jakkra/ZSWatch/.github/images/back_pcb_render.png

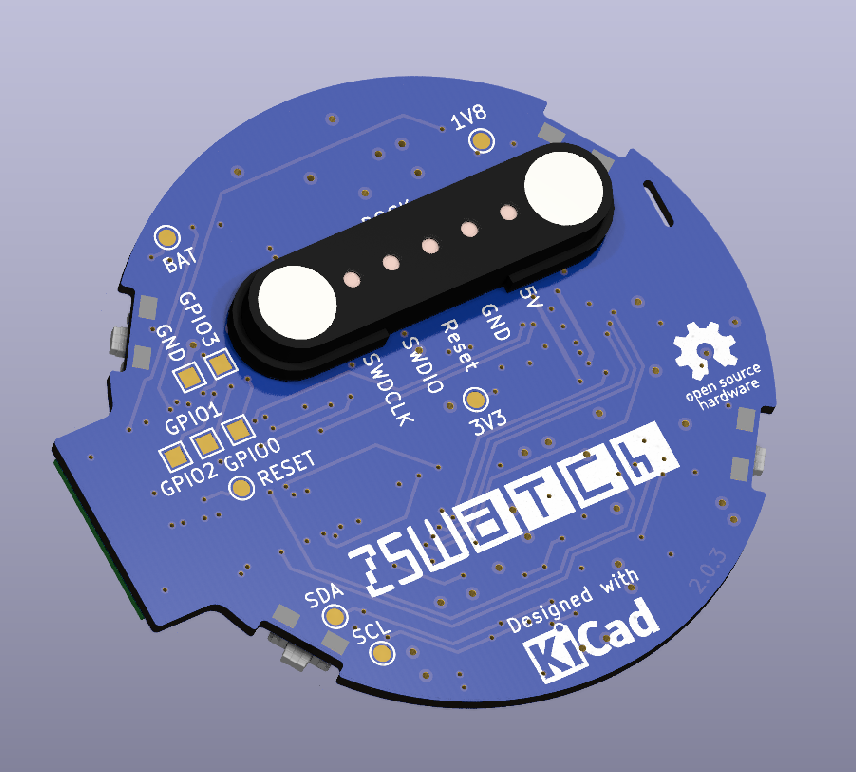
.github/images/back_pcb_render.png
