jakkra/ZSWatch/.github/images/dock_connect.jpg

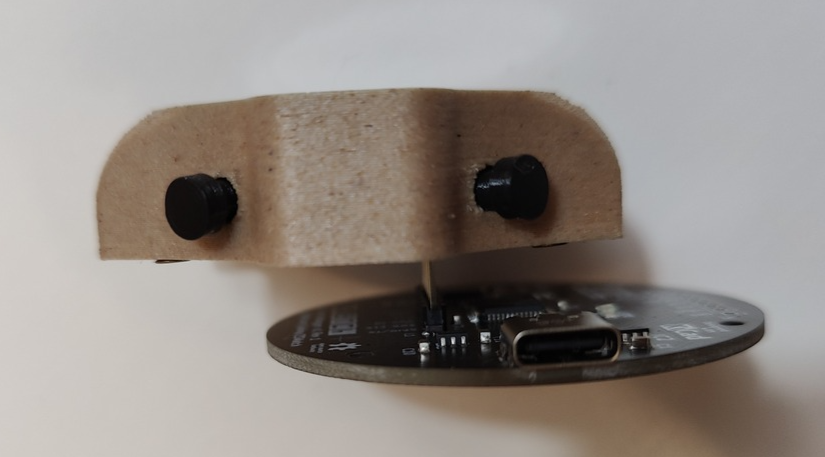
.github/images/dock_connect.jpg
