jakkra/ZSWatch/.github/images/front_pcb_render.png

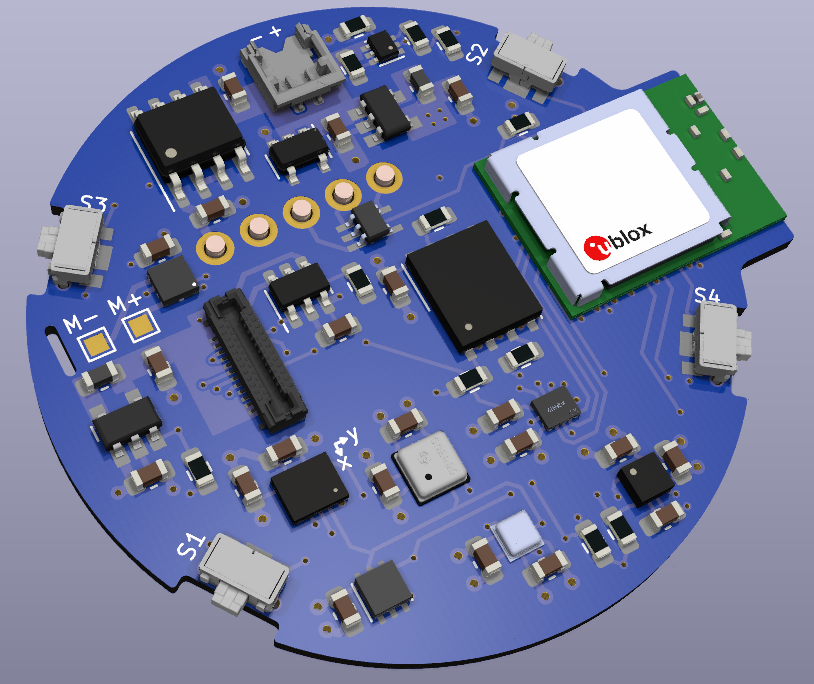
.github/images/front_pcb_render.png
