jakkra/ZSWatch/.github/images/layer1_and_4_v2.PNG

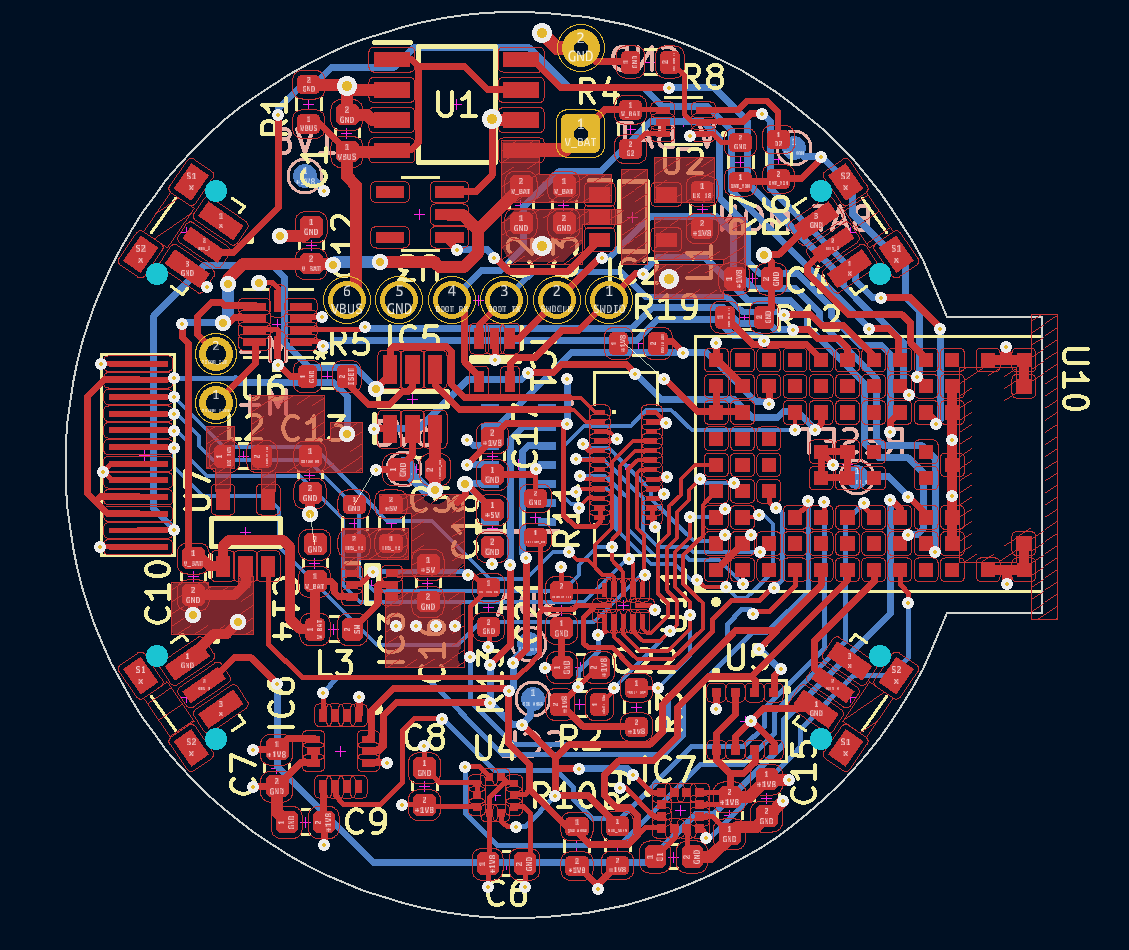
.github/images/layer1_and_4_v2.PNG
