jakkra/ZSWatch/.github/images/many_in_row.jpg

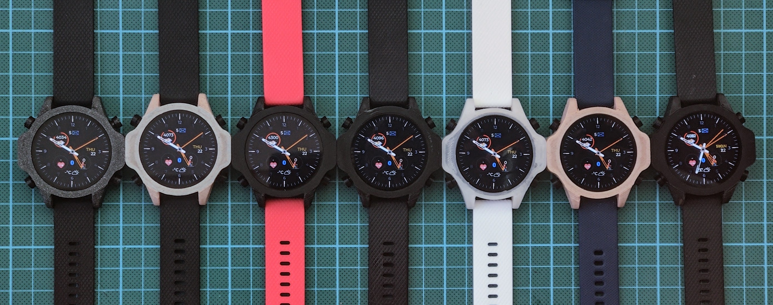
.github/images/many_in_row.jpg
