jakkra/ZSWatch/.github/images/pcb.jpg

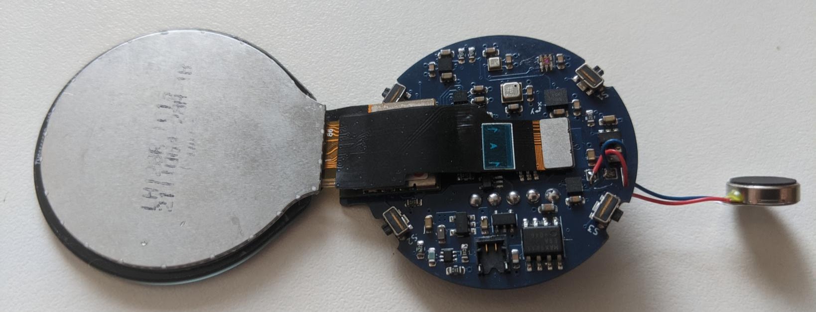
.github/images/pcb.jpg
