jakkra/ZSWatch/.github/images/pcb_features.png

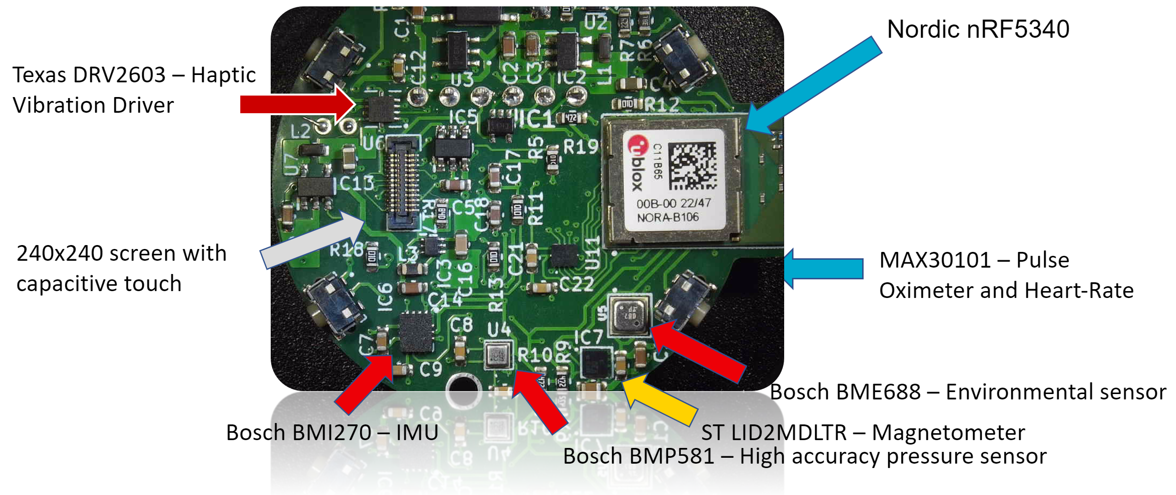
.github/images/pcb_features.png
