jakkra/ZSWatch/.github/images/presentation.png

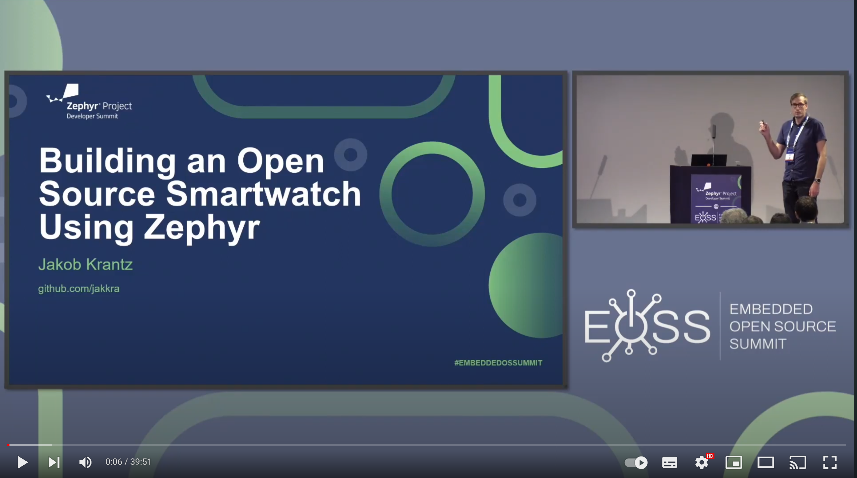
.github/images/presentation.png
