jakkra/ZSWatch/.github/images/v2_finished.png

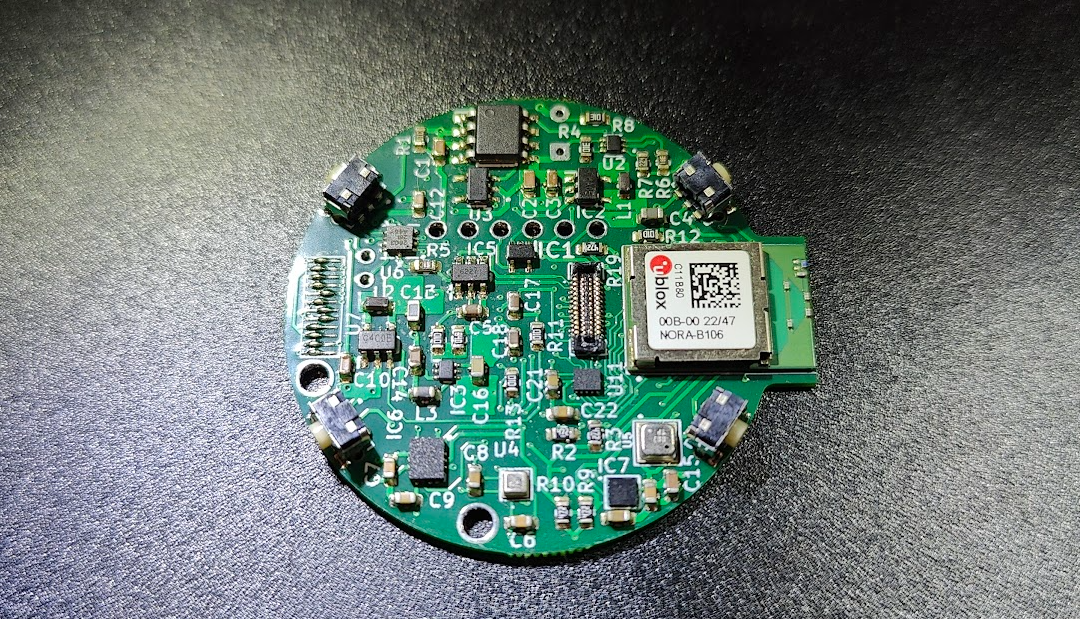
.github/images/v2_finished.png
