jakkra/ZSWatch/.github/images/watchfaces.png

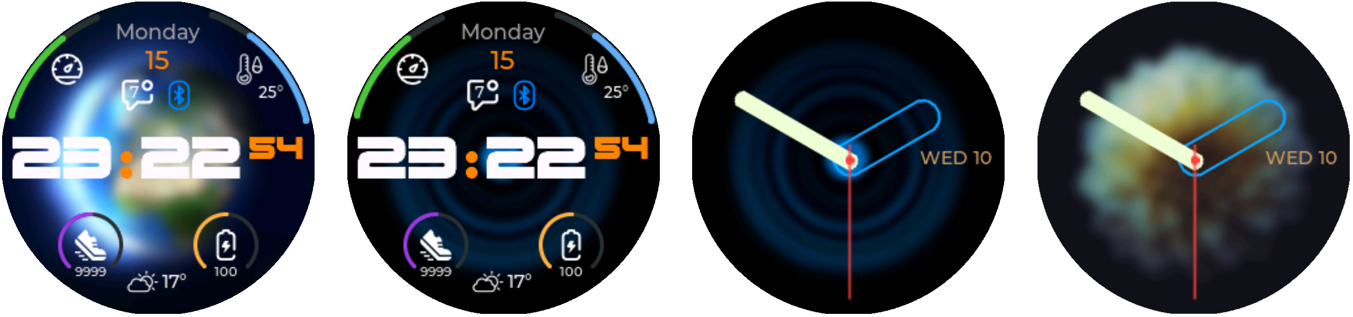
.github/images/watchfaces.png
