jakkra/ZSWatch/.github/images/parts.jpg

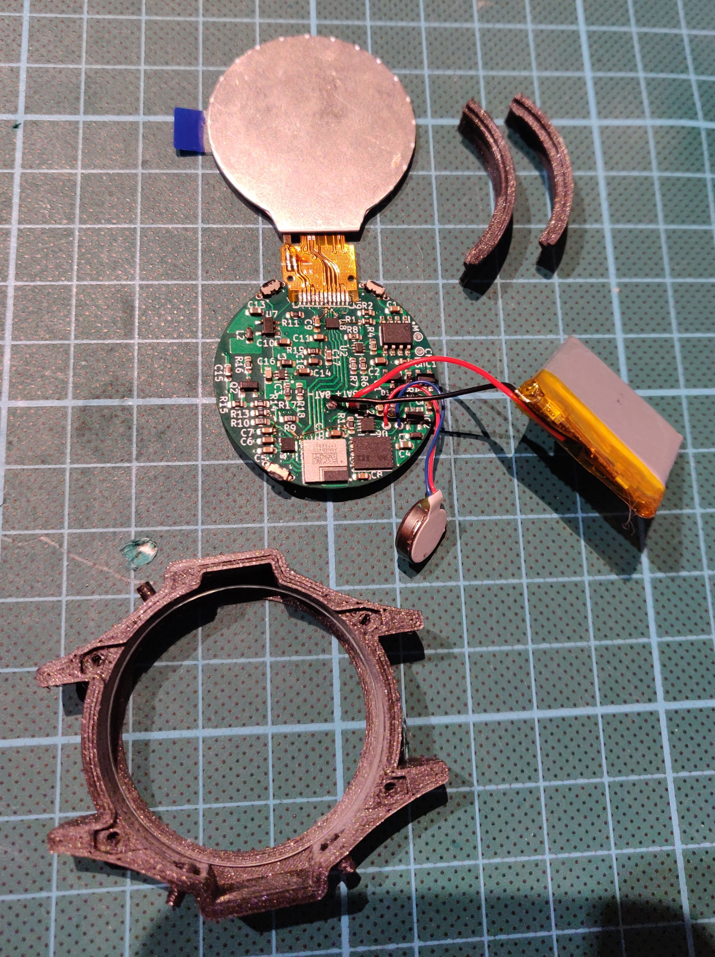
.github/images/parts.jpg
