jakkra/ZSWatch/ZSWatch-kicad-v2/pcb_outline.dxf

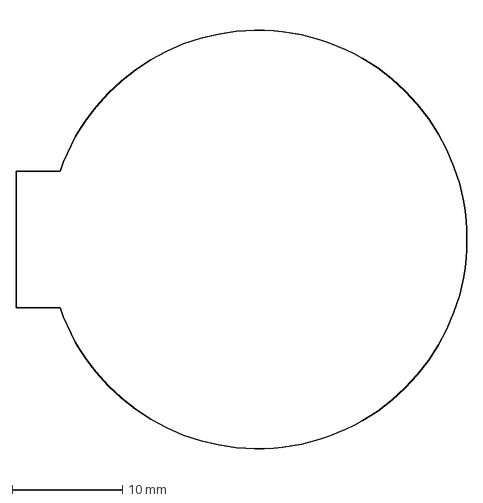
[picture p19: CAD file, 2023-03-13, last stored version]
ZSWatch-kicad-v2/pcb_outline.dxf
41.0 x 40.5 mm
