jakkra/ZSWatch/(list of files, cad)

Other CAD files:
CAD/watch-and-dock.f3z
