jakkra/ZSWatch/(threads)

Thread 2 (2023-01-13):

Display init sequence error

amrithvenkat12, 2023-01-13:
I found these errors in the display driver init sequence.
/app/drivers/display/gc9a01.c
* (line 119-121)

```
    GC9A01A1_VREG1A, 0x13,
    GC9A01A1_VREG1B, 0x13,
    GC9A01A1_VREG2A, 0x22,
```

should be

```
    GC9A01A1_VREG1A,1, 0x13,
    GC9A01A1_VREG1B,1, 0x13,
    GC9A01A1_VREG2A,1, 0x22,
```
It is missing the numArgs.

* line 112
 ``` 0xB6, 2, 0x00, 0x00,``` should be  ``` 0xB6, 2, 0x00, 0x20,```
* line 143
 ```GC9A01A_TEON, 1, GC9A01A_INVOFF,``` should be ```GC9A01A_TEON, 0,```.

In my [implementation](https://github.com/amrithvenkat12/gc9a01a_zephyr_driver/blob/main/drivers/display/display_gc9a01a.c) I have removed some redundant register inits and moved some register inits to a function call,(some registers can be initialized earlier on , like orientation and pixel format). It also has pwm based backlight control implemented.

I hope this solves the problem that you face.
Cheers,
Amrith

jakkra, 2023-01-14:
Awesome, tried your driver and could remove my color workarounds. Thanks for pointing out those diffs, but something more is missing. You driver is a bit more well done, I just hacked mine together to get it up and running. Now just need to find what I'm doing different :)

Closed 2023-01-16.

Thread 6 (2023-02-06):

Question: Why is battery superviser?

Aukstkalnis, 2023-02-06:
Hello, I am very interested in your project. I am planning to build something similar but with AMOLED display and with internal small coin battery for RTC time. I am just  curious why would you use battery supervisor chip? From your photos I can see that the battery has already integrated supervisor, so why you adding additional?

jakkra, 2023-02-06:
Hi, the issue with some (many?) of those lipo batteries is that they only cut power to itself at a very very low level, doing this (repeatedly) will damage the battery.

Aukstkalnis, 2023-02-06:
So technically, battery manager circuit that is on a battery  is not needed and can be removed. Right?

jakkra, 2023-02-06:
> So technically, battery manager circuit that is on a battery is not needed and can be removed. Right?

Still for example the battery management IC still consumes like 0.5-1uA or something, so eventuelly battery may drain and there is still a use for the battery manager circuit in the battery too. I'm not very familiar with how those integrated battery managers work, probably depends on manufactuer also.

Aukstkalnis, 2023-02-06:
OK, cool. I think it is reasonable to have backup IC for battery cut of :) Thanks for your quick replay :)

Closed 2023-02-06.

Thread 9 (2023-02-20):

How to build the app?

ShadowThree, 2023-02-20:
Hello, I am very interested in this program, but I'm new for zephyr. Now I already install the dev env at of zephyr in ubuntu22.04 according to `https://docs.zephyrproject.org/latest/develop/getting_started/index.html`. But I can't find the way to build the project, could you add some short description for How to build the app in README?
Thanks again for you awesome project.

jakkra, 2023-02-20:
Hi, I agree this should be there and will be soon. Actually I'm right now using an event library only present in the nordic nRF Connect fork of Zephyr (it's todo to make it build with stock Zephyr). But the nice thing with the nRF connect fork is that Nordic provide a simple tool to install Zephyr and the toolchain.

So to build:
- follow https://developer.nordicsemi.com/nRF_Connect_SDK/doc/latest/nrf/getting_started/assistant.html#id8
- cd into the app folder
- follow https://developer.nordicsemi.com/nRF_Connect_SDK/doc/latest/nrf/getting_started/programming.html
- west build -b smart_watch_anna_nrf52833

Let me know if this made it compile for you. I can write some better instructions tonight.

ShadowThree, 2023-02-20:
Hi, at last I built your app successfully. I got the below output(it seems the both of flash and ram are ran out of.):
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

Just recording for anyone who has the same issue:
1. Install [zephyr DEV ENV](https://docs.zephyrproject.org/latest/develop/getting_started/index.html);
2. Install [nRF connect SDK](https://developer.nordicsemi.com/nRF_Connect_SDK/doc/latest/nrf/getting_started/installing.html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) by manually (Just do the steps that NOT including in `1`);
3. Copy the `app` folder in this program to `ncs/zephyr/app`;
4. Copy the `app/boards/arm/smart_watch_anna_nrf52833` folder in this project to `ncs/zephyr/boards/arm/smart_watch_anna_nrf52833`;
5. Change path to `ncs/zephyr/app`, then run `west build -p auto -b smart_watch_anna_nrf52833 .`;

That's all, good luck！

jakkra, 2023-02-20:
@ShadowThree that's great!
Your step 1. should not be needed, both SDK and toolchain should come in 2.
Also should not need to copy anything, everything should work from within the app folder in the porject.
Boards folder should be picked upp automatically also.
I always build from the VSCode plugin, I'll make sure to have instructions for building with command line also.

About the RAM and flash, yes it's completely full :p But for v2 I'm using nRF5340, I just yesterday compiled the SW for it and now the flash usage is 41% and RAM likr 30% 🎆

ShadowThree, 2023-02-21:
@jakkra
Thanks for you goog job. I build the project by command line, where seems the VScode can't be used.
BTW, I can't wait to see your ZSWatchV2, haha.

JPHutchins, 2023-02-26:
I cannot successfully compile.  Is this built with Zephyr or NRF "Zephyr" 😄?  If NRF, WHICH NRF Zephyr lol?

JPHutchins, 2023-02-26:
Saw that you mentioned NCS 2.2.0 so I did get a build going!  Here are steps for Windows (I'll annotate for Linux/Mac compatibility but it's untested for now).

* Use Nodic's "Toolchain Manager" to install nRF Connect SDK v2.2.0
* cd to the `<root of this repo>`/app`
* Tell West to use the Nordic Zephyr is: `$env:ZEPHYR_BASE = "C:\ncs\v2.2.0\zephyr"` (Windows) `export ZEPHYR_BASE=<your NCS Zephyr location>` (Linux)
* Create a venv (you'll want to add it to .gitignore): `python3 -m venv venv` - technically you could put it anywhere (like the ncs folder, for use across multiple projects)
* Activate the venv: `. venv/scripts/activate` (Windows) `. venv/bin/activate` (Linux)
* Install dependencies: `pip install -r C:\ncs\v2.2.0\zephyr\scripts\requirements.txt` (update to your ncs install location)
* `west build -b smart_watch_anna_nrf52833`

You'd want to capture the two steps of "set ZEPHYR_BASE" and "activate venv" in an environment script for your environment.

This feels like less friction than I've encountered with Nordic's "tools" in the past 🙄 ... YMMV

jakkra, 2023-02-26:
Hi good that you got it building. If you use the open the command line from within the nRF Toolchain manager you can even skip your steps 2-5 ;)
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

Or use their VSCode plugin which also only require like 3 steps in total. I'll add building instructions.

JPHutchins, 2023-02-27:
Cool!  FYI, I am using the build as a unit test here: https://github.com/JPHutchins/avstack/tree/main/tests/fixtures/ZSWatch

Closed 2023-03-13.

Thread 16 (2023-03-30):

CAD

DREAM669, 2023-03-30:
First of all, your work currently looks good, but it seems that the first version of the watch shell can no longer meet the second version, and I am very interested in its shell style

DREAM669, 2023-03-30:
Thank you very much for your reply! I have carefully reviewed your plan and look forward to seeing your work become more and more perfect.

Closed 2023-04-15.

Thread 18 (2023-04-17):

button

DREAM669, 2023-04-17:
I have been researching the structure of your first version recently, but I cannot understand your structure in the button section. How do you specifically implement the button function? I also noticed that you have a plastic part in the physical part of the button. Is this what you bought? Can you send me a purchase link to take a look? Thank you very much!

jakkra, 2023-04-17:
Hi, yes buttons I experimented around with a bit and there may be multiple variants in the CAD model, the one I ended up using was this one, however it's not what I want in V2, will come up with something better. It's two parts glued together.

I'm not sure how I should solve this, would be nice with a part I could buy instead of printing it.
Or perhaps something I could print in place that would then snap off, not a bad idea...

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

DREAM669, 2023-04-18:
Okay, I understand what you mean. You mean that the buttons for the first version were printed in 3D by you, right? I used to think you were buying watch parts, but I searched many stores but couldn't find them.

jakkra, 2023-04-18:
Yeah 3D printed all.

Closed 2023-04-18.

Thread 19 (2023-05-19):

Is there a glitch when LDO cut-off by the voltage supervisor?

sam0910, 2023-05-19:
It is a Great Project :)
I'd like to try, but I have question about the battery supervior.

When the battery goes down to 3.6V -> NCV(supervisor) RESET_OUTPUT to low ->
Disable LDO(CE), Turn off MCU.

For charing battery,
VBUS connected -> charge battery -> if +BATT>3.6 turn LDO on by NCV

what if LCD BL and MCU drain more than charged capacity(might be low current VBUS),
is there no glitch, like turn on and off in a loop?

jakkra, 2023-05-19:
Hi, thanks for the consern, I did not really think of this.

So let's see:
First off USB should deliver at least 100mA per specification if I understand correctly.
Worst case power consumtion of the PCB should be less than 100mA always.
- Display backlight maxes at 60mA + <5mA for the actual display.
- MCU worst case around ~15-20 mA (full radio TX and 100% CPU)
- All sensors are quite low power, so 20mA should cover for those and the rest of the components.
- If heart rate sensor is mounted however, this one if configured wrongly can consume a bit of power, so maybe as a precaution this should always be disabled when charging.

But assuming we don't charge with 100mA, which IMO is not normal use, the most important thing is that nothing breaks.

So what will happen:
The watch may turns on-off repeatedly, this is not an issue, nothing will break. However draining the battery is, BUT the battery I use, and many others have built in under-discharge-protection (althought often at too low voltage for the best battery health, hence I have this extra (battery supervisor) on the PCB), this internal battery protection should trigger and battery will not be harmed, unless leaving the watch like this for a long time.

So I think it should be fine, what do you think @sam0910?

sam0910, 2023-05-20:
It will be fine for me, and I think there will be no breaks at all.
it understood there is a small chance for glitching,

I think this is most reliable project among all other open source project.
First of all, they don't care about battery life and consumptions.
I found most of them using $0.1 IC(TP4065) for battery charging.

LDO drains only from the battery that makes charging slow,
I am just a web developer and asking your good opinion,
so what about adding some switcher like below?

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

jakkra, 2023-05-21:
Thanks, I'll take this into consideration when doing next major version, I'm going to replace the charger and regulator with this one https://www.nordicsemi.com/products/Npm1100 so I'll see what more is needed than that.

sam0910, 2023-05-22:
That is great! it seems it's got LDO.

Thread 20 (2023-05-31):

CAD

DREAM669, 2023-05-31:
From the picture, it can be seen that you have already made the watch case, haven't you? How beautiful! Can you share the CAD files and take a look? I am very curious about how the button part is resolved. Thank you.

jakkra, 2023-05-31:
Yes, once I'm fully finished I will publish it, got small tuning left. Solved bottom using threaded m2 inserts, so bottom is screwed on.

DREAM669, 2023-06-02:
> Yes, once I'm fully finished I will publish it, got small tuning left. Solved bottom using threaded m2 inserts, so bottom is screwed on.

Can you share the CAD file of the watch with me first? It's really beautiful! I am very curious about its structure. Thank you.

DREAM669, 2023-06-02:
Especially for your buttons, are the buttons ready-made? Or 3D printing?

jakkra, 2023-06-02:
Still printed, I did not manage to find any suitable to buy.

jakkra, 2023-06-27:
Uploaded now

Closed 2023-06-27.

Thread 35 (2023-08-14):

Split hardware and firmware repositories

AlmazShai, 2023-08-14:
## Prerequisites
Since the ZSWatch hardware and firmware doesn't have anything in common (expect of fact that all of this related to one final product) I purpose to split it to different repositories. By growing project size and difficulties to maintain hw and fw in one repository we'll definitely end up with splitting them. I suggest doing it in early state of project before it's got too painful. By splitting the repository following advantages:
1. Possibility to setup independent pipelines
2. Follow some branching model for firmware
3. Track and handle releases/changelog clearly for firmware and hardware
4. Configure ZSWatch firmware repo as a manifest file in proper way, which provide possibility to:
-- clone project and all dependencies via single command line,
-- checkout certain version of Zephyr and modules
-- automatically apply patches to Zephyr
-- extend west command
-- ect.
5. Define issues independently -> avoid mess of TODO
6. Open root directory in VSCode which provide:
-- possibility to operate with Git extension for VSCode
-- nRF Connect extension automatically loads application
-- set up workspace and firmware specific settings

## Side effects
1. Some manual merging required for all forks
2. Content of current repo will be changes, people will not see that they expect by clicking old link

## Proposal
1. Create two new repositories named "ZSWatchFw" and "ZSWatcHw" and copy related part to there.
2. Keep current repo as a ZSWatch overview, keep demos, documentation, images.
3. Configure ZSWatch manifest repo which will include all 3 repositories and have a following tree:
ZSWatch                           # zephyr top dir
   ├─ ZSWatch
   ├─ ZSWatchHw
   ├─ ZSWatchFw
   │    └─ west.yml             # Main manifest
   ├─ zephyr
   ├─ modules
   ├─ bootloader
   ...

I don't like the idea of having hw sources in zephyr manifest, but it might be useful for someone.

jakkra, 2023-08-14:
Hi great suggestions!

My idea initially was to take the https://github.com/zephyrproject-rtos/example-application and just add another folder in the root and call it `hardware`.  OR as you suggest point to a submodule with the ZSWatch HW.

I'm sure your suggestion is much better, but I'd like to keep the SW and day to day development in this repo. Hardware I'm fine with moving. This is the repo people click to, and I want it easily to be seen what's happening, commits, etc. etc.

My proposal:
- Use example-application, copy in all code into that to match that structure.
- I convert all stuff here https://github.com/users/jakkra/projects/1 to issues (there is a feature that does that) and add some extra description/context.
    - Convert some relevant TODSs int the code to proper issues.
- Either keep HW here, or put in a new submodule.
    - I'm not fully familiar with how west modules compare to git submodules, but I'd like it to be easily browsable to like below.
    -  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

What do you think?

AlmazShai, 2023-08-14:
Fully agree with that, I hope this engage more contributors. I like the idea make this repo as main firmware repository.
> This is the repo people click to, and I want it easily to be seen what's happening, commits, etc. etc.

I don't like the keeping hardware in this repo mainly because I believe that hardware also should have it's own versioning and branch model. For now it's quite difficult to find v1 revision for example, but we can improve that by using simple tagging and following simple man/develop model.

Making hardware as a submodule also have some cons:
- west could not handle submodules
- by using submodule you always point to specific commit of child repo and it' quite difficult to track last commit in repo (always need to commit of selecting new submodule commit in parent repo). In contrast, a manifest can refer to a commit, branch or tag, which is very handy.

My main intention is not to restructure the repository (that would be nice too, of course) but to make a **clear versioning**.

jakkra, 2023-08-14:
@AlmazShai also I think today the src folder have too many files in it and it makes it harder to find/navigate also it looks more daunting for new people. Maybe as part of this since files may need to move anyway, we could restructure folder the structure a bit.

AlmazShai, 2023-08-14:
> @AlmazShai also I think today the src folder have too many files in it and it makes it harder to find/navigate also it looks more daunting for new people.
Yes you are absolutely right. But it need to be done carefully, with reworking CMake files.

> Maybe we can have a "hardware" folder and just a Readme with link or something to that repo and have it as a west module.

I see you intention to make it visible for contributor and this is right direction!!! We can create HARDWARE.md or folder, whatever you want.

jakkra, 2023-08-14:
@AlmazShai let me know if this is something you'd like to do. Otherwise I'll add it to my list and work on it later this week.

AlmazShai, 2023-08-15:
I would love to organize main manifest file!

jakkra, 2023-08-21:
I have started with some of the above discussed tasks:

- I have now converted all SW tasks to issues: https://github.com/jakkra/ZSWatch/issues
- Issues have been labeled and I tried giving all a bit more context/info in the description.
- I have prepared the new repositories for the hardware. All hardware will in the next few days be removed from this main repo and put into new ones, one for the ZSWatch main PCB and one for the dock pcb

jakkra, 2023-10-01:
Done!

Closed 2023-10-01.

Thread 42 (2023-08-21):

Bosch BME688 BSEC library. Allows for air quality measurement and more.

jakkra, 2023-08-21:
This is a binary blob and shall be optional to use (opt-in)

This blob needs to be downloaded from here by each person compiling (I think): https://www.bosch-sensortec.com/software-tools/software/bsec/

But this blob allows for the advanced features of the BMP588, such as air quality etc.

- Integrate this library and add functions to get this data
- Document how to set this up (download, where to put the lib etc.)

vChavezB, 2023-08-22:
Good to know about this. Since I already have soldered a board with the BME688 if I have some time I will try to check this out. My use case is testing on my fridge and knowing if food goes bad 😄

Kampi, 2023-10-30:
The Bosch BSEC library is added to the firmware, together with an application to visualize the IAQ index.

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

Closed 2023-10-30.

Thread 43 (2023-08-21):

Rework vibration, it needs to use timers instead of delays to run patterns.

jakkra, 2023-08-21:
Right now `k_msleep` is used to delay in vibrations, this is super bad.
Vibrations needs to be able to run "in background".
Use timers instead to do vibrations.
Add a way to choose what vibration pattern to play.

Code: https://github.com/jakkra/ZSWatch/blob/main/app/src/vibration_motor.c

Closed 2023-08-26.

Thread 44 (2023-08-21):

Auto patches to Zephyr when compiling

jakkra, 2023-08-21:
There are some patches, for example to upscale native_posix SDL display.
Would be handy to automatically apply those patches when complinging.

vChavezB, 2023-08-22:
Golioth has a script to run a patch command when using the manifest file

https://github.com/golioth/golioth-zephyr-sdk/blob/main/scripts/west_commands/patch.py

and you can see it in action here

https://github.com/golioth/golioth-zephyr-sdk/blob/cc146c1e0d4f2c666a37da3b6de7cc5902367484/west-ncs.yml#L15

This issue would be related to first setting up a manifest file as mentioned in https://github.com/jakkra/ZSWatch/issues/35

ldab, 2023-11-15:
@jakkra I can only see “ app/zephyr_patches/sdl_upscale.patch” is there another one?

Kampi, 2023-11-15:
@ldab we have a patch for the nPM1300 driver which is necessary for later revisions with the new power management. It´s not checked in in Git, so you can add it if you want

[ntc_fix.patch](https://github.com/jakkra/ZSWatch/files/13367904/ntc_fix.patch)

jakkra, 2023-11-15:
@ldab do note that this sdl patch does not work anymore, that code was refactored. It's not necessary, so it can be removed.

ldab, 2023-11-15:
> @ldab do note that this sdl patch does not work anymore, that code was refactored. It's not necessary, so it can be removed.

both `kscan_sdl.c` and `display_sdl.c` are not required anymore? How to make the screen bigger?

jakkra, 2023-11-15:
> > @ldab do note that this sdl patch does not work anymore, that code was refactored. It's not necessary, so it can be removed.
>
> both `kscan_sdl.c` and `display_sdl.c` are not required anymore? How to make the screen bigger?

Well they are needed to scale it up, but requires re-doing this patch. But current default not scaled is useable also.

Kampi, 2023-11-23:
@jakkra @ldab
CI/CD is reporting this

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

jakkra, 2023-11-23:
> @jakkra @ldab CI/CD is reporting this
>
> 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

I got a fix incoming.

ldab, 2023-11-24:
Strange, main gives me:

```
-- west build: generating a build system
patching file modules/lvgl/input/lvgl_common_input.c
Reversed (or previously applied) patch detected!  Assume -R? [n]
Apply anyway? [n]
Skipping patch.
1 out of 1 hunk ignored
patching file modules/lvgl/input/lvgl_common_input.h
Reversed (or previously applied) patch detected!  Assume -R? [n]
Apply anyway? [n]
Skipping patch.
1 out of 1 hunk ignored
patching file drivers/sensor/npm1300_charger/npm1300_charger.c
Reversed (or previously applied) patch detected!  Assume -R? [n]
Apply anyway? [n]
Skipping patch.
1 out of 1 hunk ignored
```

In order to reproduce I tried:

1. Clean the build folder
2. Pristine build
3. Build again
4. Clean changes on Zephyr repo

Can't reproduce it

jakkra, 2023-11-24:
Fixed now and CI as good. Works locally also for me.
https://github.com/jakkra/ZSWatch/commit/694798a6fd55b2753d6025e603d2a14534c9c692

Closed 2023-11-24.

Thread 48 (2023-08-21):

Received notifications should be propogated as zbus event.

jakkra, 2023-08-21:
Remove the callback used here https://github.com/jakkra/ZSWatch/blob/main/app/src/ble_comm.c#L535C5-L535C19 and use ZBUS event instead also for notifications.

In order to know when all subscribers and listeners are done with the event, see this approach here: See example how to do it here: https://github.com/zephyrproject-rtos/zephyr/pull/59071/files

ldab, 2023-11-15:
Is this still relevant? Otherwise it would be better to do it before #61

Kampi, 2023-11-15:
@jakkra does it make sense to propagate also the connected and disconnected callbacks via ZBUS? I can do the ZBUS change if it´s okay because the sensor subsystem modification also needed some stuff for ZBUS and then I can add the BLE stuff too.

jakkra, 2023-11-15:
Sure, but be careful of context of the notifications, I think that's why they are not yet distributed over zbus, as they can be overwritten. @Kampi read this https://discord.com/channels/720317445772017664/1042530682011926631/1113790721133129738 first

jakkra, 2023-11-15:
> Is this still relevant? Otherwise it would be better to do it before #61

Hmm, they touch the same code, but the order doesn't really matter. If notifications are sent over zbus or callback it's just a few lines of common code, so I think they can be worked on in parallel also. Or any order.

Kampi, 2023-11-15:
IMO you can start working on the iOS stuff because the sensor testing and the ZBUS modification will need some time.

jeffwelder-ellenbytech, 2023-11-15:
If you have not checked out the new message subscriber feature of zbus it might be worth looking at. 😄

`ZBUS_MSG_SUBSCRIBER_DEFINE()`
https://docs.zephyrproject.org/latest/services/zbus/index.html

Kampi, 2023-11-15:
Thanks @jeffwelder-ellenbytech

I will take a look at it.

jakkra, 2023-11-15:
> If you have not checked out the new message subscriber feature of zbus it might be worth looking at. 😄
>
> `ZBUS_MSG_SUBSCRIBER_DEFINE()` https://docs.zephyrproject.org/latest/services/zbus/index.html

Looks interesting, but from what I see it requires a thread with stack for each subscriber, which is what I want to avoid as it wastes alot of RAM. Best would be to always use the system work queue for all messages, but not exactly sure how to implement that.

Kampi, 2023-11-20:
@ldab I added ZBUS to the `BLE_enhancements#124` branch and tested it with GadgetBridge and a subscriber and it looks good.

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

I´ve added it also to the Apple Notification service. If you have time, can you please test it? :)

ldab, 2023-11-20:
It looks like the content/title/body is missing or got lost, it was supposed to print

mobile phone
Incoming call

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

jakkra, 2023-11-20:
> @Kampi maybe this change you did that caused this issue https://github.com/jakkra/ZSWatch/blob/main/app/src/main.c#L358
>
> body => sender (I guess it's not populated the same in iOS code)

I'm fixing it now

Kampi, 2023-11-20:
Yeah was a bad testing by me because I only tested it with Gadgetbridge

Closed 2023-12-05.

Thread 53 (2023-08-21):

Calculate battery usage over the day etc in battery app

jakkra, 2023-08-21:

jakkra, 2023-08-21:
Forgot what I meant with this issue. Close for now...

Closed 2023-08-21.

Thread 60 (2023-08-21):

Algorithm to detect facing away watch to turn off faster intstead of 30 second timeout

jakkra, 2023-08-21:

Kampi, 2023-11-23:
@jakkra what do you think? Can we use the "Flick-in" / "Flick-out" gestures of the IMU for it?

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

The BMI270-Plus driver supports them. So maybe there is no algorithm needed.

jakkra, 2023-11-23:
@Kampi My experience with the various gestures is that they sometimes trigger randomly also. But good idea with the "flick out", we can try it and see how it works :+1:

Kampi, 2023-11-23:
I didn't understand the gesture completely during my tests, but I think it was because I have used the wrong axis setup. We have to take care that the coordinate system of the different watch revisions is the same as in the datasheet to test it properly.

Thread 62 (2023-08-21):

Compass: Use accel to compensate for tilt

jakkra, 2023-08-21:
Currently compass app does not work unless watch is put flat.
This can be solved by using an algorithm that compensates for the tilt of the watch.

Kampi, 2023-10-31:
Moved to #99

Closed 2023-10-31.

Thread 66 (2023-08-21):

Navigation instructions on the watch gadgetbridge supports sending directions to watch

jakkra, 2023-08-21:

ldab, 2023-11-18:
Works on iOS

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

Kampi, 2023-11-18:
> Works on iOS
>
> 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

Really cool :)
I see we have to rework the Android stuff too, so we can support all functions on iOS and Android

jakkra, 2023-11-18:
Cool, this is mostly UI work that's needed for this.

Thread 69 (2023-08-21):

Indicate some way that charging started

jakkra, 2023-08-21:
For example UI popup or a small vibration.

Info already published on `ZBUS_CHAN_DECLARE(chg_state_data_chan);`

Kampi, 2023-12-05:
@jakkra we have to think about a solution for how this should be handled with rev 5. I don´t think that this can be done with Device Tree only, because currently the input subsys is used for it, and with rev 5 the nPM1300 driver handles this.

jakkra, 2023-12-05:
@Kampi  I think we remove it for < v5, I'll do a PR

Closed 2023-12-05.

Thread 71 (2023-08-21):

Once going to 128MHz, power consumption stays high even after going back to low (going back probably not working)

jakkra, 2023-08-21:
Requires ability to measure current consumotion, using for example Nordic PPK2.

Issue probably in this file: https://github.com/jakkra/ZSWatch/blob/main/app/src/zsw_cpu_freq.c

jakkra, 2024-01-30:
Working now

Closed 2024-01-30.

Thread 72 (2023-08-21):

Crashes when randomly spamming buttons

jakkra, 2023-08-21:

jakkra, 2023-12-10:
Fixed

Closed 2023-12-10.

Thread 75 (2023-08-29):

native posix build does not work

MohammadMokhalled, 2023-08-29:
I am trying to build native posix project. I get the following error. Am I doing something wrong or the build script is corrupted?

```
-- west build: generating a build system
Loading Zephyr default modules (Zephyr base (cached)).
-- Application: /home/mohammad/zephyrproject/projects/ZSWatch/app
-- CMake version: 3.27.4
-- Cache files will be written to: /home/mohammad/.cache/zephyr
-- Zephyr version: 3.4.99 (/home/mohammad/zephyrproject/zephyr)
-- Found west (found suitable version "1.1.0", minimum required is "0.14.0")
-- Board: native_posix
-- Found host-tools: zephyr 0.16.1 (/home/mohammad/zephyr-sdk-0.16.1)
-- Found toolchain: host (gcc/ld)
-- Found BOARD.dts: /home/mohammad/zephyrproject/zephyr/boards/posix/native_posix/native_posix.dts
-- Found devicetree overlay: /home/mohammad/zephyrproject/projects/ZSWatch/app/boards/native_posix.overlay
-- Generated zephyr.dts: /home/mohammad/zephyrproject/projects/ZSWatch/app/build/zephyr/zephyr.dts
-- Generated devicetree_generated.h: /home/mohammad/zephyrproject/projects/ZSWatch/app/build/zephyr/include/generated/devicetree_generated.h
-- Including generated dts.cmake file: /home/mohammad/zephyrproject/projects/ZSWatch/app/build/zephyr/dts.cmake

warning: SENSOR (defined at drivers/sensor/Kconfig:6) was assigned the value 'n' but got the value
'y'. See http://docs.zephyrproject.org/latest/kconfig.html#CONFIG_SENSOR and/or look up SENSOR in
the menuconfig/guiconfig interface. The Application Development Primer, Setting Configuration
Values, and Kconfig - Tips and Best Practices sections of the manual might be helpful too.

warning: MAX30101_SLOT1 (defined at drivers/sensor/max30101/Kconfig:143) was assigned the value '1'
but got the value ''. Check these unsatisfied dependencies: MAX30101_MULTI_LED_MODE (=n), MAX30101
(=n). See http://docs.zephyrproject.org/latest/kconfig.html#CONFIG_MAX30101_SLOT1 and/or look up
MAX30101_SLOT1 in the menuconfig/guiconfig interface. The Application Development Primer, Setting
Configuration Values, and Kconfig - Tips and Best Practices sections of the manual might be helpful
too.

warning: MAX30101_SLOT2 (defined at drivers/sensor/max30101/Kconfig:158) was assigned the value '2'
but got the value ''. Check these unsatisfied dependencies: MAX30101_MULTI_LED_MODE (=n), MAX30101
(=n). See http://docs.zephyrproject.org/latest/kconfig.html#CONFIG_MAX30101_SLOT2 and/or look up
MAX30101_SLOT2 in the menuconfig/guiconfig interface. The Application Development Primer, Setting
Configuration Values, and Kconfig - Tips and Best Practices sections of the manual might be helpful
too.

warning: MAX30101_SLOT3 (defined at drivers/sensor/max30101/Kconfig:173) was assigned the value '3'
but got the value ''. Check these unsatisfied dependencies: MAX30101_MULTI_LED_MODE (=n), MAX30101
(=n). See http://docs.zephyrproject.org/latest/kconfig.html#CONFIG_MAX30101_SLOT3 and/or look up
MAX30101_SLOT3 in the menuconfig/guiconfig interface. The Application Development Primer, Setting
Configuration Values, and Kconfig - Tips and Best Practices sections of the manual might be helpful
too.

warning: MAX30101_SLOT4 (defined at drivers/sensor/max30101/Kconfig:188) was assigned the value '0'
but got the value ''. Check these unsatisfied dependencies: MAX30101_MULTI_LED_MODE (=n), MAX30101
(=n). See http://docs.zephyrproject.org/latest/kconfig.html#CONFIG_MAX30101_SLOT4 and/or look up
MAX30101_SLOT4 in the menuconfig/guiconfig interface. The Application Development Primer, Setting
Configuration Values, and Kconfig - Tips and Best Practices sections of the manual might be helpful
too.

warning: PM (defined at subsys/pm/Kconfig:13) was assigned the value 'y' but got the value 'n'.
Check these unsatisfied dependencies: HAS_PM (=n). See
http://docs.zephyrproject.org/latest/kconfig.html#CONFIG_PM and/or look up PM in the
menuconfig/guiconfig interface. The Application Development Primer, Setting Configuration Values,
and Kconfig - Tips and Best Practices sections of the manual might be helpful too.

warning: The choice symbol MAX30101_MULTI_LED_MODE (defined at drivers/sensor/max30101/Kconfig:62)
was selected (set =y), but no symbol ended up as the choice selection. See
http://docs.zephyrproject.org/latest/kconfig.html#CONFIG_MAX30101_MULTI_LED_MODE and/or look up
MAX30101_MULTI_LED_MODE in the menuconfig/guiconfig interface. The Application Development Primer,
Setting Configuration Values, and Kconfig - Tips and Best Practices sections of the manual might be
helpful too.

warning: The choice symbol NEWLIB_LIBC (defined at lib/libc/Kconfig:85) was selected (set =y), but
EXTERNAL_LIBC (defined at lib/libc/Kconfig:101) ended up as the choice selection. See
http://docs.zephyrproject.org/latest/kconfig.html#CONFIG_NEWLIB_LIBC and/or look up NEWLIB_LIBC in
the menuconfig/guiconfig interface. The Application Development Primer, Setting Configuration
Values, and Kconfig - Tips and Best Practices sections of the manual might be helpful too.

/home/mohammad/zephyrproject/projects/ZSWatch/app/prj.conf:36: warning: attempt to assign the value 'n' to the undefined symbol KSCAN_CST816S

/home/mohammad/zephyrproject/projects/ZSWatch/app/prj.conf:183: warning: attempt to assign the value '5' to the undefined symbol ZBUS_RUNTIME_OBSERVERS_POOL_SIZE

error: Aborting due to Kconfig warnings
Parsing /home/mohammad/zephyrproject/projects/ZSWatch/app/Kconfig
Loaded configuration '/home/mohammad/zephyrproject/zephyr/boards/posix/native_posix/native_posix_defconfig'
Merged configuration '/home/mohammad/zephyrproject/projects/ZSWatch/app/prj.conf'
Merged configuration '/home/mohammad/zephyrproject/projects/ZSWatch/app/boards/native_posix.conf'

CMake Error at /home/mohammad/zephyrproject/zephyr/cmake/modules/kconfig.cmake:348 (message):
  command failed with return code: 1
Call Stack (most recent call first):
  /home/mohammad/zephyrproject/zephyr/cmake/modules/zephyr_default.cmake:129 (include)
  /home/mohammad/zephyrproject/zephyr/share/zephyr-package/cmake/ZephyrConfig.cmake:66 (include)
  /home/mohammad/zephyrproject/zephyr/share/zephyr-package/cmake/ZephyrConfig.cmake:97 (include_boilerplate)
  CMakeLists.txt:15 (find_package)

-- Configuring incomplete, errors occurred!
FATAL ERROR: command exited with status 1: /usr/bin/cmake -DWEST_PYTHON=/usr/bin/python3 -B/home/mohammad/zephyrproject/projects/ZSWatch/app/build -GNinja -S/home/mohammad/zephyrproject/projects/ZSWatch/app

```

jakkra, 2023-08-29:
Hi, I'm pretty sure the build is OK as I built today the native_posix and the CI is working https://github.com/jakkra/ZSWatch/actions/runs/5993444226/job/16253894849 so it's probably something with your setup.

Let's see.
- Are you using Zephyr 3.4.0? Looks like you are using 3.4.99.  Zephyr 3.4.0 is supported. Those errors could be due to that. There are some updated needed to support latest main on Zephyr.

Thread 78 (2023-09-19):

APDS 9306 065 light sensor driver

jakkra, 2023-09-19:
Needed for rev 3 ZSWatch
`zsw_light_sensor.c` contains just code for reading chip ID right now.
Write a proper driver for it.

Kampi, 2023-10-09:
The first iteration of the driver is ready to be used.

**TODO**
- Remove PM code, because the IC doesn´t have any advanced PM features
- Add IRQ support (not mandatory for the watch)
- Add conversion from bin to Lux?

Closed 2023-10-11.

Thread 87 (2023-10-10):

Rework button and touch handling

Kampi, 2023-10-10:
**Idea**

- Use the input subsystem to handle all events (touch and buttons)
- Create a driver for LVGL that contains the input subsystem handling. So we are able to control the inputs that are passed to LVGL
- Apply different key IDs to all buttons

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

**References**

https://docs.zephyrproject.org/latest/services/input/index.html#c.INPUT_CALLBACK_DEFINE
https://docs.zephyrproject.org/latest/build/dts/api/bindings/input/zephyr,input-longpress.html

jakkra, 2023-10-21:
@Kampi Can be closed?

Closed 2023-10-21.

Thread 95 (2023-10-24):

Add condition to enable file system in configuration for rev 3 and above

Kampi, 2023-10-24:
`CONFIG_FILE_SYSTEM` and `CONFIG_LV_Z_USE_FILESYSTEM` in `proj.conf` (or somewhere else) should only be set to `y` by default if the target is rev 3 or above. Can we add a revision-specific configuration?

jakkra, 2023-10-24:
It's already: https://github.com/jakkra/ZSWatch/blob/main/app/boards/arm/zswatch_nrf5340/zswatch_nrf5340_cpuapp_3.conf#L19
For rev 4, a new copy of this file should be added and called _4.conf.

Was it something else you whee after? Unfortunately you cannot have conditional logic directly in `prj.conf`

Kampi, 2023-10-24:
Great. Should be a perfect solution.

Closed 2023-10-24.

Thread 96 (2023-10-24):

Reworking sensor handling

Kampi, 2023-10-24:
### General

- [x] Use the sensor subsystem for all sensors
- [x] This requires a proper driver for all Bosch sensors
- [x] Rework all sensor related apps
- [x] Proper integration of the Bosch BSEC library as a driver
- [x] Can we remove the alias for BMI270 and LIS2MDL from DT?

### APDS9306

- [ ] Add gain and conversion time to measurement result from APDS9306 driver (see [here](https://github.com/gmarti/AsyncAPDS9306/blob/master/AsyncAPDS9306.cpp#L35))
- [x] Add ZBUS for all sensors
- [x] Connect the sensor ZBUS with the slow periodic events of the system
- [x] Initial sensor configuration via DT (`.resolution = DT_INST_PROP(inst, resolution),`). See [here](https://github.com/jakkra/ZSWatch/blob/8794193393a92eb8b7ed4ab2719392b841fc4707/app/src/ext_drivers/bmi270/bmi270_port.c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)
- [x] Change name for logging

### BMI270

- [x] Clean way for driver compat for BMI270
- [x] Move the axis remapping from the driver code to the application code or in the DTS
- [x] Add Interrupt support
- [x] Step counter
- [x] DEVICE_DT_GET_OR_NULL in `zsw_imu`
- [x] Advanced power feature used?
- [ ] Reset step counter feature

Closed 2023-11-18.

Thread 99 (2023-10-30):

Improve compass app

Kampi, 2023-10-30:
- Improve calibration to let the app tell the user when calibration is done
- Store calibration data in flash
- Add an option to trigger a new calibration (i. e. a button)

Kampi, 2023-12-05:
@jakkra you did some stuff for the app. Are we done here and can we close it?

jakkra, 2023-12-05:
> @jakkra you did some stuff for the app. Are we done here and can we close it?

Still need the accelerator compensation. But we can

Kampi, 2023-12-05:
I have added this point as ToDo :)

Thread 102 (2023-11-02):

Light sensor doesn´t work in sensor summary

Kampi, 2023-11-02:
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

Kampi, 2023-11-02:
Fixed. The label doesn´t get filled with data.

Closed 2023-11-02.

Thread 112 (2023-11-16):

Common API for communication back to phone apps

jakkra, 2023-11-16:
This can remove `#ifdefs` in all application code that sends information back to a phone.

Suggested to create a header file with necessary functions such as "next track" etc.

Then we have two implemementations for it, one for Gadgetbridge and one for iOS.
We choose which one to compile depending on if the compile for Android or iOS

ldab, 2023-11-18:
I think the FW should be build for both phones and from the connection it can know what type of command to use, no ifdefs, no different headers

jakkra, 2023-11-18:
> I think the FW should be build for both phones and from the connection it can know what type of command to use, no ifdefs, no different headers

Yes true, can be dynamic, it's easily detectable as we know directly if the phone have the apple services, it's an iPhone.

ldab, 2023-11-18:
I was thinking we can use the company identifier to determine the device.

alternatively hook the play/pause etc action to a Zbus fire and forget, down the line the GATT client will not be able to write if the service is not available, sanitising it that way, very simple, I do not see the downside of doing it that way

Kampi, 2023-11-18:
Maybe we can add both variants? Build up Android and iOS separately, enable both by default, and let the user decide to disable one of those to save code space. IMHO for me iOS isn´t relevant and I don´t need it, because I´m using Android.

jakkra, 2023-11-18:
I don't care which way, the only reason I see to have it a compile thing is that it will not work with upstream Zephyr and need NCS, and that is handy as sometimes when needed to try some patch etc.
But should not make it much more complicated to keep them compile options but allow both, just need to think a bit how to structure it.

ldab, 2023-11-18:
I haven’t tried but theoretically one can set the zephyr downstream version if needed on the west.yml

jakkra, 2023-11-18:
You can, but often it won't compile as the ncs stuff is not compatilbe with newer zephyr

Thread 114 (2023-11-17):

Unable to burn code, unable to recognize MCU

DREAM669, 2023-11-17:
Hello, I have created a PCB after referencing your first schematic diagram. Of course, this version uses TXB0104 with external Flash, but there is a phenomenon: the first time it can be successfully burned, the screen is lit, and the touch is invalid (caused by TXB0104); But there was a burning failure later, and the MCU could not be recognized. Have you ever encountered it? Thank you very much!

Kampi, 2023-11-17:
Hi @DREAM669

can you please paste in the error message so we can take a look at it?

DREAM669, 2023-11-20:
-- west flash: using runner nrfjprog
-- runners.nrfjprog: Flashing file: e:\ZSWatch-main_newbard\app\build\zephyr\merged_domains.hex
-- runners.nrfjprog: e:\ZSWatch-main_newbard\app\build\zephyr\merged_domains.hex targets both nRF53 coprocessors; splitting it into: e:\ZSWatch-main_newbard\app\build\zephyr\GENERATED_CP_NETWORK_merged_domains.hex and e:\ZSWatch-main_newbard\app\build\zephyr\GENERATED_CP_APPLICATION_merged_domains.hex
[error] [ Client] - Encountered error -90: Command read_memory_descriptors executed for 15 milliseconds with result -90
[error] [ Worker] - Can't read memory descriptors, ap-protection is enabled.
[error] [ Client] - Encountered error -90: Command erase_file executed for 92 milliseconds with result -90
[ ######               ]   0.000s | Erase file - Check image                                                       [ #####                ]   0.000s | Check image validity - Initialize device info                                  [ ##########           ]   0.000s | Check image validity - Check region 0 settings                                 [ ###############      ]   0.000s | Check image validity - block 1 of 2                                            [error] [  nRF53] - Failed while detecting device memory block protection status!
[error] [  nRF53] - Failed while erasing device. -90: Access protection is enabled, can't read block protection state.
[error] [ Worker] - Access protection is enabled, can't read block protection state.
ERROR: The operation attempted is unavailable due to readback protection in
ERROR: your device. Please use --recover to unlock the device.
NOTE: For additional output, try running again with logging enabled (--log).
NOTE: Any generated log error messages will be displayed.
ERROR: runners.nrfjprog: Flashing failed because the target must be recovered.
  To fix, run "west flash --recover" instead.
  Note: your target is an nRF53; all flash memory for both the network and application cores will be erased prior to reflashing.
FATAL ERROR: command exited with status 24: nrfjprog --program 'e:\ZSWatch-main_newbard\app\build\zephyr\GENERATED_CP_NETWORK_merged_domains.hex' --sectorerase --verify -f NRF53 --coprocessor CP_NETWORK --snr 1050050002

 *  The terminal process terminated with exit code: 24.
 *  Terminal will be reused by tasks, press any key to close it.

DREAM669, 2023-11-20:
Hi,@Kampi
I'm sorry, I was too busy the other day and forgot about it. Could you please help me check this error? Thank you very much!

jakkra, 2023-11-20:
@DREAM669 You have the error there in your log:
```
ERROR: The operation attempted is unavailable due to readback protection in
ERROR: your device. Please use --recover to unlock the device.
NOTE: For additional output, try running again with logging enabled (--log).
NOTE: Any generated log error messages will be displayed.
ERROR: runners.nrfjprog: Flashing failed because the target must be recovered.
To fix, run "west flash --recover" instead.
```

Did this not work?
`west flash --recover`

If it doesn't work try running those manually instead of through west:
```
nrfjprog -f NRF53 --recover --coprocessor CP_NETWORK
nrfjprog -f NRF53 --recover
```

DREAM669, 2023-11-21:
Thank you very much. The problem has been resolved.

Closed 2023-11-21.

Thread 118 (2023-11-19):

Button to clear all notifcations

Kampi, 2023-11-19:

Kampi, 2023-11-26:
Needs a more detailed rework of the UI, because currently the whole screen is used for the scrolling area.

Thread 124 (2023-11-19):

BLE enhancements

Kampi, 2023-11-19:
Collection of different BLE topics

**ToDo**

- [x] Add timeout for enabled pairing
- [x] Fix bug with wrong JSON splitting in `ble_comm.c`
- [x] #48
- [ ] #54
- [x] #109
- [ ] #112
- [ ] #72
- [x] Update device information for Device Information service
- [x] Can we move all Gadgetbridge related stuff in a separate file?
- [x] Do we really need to connect and disconnect on ZBUS because apps should use Zephyr API (decide when we close the PR)?

**Open issues with notifications**

- [x] Crashing when leaving the notifications list when a notification is available
- [x] Longer notifications the body can't be seen (I guess LVGL scrolls to the bottom or something)
- [x] Sometimes the age of notification shows a huge number
- [x] Easy to accidentally remove the notification when scrolling it
- [x] Convert the age into a nice time format
- [x] Scrolling of the body field is strange
- [x] Sometimes the body field will be focused
- [x] Scrolling the notification list can be a little bit weird. I guess because of the scrolling body field. Need to check it in detail
- [ ] Hide notification popup when the app is open. Here we should think about an API to get the app status
- [ ] Notification is not 100% centered
- [ ] [Scroll one](https://docs.lvgl.io/master/overview/scroll.html#scroll-one)
- [x] Notification removal on the phone doesn´t work
- [ ] Support for YouTube notifications
- [x] Support for WhatsApp notificaitons

Kampi, 2023-11-21:
@ldab

I split the Gadgetbridge related code up into a separate source file.

https://github.com/jakkra/ZSWatch/tree/BLE_enhancements%23124

ldab, 2023-11-21:
Will check the PR tomorrow 👊

Kampi, 2023-11-25:
We are changing the communication flow for notifications to this
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

This allows us to create and push internal notifications to the notification manager. The notification manager is the main instance in handling all notifications.

@jakkra @ldab
I pushed the latest version of the notification rework. Feel free to test this version and give some feedback :)
Not 100% nice now, but it´s working.

**Changes so far**

- New layout
- Different icons for WhatsApp, Mail, etc.
- Title and body field
- Scrollable body (not sure if I will keep it)
- Age of the notification
- Scrolling improvement
- Notifications will be added to the notification app when the app is open

**Known changes**

- Convert the age into a nice time format
- Scrolling of the body field is strange
- Sometimes the body field will be focused
- Scrolling of the notification list can be a little bit weird. I guess because of the scrolling body field. Need to check it in detail
- Hide notification popup when the app is open. Here we should think about an API to get the app status

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

ldab, 2023-11-25:
The latest commit does not seem to build on CI, I haven’t looked as why, but is this ready to feedback?

Kampi, 2023-11-25:
@ldab the build fails because of the style.

jakkra, 2023-11-25:
@Kampi Running it today!
Some quick things:
- Send some notfications
  - Enter notification list
  - Exist -> crash

- Longer notifications the body can't be seen

Kampi, 2023-11-25:
>   * Enter notification list
>   * Exist -> crash
> * Easy to accidentally remove the notification when scrolling it

@jakkra fixed :)

Closed 2023-12-05.

Thread 136 (2023-11-22):

Enclosure

DREAM669, 2023-11-22:
Hello, I would like to ask, did you not upload the 3D file of the enclosure? I didn't find it. Thank you for your reply!

Kampi, 2023-11-22:
Hi @DREAM669

Please check the `cad` directory in the hardware repository.
https://github.com/jakkra/ZSWatch-HW

DREAM669, 2023-11-22:
Okay, I understand. Thank you!

jakkra, 2023-11-22:
@DREAM669 Also take a look here for more info. I have started with an assembly and printing guide, but not finished.

https://github.com/jakkra/ZSWatch/wiki/Case-and-3D-printing

Closed 2023-11-22.

Thread 137 (2023-11-22):

Add C02 output from BSEC2

jakkra, 2023-11-22:
Add here https://github.com/jakkra/ZSWatch/blob/main/app/drivers/sensor/bme68x_iaq/bosch_bme68x_iaq.c#L28
And read it out from BSEC2 library.
Add the necessary functions, should be same as the IAQ

Here are all features output by BSEC: https://github.com/boschsensortec/Bosch-BSEC2-Library/blob/master/src/inc/bsec_datatypes.h#L199

We could add more also.

Kampi, 2023-11-22:
On it :)
Should be a quick one

jakkra, 2023-11-22:
> On it :) Should be a quick one. Let´s add VOC too?

Yes, add anything relevent!

Closed 2023-11-22.

Thread 138 (2023-11-22):

Integrate Bosch BSX Lite library for 6-DOF sensor fusion

jakkra, 2023-11-22:
With this we can utilize Bosch library for fusion for Accel + Gyro to get Roll, Yaw  and Pitch angles.

This is what the library can output for us, can be used for some nice stuff!
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

https://www.bosch-sensortec.com/software-tools/software/sensor-fusion-software-bsx/

ldab, 2023-11-22:
On it 🫡

ldab, 2023-11-22:
How do we deal with licensing? Bosch ask for license agreement, perhaps we can't share openly? like people need to go there and click with their info?

jakkra, 2023-11-22:
Yes off by default (kconfig) and user need to download and put in a specific folder. For the BSEC2 it's solved a bit easier, even though I think it's the same license. But bosch have it on Github, which means we cannot automatically clone it, but using a west command see here https://github.com/jakkra/ZSWatch/blob/main/GETTING_STARTED.md#use-bosch-bsec2 and this is how nordic also does it, so assumed to be fine.

For now at least start with user need to download and put it in a specific folder, and then enable using kconfig

ldab, 2023-11-22:
> Yes off by default (kconfig) and user need to download and put in a specific folder. For the BSEC2 it's solved a bit easier, even though I think it's the same license. But bosch have it on Github, which means we cannot automatically clone it, but using a west command see here https://github.com/jakkra/ZSWatch/blob/main/GETTING_STARTED.md#use-bosch-bsec2 and this is how nordic also does it, so assumed to be fine.
>
> For now at least start with user need to download and put it in a specific folder, and then enable using kconfig

Cool, URL on readme is broken btw

jakkra, 2023-11-22:
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

Yep, already fixed :)

ldab, 2023-11-23:
BSXlite is not on GitHub. Do you have some features that needs it now? If not then I’ll work on the speedometer thing before as
1. this BSXlite may need more thoughts
2. and I also think it will clash with the pedometer
3. It does not give the heading speed anyway

jakkra, 2023-11-23:
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

Yeah no problem, nothing really that needs it for now.

jakkra, 2023-11-24:
Just found this: https://github.com/xioTechnologies/Fusion

It's a sensor fusion library that also takes magnetometer data (compared with that BSX Lite does).

That would give us absolute orientation, not just relative which BSX Lite does. Also this library is open source. Utilizing a full 9-Axis.

Looks quite undertandable and seems quite easy to use: https://github.com/xioTechnologies/Fusion/blob/main/Examples/Advanced/main.c

More info: https://x-io.co.uk/open-source-imu-and-ahrs-algorithms/

ldab, 2023-11-24:
Sounds promising, generally those sensor fusion needs raw sensor input quite frequently, do you think it would interfere with Pedometer?

jakkra, 2023-11-24:
> Sounds promising, generally those sensor fusion needs raw sensor input quite frequently, do you think it would interfere with Pedometer?

Why would is clash with pedometer, that's just a built in feature of the IMU. We fetch accel and gyro data simultaniously.

ldab, 2023-11-24:
> > Sounds promising, generally those sensor fusion needs raw sensor input quite frequently, do you think it would interfere with Pedometer?
>
> Why would is clash with pedometer, that's just a built in feature of the IMU. We fetch accel and gyro data simultaniously.

I don't know just guessing, that if we change the rate to say 100Hz, the pedometer function does not work or something like that

jakkra, 2023-11-24:
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

I think it's fine, I only saw requirements on minimal rate.

jakkra, 2024-02-28:
Closing as it's implemented using Fusion library.

Closed 2024-02-28.

Thread 140 (2023-11-23):

Jlink&IIC

DREAM669, 2023-11-23:
Hello, I have encountered two issues.
First question: How can I use JLink for debugging in VS code? What are the minimum pins that JLink needs to connect to?
The second question: Reading sensor information through IIC and calling the IIC read interface resulted in an incorrect return value. What is the approximate reason?

Kampi, 2023-11-23:
Hi @DREAM669
1) SWD needs
- SWDCLK
- SWDIO
- GND
- VTarget
- VCC on the target
You can debug by using the Debug function of the nRF Connect Plugin in VS Code (NOT the regular debug!)

2) Hard to say. Can you please share your code?

DREAM669, 2023-11-23:
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

DREAM669, 2023-11-23:
I clicked the debug button, then it showed no connected device found.

Kampi, 2023-11-23:
It looks like that no SWD target is found. Also your debugger looks strange because of the loading circle.
Please do the following:
- What kind of debugger do you use?
- Does the debugger gets loaded correctly when no target is attached? Restart VS Code to be sure
- Can you expand the debugger menu and see a target?

DREAM669, 2023-11-23:
> It looks like no SWD target is found. Also, your debugger looks strange because of the loading circle. Please do the following:
>
> * What kind of debugger do you use?
I am using J-Link as shown in the following image.
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

> * Does the debugger get loaded correctly when no target is attached? Restart VS Code to be sure
When I only connect J-Link to the computer without connecting it to the target board, it looks like this.
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

> * Can you expand the debugger menu and see a target?
When I connect four pins（SWDCLK，SWDIO，GND，VTarget） to J-Link, it looks like this.
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

> * Does the power supply of the target work?
> Yes, the target board is powered properly as the screen displays normally.

Kampi, 2023-11-23:
Okay that looks good so far. Can you program the MCU?

DREAM669, 2023-11-23:
when I click Flash Button, it shows "No connected device found with serial number 1050050002.
Either unlink the device from the build or connect that device."
I Jlink serial number is 5930563, do I need change this number?

jakkra, 2023-11-23:
> when I click Flash Button, it shows "No connected device found with serial number 1050050002. Either unlink the device from the build or connect that device." I Jlink serial number is 5930563, do I need change this number?

No, serial number is fixed, can't change.

Please use JFlash Lite and try do an erase in it. Also try flashing the built hex files directl using JFlashLite to see if it works. This will tell us if the debugger is working fine.

DREAM669, 2023-11-23:
I previously used the nRF5340DK board for downloading programs to the ZSwatch, and it worked fine. The serial number (SN) of the nRF5340DK is 1050050002.

DREAM669, 2023-11-23:
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

I am able to download programs successfully using the command-line tool, which indicates that my J-Link is functional. However, I am unable to download programs and debug within VS Code.

jakkra, 2023-11-23:
Ok, please try this:
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

Try both of those, see if one of them works
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

DREAM669, 2023-11-23:
@jakkra
PS E:\ZSWatch-main_newbard\app> nrfjprog -f NRF53 --recover
Recovering device. This operation might take 30s.
Erasing user code and UICR flash areas.
Writing image to disable ap protect.

jakkra, 2023-11-23:
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

That looks correct, is there a question?

DREAM669, 2023-11-23:
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

My problem is that I want to use Jlink to debug the program in VS code, but I get an error about "No connected device found with serial number 1050050002. Either unlink the device from the build or connect that device."

jakkra, 2023-11-23:
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

Did you try changing device provider as suggested?

DREAM669, 2023-11-23:
"No connected device found with serial number 1050050002. Either unlink the device from the build or connect that device."
Does this sentence mean that the debugging tool I set before is nRF5340DK, and I need to set the debugging tool to Jlink?

DREAM669, 2023-11-23:
My nRF5340DK cannot work, so I can only use Jlink.

Kampi, 2023-11-23:
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

1050050002 is your DK? So the used device in VS Code is your DK and not the JLink. Can you please unplug the DK and plug in only the JLink to make sure that there is no issue?

DREAM669, 2023-11-23:
Yes, 1050050002 is nRF4340DK.  I have unpluged the DK.
I guess what we have to do now is how to implement "unlink the device from the build"

jakkra, 2023-11-23:
> Yes, 1050050002 is nRF4340DK. I have unpluged the DK. I guess what we have to do now is how to implement "unlink the device from the build"

Just click here to link/unlink
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

DREAM669, 2023-11-24:
> > Yes, 1050050002 is nRF4340DK. I have unpluged the DK. I guess what we have to do now is how to implement "unlink the device from the build"
>
> Just click here to link/unlink 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

OK!
This problem is solved. Thank you so much！@jakkra@Kampi

Kampi, 2023-11-24:
Glad to hear that! Enjoy the hacking 😀

Closed 2023-11-24.

Thread 154 (2023-11-26):

Power management options for BMI270 driver

Kampi, 2023-11-26:
**ToDo**

- [ ] Proove that the sensor is working when power saving options are enabled
- [ ] Add driver code for power management

jakkra, 2023-11-26:
Low prio, as it's already consuming quite little and as long as rest of the system is >> BMI270, getting other parts of ZSWatch lower power is higher prio.

Kampi, 2023-11-26:
> Low prio, as it's already consuming quite little and as long as rest of the system is >> BMI270, getting other parts of ZSWatch lower power is higher prio.

Yes. Just to get it out of my head and as a collection list for features :)

Thread 165 (2023-11-28):

Device tree for rev 4

Kampi, 2023-11-28:
@jakkra I guess you already have something ready. So we can merge it 👍

jakkra, 2023-11-28:
@Kampi  I have it here already, it's just draft because I want to add building it in CI also.

Thread 169 (2023-11-30):

API for HTTP requests to Gadgetbridge

jakkra, 2023-11-30:
Abstract away the packet formatting and GB response parsing. Maybe add re-try mechanisms in case GadgetBridge is unreliable.

For example:

For the id see https://www.espruino.com/Gadgetbridge#messages-from-bangle-js-to-phone

```
rsp_cb(id, return_code, data); // return code OK, ERROR, Timoeut for example.
zsw_ble_http_get(patch, id, rsp_cb);
zsw_ble_http_abort(id); // Not sure if needed if an app is closed. Probably can just ignore the response
```

Closed 2024-05-23.

Thread 171 (2023-11-30):

NTS0104GU12 questions

DREAM669, 2023-11-30:
Currently, I am facing a problem. You did not connect a pull-up resistor to your NTS0104, but I found that the signal of IIC without a pull-up resistor is unstable. After connecting the pull-up resistor, the voltage level is relatively normal.Thank you for your reply!

Kampi, 2023-11-30:
Hi @DREAM669

which pull-up resistors do you mean? The IC has internal pull-up resistors attached to its inputs and outputs. Please check the [datasheet](https://www.nxp.com/docs/en/data-sheet/NTS0104.pdf) on page 15 topic 14.2.

DREAM669, 2023-12-01:
Okay, let me sort out the current issues.
1.After connecting the connector to the display screen, measure the IIC voltage. SDA and SCL changed from normal 3.3V to 2.7V and 2.5V
2. After downloading the program, the Touch function does not work. Is it due to voltage issues that the Touch chip cannot be driven?
Thank you very much for your reply!

jakkra, 2023-12-01:
> Okay, let me sort out the current issues. 1.After connecting the connector to the display screen, measure the IIC voltage. SDA and SCL changed from normal 3.3V to 2.7V and 2.5V 2. After downloading the program, the Touch function does not work. Is it due to voltage issues that the Touch chip cannot be driven? Thank you very much for your reply!

What PCB version did you order? Because we never had a BOM with this wrong logic shifter.

DREAM669, 2023-12-01:
Initial version PCB. The version using TXB0104 frequency conversion chip. But I soldered NTS0104 onto it again, replacing TXB0104. May I ask, after you connect the display screen, is the voltage of IIC still 3.3V? No decline? thank you.

jakkra, 2023-12-01:
> Initial version PCB. The version using TXB0104 frequency conversion chip. But I soldered NTS0104 onto it again, replacing TXB0104. May I ask, after you connect the display screen, is the voltage of IIC still 3.3V? No decline? thank you.

Please provide the commit you used

DREAM669, 2023-12-01:
I am using your first version. You didn't encounter this situation at the time, did you?

DREAM669, 2023-12-01:
Okay, I understand what to do now. I will try to compare. There is only one connector on the PCB. Thank you.

jakkra, 2023-12-01:
@DREAM669 I made many different version, so I'm not sure which one

> Okay, I understand what to do now. I will try to compare. There is only one connector on the PCB. Thank you.

Ok, then you are here. Just see if I changed something else on the PCB, if not you may have a soldering issue.
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

jakkra, 2023-12-04:
> May I ask if the voltage converted by NTS0104 after connecting the display screen is 3.3V? Or is there a decrease? Thank you for your reply!

Will measure when I have a chance. May be a day or two.

DREAM669, 2023-12-13:
Finally, it was discovered that the pin pin definition was incorrect. Thank you

Closed 2023-12-13.

Thread 173 (2023-11-30):

Prevent false triggering of system reset

Kampi, 2023-11-30:
**Ideas**

- Move system reset button to the right side
- Use two buttons for system reset

Kampi, 2023-12-21:
Closed with #199

Closed 2023-12-21.

Thread 190 (2023-12-09):

Disable vibration motor when battery is low

Kampi, 2023-12-09:
Battery voltage of ~3.6 V causes a reset when vibration motor is used.

Closed 2023-12-11.

Thread 198 (2023-12-11):

No hardware revision in Device Information Service when using revision 4

Kampi, 2023-12-11:

jakkra, 2023-12-11:
Fixed by https://github.com/jakkra/ZSWatch/pull/197

Closed 2023-12-11.

Thread 202 (2023-12-12):

error about compiling the latest code in vscode

DREAM669, 2023-12-12:
I downloaded the latest code, but there was an error when compiling in vscode. Can you help me find out the reason?

Executing task: nRF Connect: Build: app/build (active)

Building app
C:\Windows\system32\cmd.exe /d /s /c "west build --build-dir e:/git/ZSWatch/app/build e:/git/ZSWatch/app"

-- west build: generating a build system
Loading Zephyr default modules (Zephyr base (cached)).
-- Application: E:/git/ZSWatch/app
-- CMake version: 3.20.5
-- Cache files will be written to: C:/ncs/v2.4.0/zephyr/.cache
-- Zephyr version: 3.3.99 (C:/ncs/v2.4.0/zephyr)
-- Found west (found suitable version "1.0.0", minimum required is "0.7.1")
-- Board: zswatch_nrf5340_cpuapp, Revision: 3
-- Found host-tools: zephyr 0.16.0 (C:/ncs/toolchains/31f4403e35/opt/zephyr-sdk)
-- Found toolchain: zephyr 0.16.0 (C:/ncs/toolchains/31f4403e35/opt/zephyr-sdk)
-- Found BOARD.dts: E:/git/ZSWatch/app/boards/arm/zswatch_nrf5340/zswatch_nrf5340_cpuapp.dts
-- Found devicetree overlay: E:/git/ZSWatch/app/boards/arm/zswatch_nrf5340/zswatch_nrf5340_cpuapp_3.overlay
devicetree error: E:/git/ZSWatch/app/boards/arm/zswatch_nrf5340/zswatch_nrf5340_cpuapp_3.overlay:41 (column 24): parse error: expected number or parenthesized expression
-- In: E:/git/ZSWatch/app/build/zephyr, command: C:/ncs/toolchains/31f4403e35/opt/bin/python.exe;C:/ncs/v2.4.0/zephyr/scripts/dts/gen_defines.py;--dts;E:/git/ZSWatch/app/build/zephyr/zephyr.dts.pre;--dtc-flags;'-Wno-unique_unit_address_if_enabled';--bindings-dirs;C:/ncs/v2.4.0/nrf/dts/bindings;E:/git/ZSWatch/app/dts/bindings;C:/ncs/v2.4.0/zephyr/dts/bindings;--header-out;E:/git/ZSWatch/app/build/zephyr/include/generated/devicetree_generated.h.new;--dts-out;E:/git/ZSWatch/app/build/zephyr/zephyr.dts.new;--edt-pickle-out;E:/git/ZSWatch/app/build/zephyr/edt.pickle;--vendor-prefixes;C:/ncs/v2.4.0/nrf/dts/bindings/vendor-prefixes.txt;--vendor-prefixes;E:/git/ZSWatch/app/dts/bindings/vendor-prefixes.txt;--vendor-prefixes;C:/ncs/v2.4.0/zephyr/dts/bindings/vendor-prefixes.txt
CMake Error at C:/ncs/v2.4.0/zephyr/cmake/modules/dts.cmake:276 (message):
  gen_defines.py failed with return code: 1
Call Stack (most recent call first):
  C:/ncs/v2.4.0/zephyr/cmake/modules/zephyr_default.cmake:115 (include)
  C:/ncs/v2.4.0/zephyr/share/zephyr-package/cmake/ZephyrConfig.cmake:66 (include)
  C:/ncs/v2.4.0/zephyr/share/zephyr-package/cmake/ZephyrConfig.cmake:97 (include_boilerplate)
  CMakeLists.txt:30 (find_package)

-- Configuring incomplete, errors occurred!
FATAL ERROR: command exited with status 1: 'C:\ncs\toolchains\31f4403e35\opt\bin\cmake.EXE' '-DWEST_PYTHON=C:\ncs\toolchains\31f4403e35\opt\bin\python.exe' '-Be:\git\ZSWatch\app\build' -GNinja '-Se:\git\ZSWatch\app'

 *  The terminal process terminated with exit code: 1.
 *  Terminal will be reused by tasks, press any key to close it.

jakkra, 2023-12-12:
This is the compilation of the same scenario in CI:
https://github.com/jakkra/ZSWatch/actions/runs/7171094921/job/19525297160

1. Run west update
2. Do pristine build instead
3. You have C:/ncs/v2.4.0/zephyr stuff, this is wrong, we use west workspace (zephyr is inside ZSWatch folder) and we use ncs 2.5

It's doing:
`Run west build app --build-dir zswatch_nrf5340_cpuapp@3_debug -p -b zswatch_nrf5340_cpuapp@3 -- -DOVERLAY_CONFIG=boards/debug.conf"`

Can you try running that from the ZSWatch repo root directory

jakkra, 2023-12-12:
If you still have issues, please re-clone the repo and follow the instructions here: https://github.com/jakkra/ZSWatch/blob/main/GETTING_STARTED.md#cloning-source-code

DREAM669, 2023-12-13:
Thank you for your answer！The compilation problem is solved.
 I saw that the latest version adds an external Flash. What is this Flash used for?

jakkra, 2023-12-13:
> @jakkra Thank you for your answer！The compilation problem is solved. I saw that the latest version adds an external Flash. What is this Flash used for?

Mostly for storing image resoucres. The internal flash is 100% full, so external is needed. For example a full screen image is like 20% of internal flash. External flash also allows OTA.

Closed 2023-12-13.

Thread 215 (2024-01-16):

battery

DREAM669, 2024-01-16:
What is the total power consumption of this watch when the screen is on?
How long can this 450mah support? Can you share the link to purchase batteries?
I tried using a 3.7V 100mAh battery and found that after 10 minutes, the screen turned off.
Looking forward to your reply!

DREAM669, 2024-01-16:
@jakkra

jakkra, 2024-01-16:
1. Screen on 50% brightness - ~34mA
2. 0% brightness, display chip on, touch chip on - 300uA
3. Screen off, 3V3 off - 90uA

The 2nd one the watch enters 20s after interacting with it.
The watch will enter the 3rd state when left stationary for two minutes.

I'm getting about a week right now from the battery on the watch.

https://de.aliexpress.com/item/4000121983257.html?gatewayAdapt=glo2deu

ldab, 2024-01-16:
from 100% to 40% in 12 days,  did not use it all the time:

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

DREAM669, 2024-01-16:
The screen is always on now, how long does it normally go into an inactive state.

DREAM669, 2024-01-16:
ZSW_ACTIVITY_STATE_ACTIVE,
    ZSW_ACTIVITY_STATE_INACTIVE,
    ZSW_ACTIVITY_STATE_NOT_WORN_STATIONARY,
When and how to enter and exit these three modes?

Kampi, 2024-01-16:
I can confirm the battery life time of @ldab. I reached about 2 weeks with my watch (I used it one week and the other week it lays on my desk) and ~12 days when using it every day.

ZSW_ACTIVITY_STATE_ACTIVE -> When a motion is detected or a key is pressed (screen on)
ZSW_ACTIVITY_STATE_INACTIVE -> 20 seconds (?) without activity (key press, etc.) (screen off)
ZSW_ACTIVITY_STATE_NOT_WORN_STATIONARY -> 15 minutes inactive (screen and sensors off)

@jakkra please correct me when I´m wrong :)

jakkra, 2024-01-16:
> @jakkra please correct me when I´m wrong :)
>
ZSW_ACTIVITY_STATE_NOT_WORN_STATIONARY -> 15 minutes inactive (screen and sensors off)
It's 160 seconds, not 15 minutes.

> But my screen is always on, maybe it's always in ZSW_ Activity_ DATE_ Do I need to modify the code or configuration file to automatically switch modes in the Active mode?

1. Check Settings -> Display -> "Display always on" And make sure it's off (this is default)
2. Go to "System Info" application and check the "Time to inactive", it should count from 20s down to 0 and then screen should turn off.

DREAM669, 2024-01-19:
Thank you for your reply!

Closed 2024-01-19.

Thread 221 (2024-01-26):

FAN56xx backlight

jamolnng, 2024-01-26:
I think I've got a working solution for the backlight. I only get about 16 levels of brightness difference because in the 16-31 levels I don't see a noticeable change

in [app/src/drivers/zsw_display_control.c](https://github.com/jakkra/ZSWatch/blob/main/app/src/drivers/zsw_display_control.c) add something like:
```cpp
void blk_timer_expire(struct k_timer *timer_id)
{
  pwm_set_pulse_dt(&display_blk, 0);
}
K_TIMER_DEFINE(blk_timer, blk_timer_expire, 0);

void set_brightness(uint8_t bright)
{
  // returns to max brightness on chip reset
  // because the pwm line gets pulled low long
  // enough to reset the driver
  static uint8_t current = 32;
  bright = min(bright, uint8_t(32));
  uint8_t npulses = uint8_t(current - bright) % 32;
  current = bright;
  if (npulses > 0)
  {
    pwm_set_pulse_dt(&display_blk, display_blk.period / 2);
    // 250us is the PWM period
    // npulses - 1 since in my testing this always seems to run at least once + npulses
    k_timer_start(&blk_timer, K_USEC(250 * (npulses - 1)), K_FOREVER);
  }
}
```

then change this in [app/boards/arm/zswatch_nrf5340/zswatch_nrf5340_common.dts#L24](https://github.com/jakkra/ZSWatch/blob/main/app/boards/arm/zswatch_nrf5340/zswatch_nrf5340_common.dts#L24):
```patch
...
        display_blk: pwm_led_0 {
-            pwms = <&pwm0 0 PWM_MSEC(5) 0>;
+            pwms = <&pwm0 0 PWM_USEC(250) PWM_POLARITY_INVERTED>;
        };
...
```

jamolnng, 2024-01-26:
I'll add that I didn't make a pull request because I'm actually using the driver in a different project, I have just been following this one

jakkra, 2024-01-26:
Fantastic, this have been on my todo for a long time! I'll try it when I get a chance! Thanks alot 🙂

jamolnng, 2024-01-31:
quick update from more of my testing: if you say try to change the brightness using the touch screen (such as a lvgl slider) and bind the brightness changing to the `VALUE_CHANGED` lvgl event then quite often there are two events that will overlap causing issues and it does not behave as intended To get around this I currently bind the brightness slider to the `RELEASED` lvgl event. This may not be ideal though as then the brightness only changes when you release the slider instead of changing as the slider moves. There's definitely a way to fix it, I just haven't gotten that far yet

jakkra, 2024-01-31:
Hi, I did try it but felt there was still something I did not understand. The driver don't need constant pwm if I understand the code correctly right? I saw this same issue you describe and instead tested it by changing brightness using buttons instead.
I'll give it another try tonight, thanks!

jamolnng, 2024-01-31:
Correct, the driver only needs 1-32 pulses to set the brightness. The problem is they're so quick (max of 300 microseconds according to the datasheet) that manually toggling the pins with delays is most likely not consistent enough, which is why I used PWM and a timer to stop the PWM after the number of pulses needed.

The code I wrote above calculates the number of pulses to go from the current brightness to the requested brightness. The problem with this is that if they ever become out of sync then the code will not work as intended. I am looking for a fix to this

jakkra, 2024-01-31:
Great, I can actually test this code with a logic analyzer.

jakkra, 2024-01-31:
Been playing around bit, and as you say as long as it doesn't get "out of sync" it works great. I need more logic to make sure not loosing state of it and to handle power on etc. that it re-starts at max brigthness.

jamolnng, 2024-01-31:
I actually have a prototype now using the zephyr counter driver, this may give more accurate timings and allow the backlight value to be changed quicker so you don't have to keep track of the current state. currently setting up my logic analyzer to iron out the details. will update

jamolnng, 2024-01-31:
https://github.com/jakkra/ZSWatch/assets/1132336/869a2b54-238c-44e6-ae1f-89ff1d81b0c0

This should work with `LV_EVENT_VALUE_CHANGED`

prj.conf

```
CONFIG_COUNTER=y
CONFIG_NRFX_TIMER1=y
```

```c
#include <zephyr/drivers/counter.h>

static const struct pwm_dt_spec display_bkl = PWM_DT_SPEC_GET_OR(DT_ALIAS(display_bkl), {});
static const struct device *counter_dev = DEVICE_DT_GET_OR_NULL(DT_NODELABEL(timer1));

static void brightness_alarm_start_cb(const device *counter_dev, uint8_t chan_id, uint32_t ticks, void *user_data);
static void brightness_alarm_run_cb(const device *counter_dev, uint8_t chan_id, uint32_t ticks, void *user_data);
static void brightness_alarm_stop_cb(const device *counter_dev, uint8_t chan_id, uint32_t ticks, void *user_data);

static struct counter_alarm_cfg _brightness_alarm_start, _brightness_alarm_run, _brightness_alarm_stop;

static void do_set_brightness(k_work *work);
K_WORK_DELAYABLE_DEFINE(_brightness_work, do_set_brightness);
static struct k_work_sync _brightness_cancel_sync;

uint8_t _brightness = 32;
uint8_t _next_brightness = 32;

void some_init_function()
{
  _brightness_alarm_start.flags = 0;
  _brightness_alarm_start.callback = &brightness_alarm_start_cb;

  _brightness_alarm_run.flags = 0;
  _brightness_alarm_run.callback = &brightness_alarm_run_cb;

  _brightness_alarm_stop.flags = 0;
  _brightness_alarm_stop.callback = &brightness_alarm_stop_cb;

  _brightness_alarm_start.ticks = counter_us_to_ticks(_counter, 0);
  _brightness_alarm_run.ticks = counter_us_to_ticks(_counter, 750); // documentation says 1ms but I am able to get it to work with 750us
}

void set_brightness(uint8_t brightness)
{
  // this makes sure that we don't set the brightness too quickly in succession
  _next_brightness = brightness;
  k_work_cancel_delayable_sync(&_brightness_work, &_brightness_cancel_sync);
  k_work_schedule(&_brightness_work, K_MSEC(20));
}

void do_set_brightness(k_work *work)
{
  uint8_t brightness = std::min(_next_brightness, uint8_t(32));
  auto npulses = 32 - brightness;
  _brightness = brightness;

  _brightness_alarm_stop.ticks =
    _brightness_alarm_run.ticks +
    counter_us_to_ticks(_counter, _backlight.period * (npulses + 1) / NSEC_PER_USEC);
  counter_set_channel_alarm(_counter, 0, &_brightness_alarm_start);
  counter_set_channel_alarm(_counter, 1, &_brightness_alarm_run);
  counter_set_channel_alarm(_counter, 2, &_brightness_alarm_stop);
  counter_start(_counter);
}
```

jamolnng, 2024-02-01:
nice! there may be some power usage optimizations by disabling the PWM when not setting the brightness but that's a future problem

Kampi, 2024-02-02:
Sweet! Really good work 👍

Closed 2024-02-02.

Thread 222 (2024-01-30):

Unable to recognize MCU and download program

DREAM669, 2024-01-30:
Hi，
@jakkra @Kampi
Our board voltage is incorrect, and we suspect that the MCU is broken. Then, we replaced the MCU in the NORA-B10 module with a new one and used it in VS code to download the program. We found that the MCU could not be recognized and the code could not be burned. We executed nrfjprog - f NRF53-- recover and received the following error message.

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

DREAM669, 2024-01-30:
We also encountered another issue, when the battery voltage is below 3.8V, pressing the button will reboot the system. Please help take a look.

Kampi, 2024-01-30:
> We also encountered another issue, when the battery voltage is below 3.8V, pressing the button will reboot the system. Please help take a look.

The watch is working until ~3.6 V. I guess you hit the lower voltage limit and this leads to a PoR. Please charge the battery and try it again.

Kampi, 2024-01-30:
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

Are you sure that the MCU is soldered correctly?

jakkra, 2024-01-30:
> We also encountered another issue, when the battery voltage is below 3.8V, pressing the button will reboot the system. Please help take a look.

This is expected if you are running old FW, it's the vibration motor turning on and causing the battery voltage to drop and battery supervisor will cut power.

I fixed this like a month ago to not vibrate when low battery voltage.

DREAM669, 2024-01-30:
There is another issue. I saw in your schematic that the program was downloaded with a Vbus pin, but I need to connect the+1V8 pin to the VCC pin of Jlink to download it instead of VBUS. @jakkra @Kampi

Kampi, 2024-01-30:
> There is another issue. I saw in your schematic that the program was downloaded with a Vbus pin, but I need to connect the+1V8 pin to the VCC pin of Jlink to download it instead of VBUS. @jakkra @Kampi

What do you mean? Sure you have to connect the IO voltage of the programming interface to the J-Link for it´s internal level converter. The dock connector is using a 5 V voltage as system voltage, but SWD is running on 3.3 V. So you have to connect 3.3 V to VTarget at your J-Link.

jakkra, 2024-01-30:
> > There is another issue. I saw in your schematic that the program was downloaded with a Vbus pin, but I need to connect the+1V8 pin to the VCC pin of Jlink to download it instead of VBUS. @jakkra @Kampi
>
> What do you mean? Sure you have to connect the IO voltage of the programming interface to the J-Link for it´s internal level converter. The dock connector is using a 5 V voltage as system voltage, but SWD is running on 3.3 V. So you have to connect 3.3 V to VTarget at your J-Link.

Hmm, I think this may be the issue. Vref should be 1v8 here not 3v3 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

DREAM669, 2024-01-30:
> > Hi， @jakkra @Kampi Our board voltage is incorrect, and we suspect that the MCU is broken. Then, we replaced the MCU in the NORA-B10 module with a new one and used it in VS code to download the program. We found that the MCU could not be recognized and the code could not be burned. We executed nrfjprog - f NRF53-- recover and received the following error message.
>
> Are you sure that the MCU is soldered correctly?

I am not sure. Is there a quick and simple way to determine whether an MCU is soldered correctly?

jakkra, 2024-01-30:
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

You can talk with it using the debugger :)

Kampi, 2024-01-30:
@DREAM669 you use the dock with an external J-Link? The dock has two use cases:

- Using internal J-Link: `Debug connector` is used for programming the STM32 -> 3.3 V is correct
- Using external J-Link: `Debug connector` is connected with `Interface`. Then you need 1.8 V. Here we have an issue for sure.

I will handle this issue in the next dock release. I´m sorry for this issue. We haven´t thought about it 👎

DREAM669, 2024-01-30:
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

Yes，the wrong voltage leves get fixed.

DREAM669, 2024-01-30:
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

 I did not use a dock. I just use a external J-Link.

Kampi, 2024-01-30:
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

Ah! Okay so you don´t run into the issue. Glad to hear it 👍

DREAM669, 2024-01-31:
@jakkra @Kampi
Can the MCU in the NORA-B10 module be directly replaced with the new nRF5340? We welded and replaced the MCU in the NORA-B10 module on two boards, but we couldn't detect the MCU using Jlink. Executing nrfjprog - f NRF53-- recover -- log would result in an error.

Kampi, 2024-01-31:
Hi @DREAM669

yes you can attach any nRF5340 dev kit or similar to the pins of the footprint of the NORA module.

jakkra, 2024-01-31:
> @jakkra @Kampi Can the MCU in the NORA-B10 module be directly replaced with the new nRF5340? We welded and replaced the MCU in the NORA-B10 module on two boards, but we couldn't detect the MCU using Jlink. Executing nrfjprog - f NRF53-- recover -- log would result in an error.

But it would be safer to just replace the whole module, or easier at least.

Closed 2024-02-27.

Thread 223 (2024-01-30):

Wrong link in wiki/Apps ('the sample application')

Kampi, 2024-01-30:
The link `https://github.com/jakkra/ZSWatch/wiki/app/src/applications/template/` is wrong

Closed 2024-01-30.

Thread 245 (2024-04-12):

Rethink reset button

Kampi, 2024-04-12:
I have the issue that I trigger system reset all the time. Imo the SW is quite stable in release so reset isn't needed there.

- Shall we disable reset button in release build?
- If not how can we handle it better?

Closed 2024-04-15.

Thread 254 (2024-04-16):

Add support for watchfaces from esp32-lvgl-watchface

Kampi, 2024-04-16:
**Link**
https://github.com/fbiego/esp32-lvgl-watchface

**Modified repo**
https://github.com/Kampi/esp32-lvgl-watchface/tree/ZSWatch_Port

**ToDo**
- [x] Modify Kotlin script to support the newest compiler (replace `XYcase` with `toXYCase` and add label for `continue` in `when` statement)
- [x] Clean up the repository
- [x] Modify the template generator to avoid the usage of additional glue code
- [x] Update README
- [x] Rename color swap macro to match with Zephyr naming scheme
- [x] Add CMakeList generation to the template generator
- [ ] Check the generated code for batteries and check if we can use the `percent` parameter
- [ ] Add Kotlin code for number of notifications
- [ ] Add Kotlin code for environmental sensors
- [x] Move all images to a separate directory (one directory for all watchfaces) to make them work with the external flash memory implementation. Also copy this directory into the right location
- [ ] LLEXT interface for watchfaces (requires USB and Drag & Drop)

**Bugs**
- `face_1083_dial_img_33_203425_group` missing when parsing `dials/X5Pro/1083` (@fbiego can you help here?)

**Notes**
- All in one command:
```
kotlinc bin2lvgl.kt -include-runtime -d bin2lvgl.jar && java -jar bin2lvgl.jar 24_2_dial.bin && mkdir -p ../ZSWatch/app/src/ui/watchfaces/24_2_dial && cp 24_2_dial/* ../ZSWatch/app/src/ui/watchfaces/24_2_dial/
```

fbiego, 2024-04-16:
It appears I may have misinterpreted your concern on https://github.com/fbiego/esp32-lvgl-watchface/issues/1.

I noticed that you mentioned Color Swap and BGR support in your to-do list. Could you provide further clarification on the issue? From what I understand, BGR doesn't seem related to color swapping.

Kampi, 2024-04-16:
Hi @fbiego,

thanks for your support! I prepare a branch of the ZSWatch firmware and the watchface repository to test it more properly :)

jakkra, 2024-04-16:
@fbiego I think we figured it out, @Kampi tested the code in our Linux environment and there we had wrong display color settings. Will try tomorrow with updated config on our side.

@fbiego BTW really like your project and app!

Kampi, 2024-04-16:
So we don´t need BGR and color swap must be enabled because we also use it (the old POSIX configuration causes some issues). This means your implementation should work out of the box after I change the macro name for the swap in the template code.

fbiego, 2024-04-17:
awesome, it would be great to see how it turns out

thanks @jakkra
btw Chronos app also uses Nordic UART service but the data is structured differently.
https://github.com/fbiego/dt78/blob/master/DT78_COMMANDS.md

I would check how I can configure support, I have implemented a library for ESP32.

This is how incoming data is parsed
https://github.com/fbiego/chronos-esp32/blob/e521f703cf9ffe12e6d58ec6b929d4d18727f093/ChronosESP32.cpp#L604

https://github.com/fbiego/chronos-esp32/blob/e521f703cf9ffe12e6d58ec6b929d4d18727f093/ChronosESP32.cpp#L662

jakkra, 2024-04-17:
@fbiego thanks for the reference, I think it should be fairly easy to add support from Chronos app as we have separated the layer between feeding stuff like weather, time, notifications etc. into the watch from different transport methods already. (We support either Gadgetbride, or iOS (native iOS services for time, notifications etc.). So it would be a matter of adding another.

This is what we use right now: https://www.espruino.com/Gadgetbridge#how-it-works-internally

I think since Chronos also use Nordic NUS, we can just add some check here which protocol the payload matches, and then feed it into a new `ble_chronos_input(...)` instead when it is of this binary type instead of json. https://github.com/jakkra/ZSWatch/blob/050facf1fac6fde1857f2420c69afeebebd02ec4/app/src/ble/ble_comm.c#L352

Kampi, 2024-04-17:
This Chronos app looks really nice. Jakob and I thought about a app which provides better support for the watch :)
Would be cool to integrate the ZSWatch into this app and vice versa.

Kampi, 2024-04-17:
The color issue isn´t fixed. I´ve updated the fork with the latest Kotlin script, run this script with

```
d "/home/daniel/esp32-lvgl-watchface/" && kotlinc bin2lvgl.kt -include-runtime -d bin2lvgl.jar && java -jar bin2lvgl.jar 748_2_dial.bin && cp 748_2_dial/* /home/daniel/ZSWatch/app/src/ui/watchfaces/748_2_dial/
```

add the watchface to the project and build everything.

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

Kampi, 2024-04-17:
First version with ZSWatch capable code is available. The Kotlin template generator was modified to output the code in the format needed for ZSWatch watch face API.

Example:

```

// File generated by bin2lvgl
// developed by fbiego.
// https://github.com/fbiego
// modified by Daniel Kampert.
// https://github.com/kampi
// Watchface: 748_2_dial

#include <lvgl.h>

#include <zephyr/logging/log.h>

#include "ui/zsw_ui.h"
#include "applications/watchface/watchface_app.h"

LOG_MODULE_REGISTER(watchface_748_2_dial, LOG_LEVEL_WRN);

static lv_obj_t *face_748_2_dial;
static lv_obj_t *face_748_2_dial = NULL;
static watchface_app_evt_listener ui_748_2_dial_evt_cb;

static lv_obj_t *face_748_2_dial_0_424;
static lv_obj_t *face_748_2_dial_1_65535;
static lv_obj_t *face_748_2_dial_3_101560;
static lv_obj_t *face_748_2_dial_5_72552;
static lv_obj_t *face_748_2_dial_6_58522;
static lv_obj_t *face_748_2_dial_7_58522;
static lv_obj_t *face_748_2_dial_8_58522;
static lv_obj_t *face_748_2_dial_9_58522;
static lv_obj_t *face_748_2_dial_10_58522;
static lv_obj_t *face_748_2_dial_11_58522;
static lv_obj_t *face_748_2_dial_12_58522;
static lv_obj_t *face_748_2_dial_13_58522;
static lv_obj_t *face_748_2_dial_14_80686;
static lv_obj_t *face_748_2_dial_15_82792;
static lv_obj_t *face_748_2_dial_16_82792;
static lv_obj_t *face_748_2_dial_17_82792;
static lv_obj_t *face_748_2_dial_18_82792;
static lv_obj_t *face_748_2_dial_19_80958;
static lv_obj_t *face_748_2_dial_20_80958;

ZSW_LV_IMG_DECLARE(face_748_2_dial_dial_img_0_424_0);
ZSW_LV_IMG_DECLARE(face_748_2_dial_dial_img_1_65535_0);
ZSW_LV_IMG_DECLARE(face_748_2_dial_dial_img_2_94526_0);
ZSW_LV_IMG_DECLARE(face_748_2_dial_dial_img_2_94526_1);
ZSW_LV_IMG_DECLARE(face_748_2_dial_dial_img_2_94526_2);
ZSW_LV_IMG_DECLARE(face_748_2_dial_dial_img_2_94526_3);
ZSW_LV_IMG_DECLARE(face_748_2_dial_dial_img_2_94526_4);
ZSW_LV_IMG_DECLARE(face_748_2_dial_dial_img_2_94526_5);
ZSW_LV_IMG_DECLARE(face_748_2_dial_dial_img_2_94526_6);
ZSW_LV_IMG_DECLARE(face_748_2_dial_dial_img_3_101560_0);
ZSW_LV_IMG_DECLARE(face_748_2_dial_dial_img_3_101560_1);
ZSW_LV_IMG_DECLARE(face_748_2_dial_dial_img_3_101560_2);
ZSW_LV_IMG_DECLARE(face_748_2_dial_dial_img_3_101560_3);
ZSW_LV_IMG_DECLARE(face_748_2_dial_dial_img_3_101560_4);
ZSW_LV_IMG_DECLARE(face_748_2_dial_dial_img_3_101560_5);
ZSW_LV_IMG_DECLARE(face_748_2_dial_dial_img_3_101560_6);
ZSW_LV_IMG_DECLARE(face_748_2_dial_dial_img_4_60206_0);
ZSW_LV_IMG_DECLARE(face_748_2_dial_dial_img_4_60206_1);
ZSW_LV_IMG_DECLARE(face_748_2_dial_dial_img_4_60206_2);
ZSW_LV_IMG_DECLARE(face_748_2_dial_dial_img_4_60206_3);
ZSW_LV_IMG_DECLARE(face_748_2_dial_dial_img_4_60206_4);
ZSW_LV_IMG_DECLARE(face_748_2_dial_dial_img_4_60206_5);
ZSW_LV_IMG_DECLARE(face_748_2_dial_dial_img_4_60206_6);
ZSW_LV_IMG_DECLARE(face_748_2_dial_dial_img_4_60206_7);
ZSW_LV_IMG_DECLARE(face_748_2_dial_dial_img_4_60206_8);
ZSW_LV_IMG_DECLARE(face_748_2_dial_dial_img_4_60206_9);
ZSW_LV_IMG_DECLARE(face_748_2_dial_dial_img_4_60206_10);
ZSW_LV_IMG_DECLARE(face_748_2_dial_dial_img_4_60206_11);
ZSW_LV_IMG_DECLARE(face_748_2_dial_dial_img_5_72552_0);
ZSW_LV_IMG_DECLARE(face_748_2_dial_dial_img_5_72552_1);
ZSW_LV_IMG_DECLARE(face_748_2_dial_dial_img_5_72552_2);
ZSW_LV_IMG_DECLARE(face_748_2_dial_dial_img_5_72552_3);
ZSW_LV_IMG_DECLARE(face_748_2_dial_dial_img_5_72552_4);
ZSW_LV_IMG_DECLARE(face_748_2_dial_dial_img_5_72552_5);
ZSW_LV_IMG_DECLARE(face_748_2_dial_dial_img_5_72552_6);
ZSW_LV_IMG_DECLARE(face_748_2_dial_dial_img_5_72552_7);
ZSW_LV_IMG_DECLARE(face_748_2_dial_dial_img_5_72552_8);
ZSW_LV_IMG_DECLARE(face_748_2_dial_dial_img_5_72552_9);
ZSW_LV_IMG_DECLARE(face_748_2_dial_dial_img_5_72552_10);
ZSW_LV_IMG_DECLARE(face_748_2_dial_dial_img_5_72552_11);
ZSW_LV_IMG_DECLARE(face_748_2_dial_dial_img_6_58522_0);
ZSW_LV_IMG_DECLARE(face_748_2_dial_dial_img_6_58522_1);
ZSW_LV_IMG_DECLARE(face_748_2_dial_dial_img_6_58522_2);
ZSW_LV_IMG_DECLARE(face_748_2_dial_dial_img_6_58522_3);
ZSW_LV_IMG_DECLARE(face_748_2_dial_dial_img_6_58522_4);
ZSW_LV_IMG_DECLARE(face_748_2_dial_dial_img_6_58522_5);
ZSW_LV_IMG_DECLARE(face_748_2_dial_dial_img_6_58522_6);
ZSW_LV_IMG_DECLARE(face_748_2_dial_dial_img_6_58522_7);
ZSW_LV_IMG_DECLARE(face_748_2_dial_dial_img_6_58522_8);
ZSW_LV_IMG_DECLARE(face_748_2_dial_dial_img_6_58522_9);
ZSW_LV_IMG_DECLARE(face_748_2_dial_dial_img_14_80686_0);
ZSW_LV_IMG_DECLARE(face_748_2_dial_dial_img_15_82792_0);
ZSW_LV_IMG_DECLARE(face_748_2_dial_dial_img_15_82792_1);
ZSW_LV_IMG_DECLARE(face_748_2_dial_dial_img_15_82792_2);
ZSW_LV_IMG_DECLARE(face_748_2_dial_dial_img_15_82792_3);
ZSW_LV_IMG_DECLARE(face_748_2_dial_dial_img_15_82792_4);
ZSW_LV_IMG_DECLARE(face_748_2_dial_dial_img_15_82792_5);
ZSW_LV_IMG_DECLARE(face_748_2_dial_dial_img_15_82792_6);
ZSW_LV_IMG_DECLARE(face_748_2_dial_dial_img_15_82792_7);
ZSW_LV_IMG_DECLARE(face_748_2_dial_dial_img_15_82792_8);
ZSW_LV_IMG_DECLARE(face_748_2_dial_dial_img_15_82792_9);
ZSW_LV_IMG_DECLARE(face_748_2_dial_dial_img_19_80958_0);
ZSW_LV_IMG_DECLARE(face_748_2_dial_dial_img_19_80958_1);
ZSW_LV_IMG_DECLARE(face_748_2_dial_dial_img_19_80958_2);
ZSW_LV_IMG_DECLARE(face_748_2_dial_dial_img_19_80958_3);
ZSW_LV_IMG_DECLARE(face_748_2_dial_dial_img_19_80958_4);
ZSW_LV_IMG_DECLARE(face_748_2_dial_dial_img_19_80958_5);
ZSW_LV_IMG_DECLARE(face_748_2_dial_dial_img_19_80958_6);
ZSW_LV_IMG_DECLARE(face_748_2_dial_dial_img_19_80958_7);
ZSW_LV_IMG_DECLARE(face_748_2_dial_dial_img_19_80958_8);
ZSW_LV_IMG_DECLARE(face_748_2_dial_dial_img_19_80958_9);
ZSW_LV_IMG_DECLARE(face_748_2_dial_dial_img_preview_0);

#if CONFIG_LV_COLOR_DEPTH_16 != 1
#error "CONFIG_LV_COLOR_DEPTH_16 should be 16 bit for watchfaces"
#endif
#if CONFIG_LV_COLOR_16_SWAP != 1
#error "CONFIG_LV_COLOR_16_SWAP should be 1 for watchfaces"
#endif

const lv_img_dsc_t *face_748_2_dial_dial_img_2_94526_group[] = {
	&face_748_2_dial_dial_img_2_94526_0,
	&face_748_2_dial_dial_img_2_94526_1,
	&face_748_2_dial_dial_img_2_94526_2,
	&face_748_2_dial_dial_img_2_94526_3,
	&face_748_2_dial_dial_img_2_94526_4,
	&face_748_2_dial_dial_img_2_94526_5,
	&face_748_2_dial_dial_img_2_94526_6,
};
const lv_img_dsc_t *face_748_2_dial_dial_img_3_101560_group[] = {
	&face_748_2_dial_dial_img_3_101560_0,
	&face_748_2_dial_dial_img_3_101560_1,
	&face_748_2_dial_dial_img_3_101560_2,
	&face_748_2_dial_dial_img_3_101560_3,
	&face_748_2_dial_dial_img_3_101560_4,
	&face_748_2_dial_dial_img_3_101560_5,
	&face_748_2_dial_dial_img_3_101560_6,
};
const lv_img_dsc_t *face_748_2_dial_dial_img_4_60206_group[] = {
	&face_748_2_dial_dial_img_4_60206_0,
	&face_748_2_dial_dial_img_4_60206_1,
	&face_748_2_dial_dial_img_4_60206_2,
	&face_748_2_dial_dial_img_4_60206_3,
	&face_748_2_dial_dial_img_4_60206_4,
	&face_748_2_dial_dial_img_4_60206_5,
	&face_748_2_dial_dial_img_4_60206_6,
	&face_748_2_dial_dial_img_4_60206_7,
	&face_748_2_dial_dial_img_4_60206_8,
	&face_748_2_dial_dial_img_4_60206_9,
	&face_748_2_dial_dial_img_4_60206_10,
	&face_748_2_dial_dial_img_4_60206_11,
};
const lv_img_dsc_t *face_748_2_dial_dial_img_5_72552_group[] = {
	&face_748_2_dial_dial_img_5_72552_0,
	&face_748_2_dial_dial_img_5_72552_1,
	&face_748_2_dial_dial_img_5_72552_2,
	&face_748_2_dial_dial_img_5_72552_3,
	&face_748_2_dial_dial_img_5_72552_4,
	&face_748_2_dial_dial_img_5_72552_5,
	&face_748_2_dial_dial_img_5_72552_6,
	&face_748_2_dial_dial_img_5_72552_7,
	&face_748_2_dial_dial_img_5_72552_8,
	&face_748_2_dial_dial_img_5_72552_9,
	&face_748_2_dial_dial_img_5_72552_10,
	&face_748_2_dial_dial_img_5_72552_11,
};
const lv_img_dsc_t *face_748_2_dial_dial_img_6_58522_group[] = {
	&face_748_2_dial_dial_img_6_58522_0,
	&face_748_2_dial_dial_img_6_58522_1,
	&face_748_2_dial_dial_img_6_58522_2,
	&face_748_2_dial_dial_img_6_58522_3,
	&face_748_2_dial_dial_img_6_58522_4,
	&face_748_2_dial_dial_img_6_58522_5,
	&face_748_2_dial_dial_img_6_58522_6,
	&face_748_2_dial_dial_img_6_58522_7,
	&face_748_2_dial_dial_img_6_58522_8,
	&face_748_2_dial_dial_img_6_58522_9,
};
const lv_img_dsc_t *face_748_2_dial_dial_img_15_82792_group[] = {
	&face_748_2_dial_dial_img_15_82792_0,
	&face_748_2_dial_dial_img_15_82792_1,
	&face_748_2_dial_dial_img_15_82792_2,
	&face_748_2_dial_dial_img_15_82792_3,
	&face_748_2_dial_dial_img_15_82792_4,
	&face_748_2_dial_dial_img_15_82792_5,
	&face_748_2_dial_dial_img_15_82792_6,
	&face_748_2_dial_dial_img_15_82792_7,
	&face_748_2_dial_dial_img_15_82792_8,
	&face_748_2_dial_dial_img_15_82792_9,
};
const lv_img_dsc_t *face_748_2_dial_dial_img_19_80958_group[] = {
	&face_748_2_dial_dial_img_19_80958_0,
	&face_748_2_dial_dial_img_19_80958_1,
	&face_748_2_dial_dial_img_19_80958_2,
	&face_748_2_dial_dial_img_19_80958_3,
	&face_748_2_dial_dial_img_19_80958_4,
	&face_748_2_dial_dial_img_19_80958_5,
	&face_748_2_dial_dial_img_19_80958_6,
	&face_748_2_dial_dial_img_19_80958_7,
	&face_748_2_dial_dial_img_19_80958_8,
	&face_748_2_dial_dial_img_19_80958_9,
};

static void watchface_748_2_dial_remove(void)
{
    if (!face_748_2_dial) {
        return;
    }
    lv_obj_del(face_748_2_dial);
    face_748_2_dial = NULL;
}

static void watchface_748_2_dial_invalidate_cached(void)
{
}

static void watchface_748_2_dial_set_datetime(int day_of_week, int date, int day, int month, int year, int weekday, int32_t hour,
                                   int32_t minute, int32_t second, uint32_t usec)
{
    if (!face_748_2_dial) {
        return;
    }

	lv_img_set_src(face_748_2_dial_3_101560, face_748_2_dial_dial_img_3_101560_group[((weekday + 6) / 1) % 7]);
	lv_img_set_src(face_748_2_dial_5_72552, face_748_2_dial_dial_img_5_72552_group[(month / 1) % 12]);
	lv_img_set_src(face_748_2_dial_15_82792, face_748_2_dial_dial_img_15_82792_group[(hour / 1) % 10]);
	lv_img_set_src(face_748_2_dial_16_82792, face_748_2_dial_dial_img_15_82792_group[(hour / 10) % 10]);
	lv_img_set_src(face_748_2_dial_17_82792, face_748_2_dial_dial_img_15_82792_group[(minute / 1) % 10]);
	lv_img_set_src(face_748_2_dial_18_82792, face_748_2_dial_dial_img_15_82792_group[(minute / 10) % 10]);
	lv_img_set_src(face_748_2_dial_19_80958, face_748_2_dial_dial_img_19_80958_group[(day / 1) % 10]);
	lv_img_set_src(face_748_2_dial_20_80958, face_748_2_dial_dial_img_19_80958_group[(day / 10) % 10]);

}

static void watchface_748_2_dial_set_step(int32_t steps, int32_t distance, int32_t kcal)
{
    if (!face_748_2_dial) {
        return;
    }

	lv_img_set_src(face_748_2_dial_9_58522, face_748_2_dial_dial_img_6_58522_group[(steps / 1) % 10]);
	lv_img_set_src(face_748_2_dial_10_58522, face_748_2_dial_dial_img_6_58522_group[(steps / 10) % 10]);
	lv_img_set_src(face_748_2_dial_11_58522, face_748_2_dial_dial_img_6_58522_group[(steps / 100) % 10]);
	lv_img_set_src(face_748_2_dial_12_58522, face_748_2_dial_dial_img_6_58522_group[(steps / 1000) % 10]);
	lv_img_set_src(face_748_2_dial_13_58522, face_748_2_dial_dial_img_6_58522_group[(steps / 10000) % 10]);

}

static void watchface_748_2_dial_set_hrm(int32_t bpm, int32_t oxygen)
{
    if (!face_748_2_dial) {
        return;
    }

	lv_img_set_src(face_748_2_dial_6_58522, face_748_2_dial_dial_img_6_58522_group[(bpm / 1) % 10]);
	lv_img_set_src(face_748_2_dial_7_58522, face_748_2_dial_dial_img_6_58522_group[(bpm / 10) % 10]);
	lv_img_set_src(face_748_2_dial_8_58522, face_748_2_dial_dial_img_6_58522_group[(bpm / 100) % 10]);

}

static void watchface_748_2_dial_set_weather(int8_t temperature, int weather_code)
{
    if (!face_748_2_dial) {
        return;
    }

}

static void watchface_748_2_dial_set_ble_connected(bool connected)
{
    if (!face_748_2_dial) {
        return;
    }

}

static void watchface_748_2_dial_set_battery_percent(int32_t percent, int32_t battery)
{
    if (!face_748_2_dial) {
        return;
    }

}

static void watchface_748_2_dial_set_num_notifcations(int32_t number)
{
    if (!face_748_2_dial) {
        return;
    }

}

static void watchface_748_2_dial_set_watch_env_sensors(int temperature, int humidity, int pressure, float iaq, float co2)
{
    if (!face_748_2_dial) {
        return;
    }

}

void watchface_748_2_dial_show(watchface_app_evt_listener evt_cb, zsw_settings_watchface_t *settings) {
    ui_748_2_dial_evt_cb = evt_cb;

    lv_obj_clear_flag(lv_scr_act(), LV_OBJ_FLAG_SCROLLABLE);
    face_748_2_dial = lv_obj_create(lv_scr_act());
    watchface_748_2_dial_invalidate_cached();

    lv_obj_clear_flag(face_748_2_dial, LV_OBJ_FLAG_SCROLLABLE);
    lv_obj_set_scrollbar_mode(face_748_2_dial, LV_SCROLLBAR_MODE_OFF);
    lv_obj_set_style_bg_opa(face_748_2_dial, LV_OPA_TRANSP, LV_PART_MAIN);

    lv_obj_set_style_border_width(face_748_2_dial, 0, LV_PART_MAIN);
    lv_obj_set_size(face_748_2_dial, 240, 240);
    lv_obj_clear_flag(face_748_2_dial, LV_OBJ_FLAG_SCROLLABLE);
    lv_obj_set_style_bg_color(face_748_2_dial, lv_color_hex(0x000000), LV_PART_MAIN | LV_STATE_DEFAULT);
    lv_obj_set_style_bg_opa(face_748_2_dial, 255, LV_PART_MAIN | LV_STATE_DEFAULT);
    lv_obj_set_style_border_width(face_748_2_dial, 0, LV_PART_MAIN | LV_STATE_DEFAULT);
    lv_obj_set_style_pad_left(face_748_2_dial, 0, LV_PART_MAIN | LV_STATE_DEFAULT);
    lv_obj_set_style_pad_right(face_748_2_dial, 0, LV_PART_MAIN | LV_STATE_DEFAULT);
    lv_obj_set_style_pad_top(face_748_2_dial, 0, LV_PART_MAIN | LV_STATE_DEFAULT);
    lv_obj_set_style_pad_bottom(face_748_2_dial, 0, LV_PART_MAIN | LV_STATE_DEFAULT);

    face_748_2_dial_0_424 = lv_img_create(face_748_2_dial);
    lv_img_set_src(face_748_2_dial_0_424, &face_748_2_dial_dial_img_0_424_0);
    lv_obj_set_width(face_748_2_dial_0_424, LV_SIZE_CONTENT);
    lv_obj_set_height(face_748_2_dial_0_424, LV_SIZE_CONTENT);
    lv_obj_set_x(face_748_2_dial_0_424, 0);
    lv_obj_set_y(face_748_2_dial_0_424, 0);
    lv_obj_add_flag(face_748_2_dial_0_424, LV_OBJ_FLAG_ADV_HITTEST);
    lv_obj_clear_flag(face_748_2_dial_0_424, LV_OBJ_FLAG_SCROLLABLE);

    face_748_2_dial_1_65535 = lv_img_create(face_748_2_dial);
    lv_img_set_src(face_748_2_dial_1_65535, &face_748_2_dial_dial_img_1_65535_0);
    lv_obj_set_width(face_748_2_dial_1_65535, LV_SIZE_CONTENT);
    lv_obj_set_height(face_748_2_dial_1_65535, LV_SIZE_CONTENT);
    lv_obj_set_x(face_748_2_dial_1_65535, 177);
    lv_obj_set_y(face_748_2_dial_1_65535, 91);
    lv_obj_add_flag(face_748_2_dial_1_65535, LV_OBJ_FLAG_ADV_HITTEST);
    lv_obj_clear_flag(face_748_2_dial_1_65535, LV_OBJ_FLAG_SCROLLABLE);

    face_748_2_dial_3_101560 = lv_img_create(face_748_2_dial);
    lv_img_set_src(face_748_2_dial_3_101560, &face_748_2_dial_dial_img_3_101560_0);
    lv_obj_set_width(face_748_2_dial_3_101560, LV_SIZE_CONTENT);
    lv_obj_set_height(face_748_2_dial_3_101560, LV_SIZE_CONTENT);
    lv_obj_set_x(face_748_2_dial_3_101560, 116);
    lv_obj_set_y(face_748_2_dial_3_101560, 157);
    lv_obj_add_flag(face_748_2_dial_3_101560, LV_OBJ_FLAG_ADV_HITTEST);
    lv_obj_clear_flag(face_748_2_dial_3_101560, LV_OBJ_FLAG_SCROLLABLE);

    face_748_2_dial_5_72552 = lv_img_create(face_748_2_dial);
    lv_img_set_src(face_748_2_dial_5_72552, &face_748_2_dial_dial_img_5_72552_0);
    lv_obj_set_width(face_748_2_dial_5_72552, LV_SIZE_CONTENT);
    lv_obj_set_height(face_748_2_dial_5_72552, LV_SIZE_CONTENT);
    lv_obj_set_x(face_748_2_dial_5_72552, 130);
    lv_obj_set_y(face_748_2_dial_5_72552, 82);
    lv_obj_add_flag(face_748_2_dial_5_72552, LV_OBJ_FLAG_ADV_HITTEST);
    lv_obj_clear_flag(face_748_2_dial_5_72552, LV_OBJ_FLAG_SCROLLABLE);

    face_748_2_dial_6_58522 = lv_img_create(face_748_2_dial);
    lv_img_set_src(face_748_2_dial_6_58522, &face_748_2_dial_dial_img_6_58522_0);
    lv_obj_set_width(face_748_2_dial_6_58522, LV_SIZE_CONTENT);
    lv_obj_set_height(face_748_2_dial_6_58522, LV_SIZE_CONTENT);
    lv_obj_set_x(face_748_2_dial_6_58522, 153);
    lv_obj_set_y(face_748_2_dial_6_58522, 40);
    lv_obj_add_flag(face_748_2_dial_6_58522, LV_OBJ_FLAG_ADV_HITTEST);
    lv_obj_clear_flag(face_748_2_dial_6_58522, LV_OBJ_FLAG_SCROLLABLE);

    face_748_2_dial_7_58522 = lv_img_create(face_748_2_dial);
    lv_img_set_src(face_748_2_dial_7_58522, &face_748_2_dial_dial_img_6_58522_0);
    lv_obj_set_width(face_748_2_dial_7_58522, LV_SIZE_CONTENT);
    lv_obj_set_height(face_748_2_dial_7_58522, LV_SIZE_CONTENT);
    lv_obj_set_x(face_748_2_dial_7_58522, 142);
    lv_obj_set_y(face_748_2_dial_7_58522, 40);
    lv_obj_add_flag(face_748_2_dial_7_58522, LV_OBJ_FLAG_ADV_HITTEST);
    lv_obj_clear_flag(face_748_2_dial_7_58522, LV_OBJ_FLAG_SCROLLABLE);

    face_748_2_dial_8_58522 = lv_img_create(face_748_2_dial);
    lv_img_set_src(face_748_2_dial_8_58522, &face_748_2_dial_dial_img_6_58522_0);
    lv_obj_set_width(face_748_2_dial_8_58522, LV_SIZE_CONTENT);
    lv_obj_set_height(face_748_2_dial_8_58522, LV_SIZE_CONTENT);
    lv_obj_set_x(face_748_2_dial_8_58522, 131);
    lv_obj_set_y(face_748_2_dial_8_58522, 40);
    lv_obj_add_flag(face_748_2_dial_8_58522, LV_OBJ_FLAG_ADV_HITTEST);
    lv_obj_clear_flag(face_748_2_dial_8_58522, LV_OBJ_FLAG_SCROLLABLE);

    face_748_2_dial_9_58522 = lv_img_create(face_748_2_dial);
    lv_img_set_src(face_748_2_dial_9_58522, &face_748_2_dial_dial_img_6_58522_0);
    lv_obj_set_width(face_748_2_dial_9_58522, LV_SIZE_CONTENT);
    lv_obj_set_height(face_748_2_dial_9_58522, LV_SIZE_CONTENT);
    lv_obj_set_x(face_748_2_dial_9_58522, 170);
    lv_obj_set_y(face_748_2_dial_9_58522, 191);
    lv_obj_add_flag(face_748_2_dial_9_58522, LV_OBJ_FLAG_ADV_HITTEST);
    lv_obj_clear_flag(face_748_2_dial_9_58522, LV_OBJ_FLAG_SCROLLABLE);

    face_748_2_dial_10_58522 = lv_img_create(face_748_2_dial);
    lv_img_set_src(face_748_2_dial_10_58522, &face_748_2_dial_dial_img_6_58522_0);
    lv_obj_set_width(face_748_2_dial_10_58522, LV_SIZE_CONTENT);
    lv_obj_set_height(face_748_2_dial_10_58522, LV_SIZE_CONTENT);
    lv_obj_set_x(face_748_2_dial_10_58522, 159);
    lv_obj_set_y(face_748_2_dial_10_58522, 191);
    lv_obj_add_flag(face_748_2_dial_10_58522, LV_OBJ_FLAG_ADV_HITTEST);
    lv_obj_clear_flag(face_748_2_dial_10_58522, LV_OBJ_FLAG_SCROLLABLE);

    face_748_2_dial_11_58522 = lv_img_create(face_748_2_dial);
    lv_img_set_src(face_748_2_dial_11_58522, &face_748_2_dial_dial_img_6_58522_0);
    lv_obj_set_width(face_748_2_dial_11_58522, LV_SIZE_CONTENT);
    lv_obj_set_height(face_748_2_dial_11_58522, LV_SIZE_CONTENT);
    lv_obj_set_x(face_748_2_dial_11_58522, 148);
    lv_obj_set_y(face_748_2_dial_11_58522, 191);
    lv_obj_add_flag(face_748_2_dial_11_58522, LV_OBJ_FLAG_ADV_HITTEST);
    lv_obj_clear_flag(face_748_2_dial_11_58522, LV_OBJ_FLAG_SCROLLABLE);

    face_748_2_dial_12_58522 = lv_img_create(face_748_2_dial);
    lv_img_set_src(face_748_2_dial_12_58522, &face_748_2_dial_dial_img_6_58522_0);
    lv_obj_set_width(face_748_2_dial_12_58522, LV_SIZE_CONTENT);
    lv_obj_set_height(face_748_2_dial_12_58522, LV_SIZE_CONTENT);
    lv_obj_set_x(face_748_2_dial_12_58522, 137);
    lv_obj_set_y(face_748_2_dial_12_58522, 191);
    lv_obj_add_flag(face_748_2_dial_12_58522, LV_OBJ_FLAG_ADV_HITTEST);
    lv_obj_clear_flag(face_748_2_dial_12_58522, LV_OBJ_FLAG_SCROLLABLE);

    face_748_2_dial_13_58522 = lv_img_create(face_748_2_dial);
    lv_img_set_src(face_748_2_dial_13_58522, &face_748_2_dial_dial_img_6_58522_0);
    lv_obj_set_width(face_748_2_dial_13_58522, LV_SIZE_CONTENT);
    lv_obj_set_height(face_748_2_dial_13_58522, LV_SIZE_CONTENT);
    lv_obj_set_x(face_748_2_dial_13_58522, 126);
    lv_obj_set_y(face_748_2_dial_13_58522, 191);
    lv_obj_add_flag(face_748_2_dial_13_58522, LV_OBJ_FLAG_ADV_HITTEST);
    lv_obj_clear_flag(face_748_2_dial_13_58522, LV_OBJ_FLAG_SCROLLABLE);

    face_748_2_dial_14_80686 = lv_img_create(face_748_2_dial);
    lv_img_set_src(face_748_2_dial_14_80686, &face_748_2_dial_dial_img_14_80686_0);
    lv_obj_set_width(face_748_2_dial_14_80686, LV_SIZE_CONTENT);
    lv_obj_set_height(face_748_2_dial_14_80686, LV_SIZE_CONTENT);
    lv_obj_set_x(face_748_2_dial_14_80686, 166);
    lv_obj_set_y(face_748_2_dial_14_80686, 117);
    lv_obj_add_flag(face_748_2_dial_14_80686, LV_OBJ_FLAG_ADV_HITTEST);
    lv_obj_clear_flag(face_748_2_dial_14_80686, LV_OBJ_FLAG_SCROLLABLE);

    face_748_2_dial_15_82792 = lv_img_create(face_748_2_dial);
    lv_img_set_src(face_748_2_dial_15_82792, &face_748_2_dial_dial_img_15_82792_0);
    lv_obj_set_width(face_748_2_dial_15_82792, LV_SIZE_CONTENT);
    lv_obj_set_height(face_748_2_dial_15_82792, LV_SIZE_CONTENT);
    lv_obj_set_x(face_748_2_dial_15_82792, 138);
    lv_obj_set_y(face_748_2_dial_15_82792, 102);
    lv_obj_add_flag(face_748_2_dial_15_82792, LV_OBJ_FLAG_ADV_HITTEST);
    lv_obj_clear_flag(face_748_2_dial_15_82792, LV_OBJ_FLAG_SCROLLABLE);

    face_748_2_dial_16_82792 = lv_img_create(face_748_2_dial);
    lv_img_set_src(face_748_2_dial_16_82792, &face_748_2_dial_dial_img_15_82792_0);
    lv_obj_set_width(face_748_2_dial_16_82792, LV_SIZE_CONTENT);
    lv_obj_set_height(face_748_2_dial_16_82792, LV_SIZE_CONTENT);
    lv_obj_set_x(face_748_2_dial_16_82792, 110);
    lv_obj_set_y(face_748_2_dial_16_82792, 102);
    lv_obj_add_flag(face_748_2_dial_16_82792, LV_OBJ_FLAG_ADV_HITTEST);
    lv_obj_clear_flag(face_748_2_dial_16_82792, LV_OBJ_FLAG_SCROLLABLE);

    face_748_2_dial_17_82792 = lv_img_create(face_748_2_dial);
    lv_img_set_src(face_748_2_dial_17_82792, &face_748_2_dial_dial_img_15_82792_0);
    lv_obj_set_width(face_748_2_dial_17_82792, LV_SIZE_CONTENT);
    lv_obj_set_height(face_748_2_dial_17_82792, LV_SIZE_CONTENT);
    lv_obj_set_x(face_748_2_dial_17_82792, 204);
    lv_obj_set_y(face_748_2_dial_17_82792, 102);
    lv_obj_add_flag(face_748_2_dial_17_82792, LV_OBJ_FLAG_ADV_HITTEST);
    lv_obj_clear_flag(face_748_2_dial_17_82792, LV_OBJ_FLAG_SCROLLABLE);

    face_748_2_dial_18_82792 = lv_img_create(face_748_2_dial);
    lv_img_set_src(face_748_2_dial_18_82792, &face_748_2_dial_dial_img_15_82792_0);
    lv_obj_set_width(face_748_2_dial_18_82792, LV_SIZE_CONTENT);
    lv_obj_set_height(face_748_2_dial_18_82792, LV_SIZE_CONTENT);
    lv_obj_set_x(face_748_2_dial_18_82792, 176);
    lv_obj_set_y(face_748_2_dial_18_82792, 102);
    lv_obj_add_flag(face_748_2_dial_18_82792, LV_OBJ_FLAG_ADV_HITTEST);
    lv_obj_clear_flag(face_748_2_dial_18_82792, LV_OBJ_FLAG_SCROLLABLE);

    face_748_2_dial_19_80958 = lv_img_create(face_748_2_dial);
    lv_img_set_src(face_748_2_dial_19_80958, &face_748_2_dial_dial_img_19_80958_0);
    lv_obj_set_width(face_748_2_dial_19_80958, LV_SIZE_CONTENT);
    lv_obj_set_height(face_748_2_dial_19_80958, LV_SIZE_CONTENT);
    lv_obj_set_x(face_748_2_dial_19_80958, 199);
    lv_obj_set_y(face_748_2_dial_19_80958, 82);
    lv_obj_add_flag(face_748_2_dial_19_80958, LV_OBJ_FLAG_ADV_HITTEST);
    lv_obj_clear_flag(face_748_2_dial_19_80958, LV_OBJ_FLAG_SCROLLABLE);

    face_748_2_dial_20_80958 = lv_img_create(face_748_2_dial);
    lv_img_set_src(face_748_2_dial_20_80958, &face_748_2_dial_dial_img_19_80958_0);
    lv_obj_set_width(face_748_2_dial_20_80958, LV_SIZE_CONTENT);
    lv_obj_set_height(face_748_2_dial_20_80958, LV_SIZE_CONTENT);
    lv_obj_set_x(face_748_2_dial_20_80958, 189);
    lv_obj_set_y(face_748_2_dial_20_80958, 82);
    lv_obj_add_flag(face_748_2_dial_20_80958, LV_OBJ_FLAG_ADV_HITTEST);
    lv_obj_clear_flag(face_748_2_dial_20_80958, LV_OBJ_FLAG_SCROLLABLE);

}

static watchface_ui_api_t ui_api = {
    .show = watchface_748_2_dial_show,
    .remove = watchface_748_2_dial_remove,
    .set_battery_percent = watchface_748_2_dial_set_battery_percent,
    .set_hrm = watchface_748_2_dial_set_hrm,
    .set_step = watchface_748_2_dial_set_step,
    .set_ble_connected = watchface_748_2_dial_set_ble_connected,
    .set_num_notifcations = watchface_748_2_dial_set_num_notifcations,
    .set_weather = watchface_748_2_dial_set_weather,
    .set_datetime = watchface_748_2_dial_set_datetime,
    .set_watch_env_sensors = watchface_748_2_dial_set_watch_env_sensors,
    .ui_invalidate_cached = watchface_748_2_dial_invalidate_cached,
};

static int watchface_748_2_dial_init(void)
{
    watchface_app_register_ui(&ui_api);

    return 0;
}

SYS_INIT(watchface_748_2_dial_init, APPLICATION, WATCHFACE_UI_INIT_PRIO);

```

Kampi, 2024-04-18:
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

Working on HW too :)

Needs a quick fix because I haven´t placed the images in the external flash (open point) but it looks good

fbiego, 2024-04-18:
@Kampi there was no documentation on the watchface format so most of it was identifying patterns in the structure
https://github.com/Kampi/esp32-lvgl-watchface/pull/1
btw, X5 Pro dials are 360x360 and may not be suitable however i have been working on a resize script that reduces the size to 240x240. I will add that to the repo soon

Kampi, 2024-04-19:
@fbiego we want to reduce the redrawing load for the CPU by adding a check for a needed reload. Unfortunately I can not add it to the Kotlin code because I don´t know
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

Thread 257 (2024-04-17):

Implement Chronos App support

jakkra, 2024-04-17:
I created a skeleton here: https://github.com/jakkra/ZSWatch/tree/jakkra_ble_chronos_app

Commands: https://github.com/fbiego/dt78/blob/master/DT78_COMMANDS.md

Find more info in https://github.com/jakkra/ZSWatch/issues/254

fbiego, 2024-04-17:
I have forked the repo and will be working on it soon. Just a quick question, what name and service(s) does the watch advertise for ble discovery?

jakkra, 2024-04-17:
> I have forked the repo and will be working on it soon. Just a quick question, what name and service(s) does the watch advertise for ble discovery?

Just the NUS UUID. If you have a Linux computer you can run everything in Linux (even with Bluetooth) if you want to experiment :) https://github.com/jakkra/ZSWatch/blob/main/GETTING_STARTED.md#1-native-posix

Although Zephyr can be a bit daunting if you have not worked with it before.

fbiego, 2024-04-17:
Yeah, haven't worked with Zephyr before but I'll try to set it up

fbiego, 2024-05-15:
I haven't had any luck setting up Zephyr. Considering this, I'm contemplating rewriting the Chronos library in C.

jakkra, 2024-05-15:
> I haven't had any luck setting up Zephyr. Considering this, I'm contemplating rewriting the Chronos library in C.

I guess you turned on CPP support in Zephyr?
Of you rewrite it in c, I suggest having a port layer with transmit and receive functions, and then your target platform can implement those however suitable.

fbiego, 2024-06-01:
Hi @jakkra and @Kampi,

I have created PR #290, which still needs review, particularly regarding the implementation of the functions.

Could you please review the code and provide guidance on how to properly implement these functions? I'm currently unable to test on my end as I have not gotten Zephyr running yet.

jakkra, 2024-06-02:
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

Ho, very nice, I'm busy now for 2 days,  but will look into it after that!

fbiego, 2025-02-27:
I had a successful test with Chronos app ble integration, I will cleanup the code over the weekend and create a PR

fbiego, 2025-03-29:
Is it possible to use bin files instead of c array on posix?
Just curious because I want to try custom bin watchfaces saved on external flash.
This would mean watchfaces can be installed without recompiling firmware.

https://www.youtube.com/watch?v=qXx6tj7s6pQ
https://github.com/fbiego/esp32-c3-mini/blob/main/src/ui/custom_face.c

Thread 267 (2024-05-07):

Improve RV-8263-C8 driver in Zephyr

Kampi, 2024-05-07:
- Alarm functions missing
- Needed for https://github.com/jakkra/ZSWatch-HW/issues/44

Closed 2024-07-17.

Thread 278 (2024-05-15):

Weather app and fetching weather over http

jakkra, 2024-05-15:
The weather integration in gadgetbridge requested an external extra app and for me it's not reliable.

Fetch weather data using the Gadgetbridge HTTP functionality from some suitable weather API.

Should display a forecast of a few days also.

Maybe pressing on weather icon on a watchface should open the weather app.

- Icons possibly use: https://github.com/roe-dl/weathericons/tree/master/weathericons-filled
- https://open-meteo.com/ free for open source and no API key needed - Perfect for US!
  - [Example request](https://api.open-meteo.com/v1/forecast?latitude=55.6059&longitude=13.0007&current=temperature_2m,apparent_temperature,weather_code&daily=weather_code,temperature_2m_max,temperature_2m_min,apparent_temperature_max,apparent_temperature_min,precipitation_sum,rain_sum,precipitation_probability_max&timezone=Europe%2FBerlin&forecast_days=3)
  - Drawback, seem to want long + lat and not a Location. Makes input it harder. Maybe GB sends position?

jakkra, 2024-05-22:
Let's borrow the design from Android :) Think it looks quite nice
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

Kampi, 2024-05-22:
Uh that looks quite nice

Closed 2024-07-13.

Thread 286 (2024-05-30):

magnetic dock connector

schotter, 2024-05-30:
Hi, are you using EDAC's [POGO+](https://edac.net/products/spring-loaded-connectors/225)?

jakkra, 2024-05-30:
Nope, it's custom. Or a low profile pin header as alternative.
I have searched everywhere to find a low profile magnetic connector with 5 connections, but impossible.
If you know one I'll happily change :)

schotter, 2024-05-30:
I saw this [post](https://www.mikrocontroller.net/topic/560317#new) months ago and your mechanism reminded me of it.
There exist 5 pin versions of those [POGOs](https://www.digikey.de/en/products/detail/edac-inc/685d05c2p51110e/21299673) but the minimum quantity is 100 (digikey and mouser). By chance I stumbled upon connectors from [Mill](https://www.digikey.de/en/products/detail/mill-max-manufacturing-corp/858-10-005-10-012000/7667983) [Max](https://www.digikey.de/en/products/detail/mill-max-manufacturing-corp/858-22-005-10-011101/7313772), but I have no experience with those... So just for your inspiration ;)

jakkra, 2024-05-30:
> I saw this [post](https://www.mikrocontroller.net/topic/560317#new) months ago and your mechanism reminded me of it. There exist 5 pin versions of those [POGOs](https://www.digikey.de/en/products/detail/edac-inc/685d05c2p51110e/21299673) but the minimum quantity is 100 (digikey and mouser). By chance I stumbled upon connectors from [Mill](https://www.digikey.de/en/products/detail/mill-max-manufacturing-corp/858-10-005-10-012000/7667983) [Max](https://www.digikey.de/en/products/detail/mill-max-manufacturing-corp/858-22-005-10-011101/7313772), but I have no experience with those... So just for your inspiration ;)

Thanks, will take a look, maybe something new came in last year, was ast summer I searched all internet for one. Often issue wa they where too thick, want them thin so they don't add too much thickness to the watch.

Closed 2024-05-30.

Thread 309 (2024-07-15):

Using the RTC update for the 1s periodic event

Kampi, 2024-07-15:
Replace the timer for the 1s periodic callback with the RTC update function when using rev 5

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

Kampi, 2024-07-15:
@jakkra maybe we can replace the 10 seconds timer too?

jakkra, 2024-07-15:
@Kampi make sure both 1s and 10s are still executed in the system workqueue context. i.e. switch the delayed work to just a k_work when the RTC ISR happens.

Drawback of using it also for 10s, is that we still need to wake up every 1s, even if there are none listening on 10s. Lower accuracy on 10s is fine IMO.

Kampi, 2024-07-15:
@jakkra good point. We also can't use the alarm for this because we need the alarm for something like a stopwatch. So let's start with 1s first.
I want to use a worker scheduling in the update callback to make sure that there is no difference. So it's the same scenario for all listeners as now.

Kampi, 2024-07-15:
@jakkra the question how to add this to the code. We can add only one update callback to the driver. So we need a bit of gluecode to handle more than one callback or I move the code from `zsw_periodic_event` to `zsw_clock` but I don´t like this solution because it splits up the code.

jakkra, 2024-07-15:
> @jakkra the question how to add this to the code. We can add only one update callback to the driver. So we need a bit of gluecode to handle more than one callback or I move the code from `zsw_periodic_event` to `zsw_clock` but I don´t like this solution because it splits up the code.

Just from the top of my head how about register the rtc callback in zsw_clock and then add a way to register a tick callback to zsw_clock? Which then `zsw_periodic_event` uses?

Kampi, 2024-07-15:
> > @jakkra the question how to add this to the code. We can add only one update callback to the driver. So we need a bit of gluecode to handle more than one callback or I move the code from `zsw_periodic_event` to `zsw_clock` but I don´t like this solution because it splits up the code.
>
> Just from the top of my head how about register the rtc callback in zsw_clock and then add a way to register a tick callback to zsw_clock? Which then `zsw_periodic_event` uses?

That´s what I mean with gluecode to add more than one callback :)

jakkra, 2024-07-15:
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

Don't have a better suggestion :/

Closed 2024-09-12.

Thread 320 (2024-07-20):

HW3 does not boot with nRF 2.7 with `CONFIG_SPI_NOR_IDLE_IN_DPD`

ldab, 2024-07-20:
Probably not exiting DPD properly after JEDEC

check drivers/flash/spi_nor.c: spi_nor_process_sfdp()

ldab, 2024-07-20:
https://github.com/jakkra/ZSWatch/pull/321

jakkra, 2024-07-20:
Fixed

Closed 2024-07-20.

Thread 349 (2024-08-26):

Error finding board: zswatch_nrf5340_cpunet in  .../app/boards/arm/zswatch_nrf5340.

mirusu400, 2024-08-26:
Hello,
I'm trying to build ZSWatch using [This documentation](https://github.com/jakkra/ZSWatch/wiki/Start-Developing#building-and-flashing), but I'm now struggling with the error:

```
$ west build --board zswatch_nrf5340_cpuapp@3 -- -DOVERLAY_CONFIG="boards/release.conf"
-- west build: generating a build system
patching file drivers/sensor/nordic/npm1300_charger/npm1300_charger.c
Reversed (or previously applied) patch detected!  Assume -R? [n]
Apply anyway? [n]
Skipping patch.
1 out of 1 hunk ignored
can't find file to patch at input line 5
Perhaps you used the wrong -p or --strip option?
The text leading up to this was:
--------------------------
|diff --git a/drivers/sensor/npm1300_charger/npm1300_charger.c b/drivers/sensor/npm1300_charger/npm1300_charger.c
|index 95634a0a50..7495e0f53e 100644
|--- a/drivers/sensor/npm1300_charger/npm1300_charger.c
|+++ b/drivers/sensor/npm1300_charger/npm1300_charger.c
--------------------------
File to patch:
Skip this patch? [y]
Skipping patch.
patch unexpectedly ends in middle of line
1 out of 1 hunk ignored
The next patch would create the file drivers/rtc/rtc_utils.c,
which already exists!  Assume -R? [n]
Apply anyway? [n]
Skipping patch.
1 out of 1 hunk ignored
The next patch would create the file drivers/rtc/rtc_utils.h,
which already exists!  Assume -R? [n]
Apply anyway? [n]
Skipping patch.
1 out of 1 hunk ignored
patching file drivers/rtc/CMakeLists.txt
Reversed (or previously applied) patch detected!  Assume -R? [n]
Apply anyway? [n]
Skipping patch.
1 out of 1 hunk ignored
patching file drivers/rtc/Kconfig
Hunk #1 succeeded at 60 (offset 7 lines).
The next patch would create the file drivers/rtc/Kconfig.rv8263,
which already exists!  Assume -R? [n]
Apply anyway? [n]
Skipping patch.
1 out of 1 hunk ignored
The next patch would create the file drivers/rtc/rtc_rv8263.c,
which already exists!  Assume -R? [n]
Apply anyway? [n]
Skipping patch.
1 out of 1 hunk ignored
The next patch would create the file dts/bindings/rtc/microcrystal,rv-8263-c8.yaml,
which already exists!  Assume -R? [n]
Apply anyway? [n]
Skipping patch.
1 out of 1 hunk ignored
patching file BMP5-Sensor-API/bmp5.c
Reversed (or previously applied) patch detected!  Assume -R? [n]
Apply anyway? [n]
Skipping patch.
1 out of 1 hunk ignored
PCB revision: 3
Loading Zephyr default modules (Zephyr base (cached)).
-- Application: /home/ubuntu/lab/ZSWatch/app
-- CMake version: 3.30.2
-- Using NCS Toolchain 2.6.20240605.1004412633878 for building. (/home/ubuntu/ncs/toolchains/e9dba88316/cmake)
-- Cache files will be written to: /home/ubuntu/.cache/zephyr
-- Zephyr version: 3.6.99 (/home/ubuntu/lab/ZSWatch/zephyr)
-- Found west (found suitable version "1.2.0", minimum required is "0.14.0")
-- Board: zswatch_nrf5340_cpuapp, Revision: 3
-- Found host-tools: zephyr 0.16.5 (/home/ubuntu/ncs/toolchains/e9dba88316/opt/zephyr-sdk)
-- Found toolchain: zephyr 0.16.5 (/home/ubuntu/ncs/toolchains/e9dba88316/opt/zephyr-sdk)
-- Found BOARD.dts: /home/ubuntu/lab/ZSWatch/app/boards/arm/zswatch_nrf5340/zswatch_nrf5340_cpuapp.dts
-- Found devicetree overlay: /home/ubuntu/lab/ZSWatch/app/boards/arm/zswatch_nrf5340/zswatch_nrf5340_cpuapp_3.overlay
-- Generated zephyr.dts: /home/ubuntu/lab/ZSWatch/app/build/zephyr/zephyr.dts
-- Generated devicetree_generated.h: /home/ubuntu/lab/ZSWatch/app/build/zephyr/include/generated/devicetree_generated.h
-- Including generated dts.cmake file: /home/ubuntu/lab/ZSWatch/app/build/zephyr/dts.cmake
CMake Deprecation Warning at /home/ubuntu/lab/ZSWatch/zephyr/cmake/modules/kconfig.cmake:89 (message):
  Use of 'zswatch_nrf5340_cpuapp_3.conf' is deprecated, please switch to
  'zswatch_nrf5340_cpuapp_3_defconfig'
Call Stack (most recent call first):
  /home/ubuntu/lab/ZSWatch/nrf/cmake/modules/kconfig.cmake:29 (include)
  /home/ubuntu/lab/ZSWatch/zephyr/cmake/modules/zephyr_default.cmake:132 (include)
  /home/ubuntu/lab/ZSWatch/zephyr/share/zephyr-package/cmake/ZephyrConfig.cmake:66 (include)
  /home/ubuntu/lab/ZSWatch/zephyr/share/zephyr-package/cmake/ZephyrConfig.cmake:97 (include_boilerplate)
  CMakeLists.txt:45 (find_package)

Parsing /home/ubuntu/lab/ZSWatch/app/Kconfig
Loaded configuration '/home/ubuntu/lab/ZSWatch/app/build/zephyr/.config'
No change to configuration in '/home/ubuntu/lab/ZSWatch/app/build/zephyr/.config'
No change to Kconfig header in '/home/ubuntu/lab/ZSWatch/app/build/zephyr/include/generated/autoconf.h'
-- The C compiler identification is GNU 12.2.0
-- The CXX compiler identification is GNU 12.2.0
-- The ASM compiler identification is GNU
-- Found assembler: /home/ubuntu/ncs/toolchains/e9dba88316/opt/zephyr-sdk/arm-zephyr-eabi/bin/arm-zephyr-eabi-gcc
CMake Warning at /home/ubuntu/lab/ZSWatch/zephyr/CMakeLists.txt:126 (message):
  The environment variable 'CFLAGS' was set to -fdump-tree-optimized-graph
  -fno-devirtualize -fstack-usage, but Zephyr ignores flags from the
  environment.  Use 'cmake -DEXTRA_CFLAGS=-fdump-tree-optimized-graph
  -fno-devirtualize -fstack-usage' instead.

CMake Warning at /home/ubuntu/lab/ZSWatch/zephyr/CMakeLists.txt:126 (message):
  The environment variable 'CXXFLAGS' was set to -fdump-tree-optimized-graph
  -fno-devirtualize -fdump-lang-class -fstack-usage, but Zephyr ignores flags
  from the environment.  Use 'cmake
  -DEXTRA_CXXFLAGS=-fdump-tree-optimized-graph -fno-devirtualize
  -fdump-lang-class -fstack-usage' instead.

CMake Deprecation Warning at /home/ubuntu/lab/ZSWatch/zephyr/soc/CMakeLists.txt:15 (message):

            ---------------------------------------------------------------------
            --- WARNING: Functionality to describe SoCs in HWMv1 is           ---
            --- deprecated and should be replaced with HWMv2, including       ---
            --- boards. HWMv1 SoCs support remains only to ease the migration ---
            --- of out-of-tree SoCs and associated boards. It will not be     ---
            --- possible to build using HWMv1 SoCs at all in future releases. ---
            ---------------------------------------------------------------------

=== child image hci_ipc - CPUNET begin ===
loading initial cache file /home/ubuntu/lab/ZSWatch/app/build/hci_ipc/child_image_preload.cmake
Loading Zephyr default modules (Zephyr base).
-- Application: /home/ubuntu/lab/ZSWatch/zephyr/samples/bluetooth/hci_ipc
-- CMake version: 3.30.2
-- Using NCS Toolchain 2.6.20240605.1004412633878 for building. (/home/ubuntu/ncs/toolchains/e9dba88316/cmake)
-- Found Python3: /home/ubuntu/ncs/toolchains/e9dba88316/usr/local/bin/python3 (found suitable version "3.9.19", minimum required is "3.8") found components: Interpreter
-- Cache files will be written to: /home/ubuntu/.cache/zephyr
-- Zephyr version: 3.6.99 (/home/ubuntu/lab/ZSWatch/zephyr)
-- Found west (found suitable version "1.2.0", minimum required is "0.14.0")
CMake Error at /home/ubuntu/lab/ZSWatch/zephyr/cmake/modules/boards.cmake:234 (message):
  Error finding board: zswatch_nrf5340_cpunet in
  /home/ubuntu/lab/ZSWatch/app/boards/arm/zswatch_nrf5340.

  This indicates the board has been removed, renamed, or placed at a new
  location.

  Please run a pristine build.
Call Stack (most recent call first):
  /home/ubuntu/lab/ZSWatch/zephyr/cmake/modules/zephyr_default.cmake:132 (include)
  /home/ubuntu/lab/ZSWatch/zephyr/share/zephyr-package/cmake/ZephyrConfig.cmake:66 (include)
  /home/ubuntu/lab/ZSWatch/zephyr/share/zephyr-package/cmake/ZephyrConfig.cmake:92 (include_boilerplate)
  CMakeLists.txt:5 (find_package)

-- Configuring incomplete, errors occurred!
CMake Error at /home/ubuntu/lab/ZSWatch/nrf/cmake/multi_image.cmake:502 (message):
  CMake generation for hci_ipc failed, aborting.  Command: 1
Call Stack (most recent call first):
  /home/ubuntu/lab/ZSWatch/nrf/cmake/multi_image.cmake:178 (add_child_image_from_source)
  /home/ubuntu/lab/ZSWatch/nrf/samples/CMakeLists.txt:148 (add_child_image)

-- Configuring incomplete, errors occurred!
FATAL ERROR: command exited with status 1: /usr/bin/cmake -DWEST_PYTHON=/usr/bin/python3 -B/home/ubuntu/lab/ZSWatch/app/build -GNinja -DOVERLAY_CONFIG=boards/release.conf -S/home/ubuntu/lab/ZSWatch/app
```

It said, there are no board named `zswatch_nrf5340_cpunet` in `/home/ubuntu/lab/ZSWatch/app/boards/arm/zswatch_nrf5340` directory, but actually there it is:

```
$ ls /home/ubuntu/lab/ZSWatch/app/boards/arm/zswatch_nrf5340
CMakeLists.txt                       zswatch_nrf5340_cpuapp_1.overlay     zswatch_nrf5340_cpunet-pinctrl.dtsi
Kconfig                              zswatch_nrf5340_cpuapp_2.conf        zswatch_nrf5340_cpunet.dts
Kconfig.board                        zswatch_nrf5340_cpuapp_2.overlay     zswatch_nrf5340_cpunet.yaml
Kconfig.defconfig                    zswatch_nrf5340_cpuapp_3.conf        zswatch_nrf5340_cpunet_1.conf
board.c                              zswatch_nrf5340_cpuapp_3.overlay     zswatch_nrf5340_cpunet_2.conf
board.cmake                          zswatch_nrf5340_cpuapp_4.conf        zswatch_nrf5340_cpunet_3.conf
pre_dt_board.cmake                   zswatch_nrf5340_cpuapp_4.overlay     zswatch_nrf5340_cpunet_4.conf
revision.cmake                       zswatch_nrf5340_cpuapp_5.conf        zswatch_nrf5340_cpunet_5.conf
zswatch_nrf5340_common-pinctrl.dtsi  zswatch_nrf5340_cpuapp_5.overlay     zswatch_nrf5340_cpunet_defconfig
zswatch_nrf5340_common.dts           zswatch_nrf5340_cpuapp_defconfig     zswatch_nrf5340_partition_conf.dts
zswatch_nrf5340_cpuapp.dts           zswatch_nrf5340_cpuapp_ns.dts        zswatch_nrf5340_shared_sram_planning_conf.dts
zswatch_nrf5340_cpuapp.yaml          zswatch_nrf5340_cpuapp_ns.yaml
zswatch_nrf5340_cpuapp_1.conf        zswatch_nrf5340_cpuapp_ns_defconfig
```

How can I solve this problem?

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
jakkra, 2024-08-26:
I think the issue is in the docs. Can you run same command but in ZSWatch root folder and use same west command but add `app`
`west build app --board`

jakkra, 2024-08-26:
This is what's being run in ci:
`west build app --build-dir zswatch_nrf5340_cpuapp@3_debug -p -b zswatch_nrf5340_cpuapp@3 -- -DOVERLAY_CONFIG=boards/debug.conf -DEXTRA_CONF_FILE="boards/bsec.conf" -DBOARD_ROOT=${PWD}/app`

So this should work, could be this extra DBOARD_ROOT that is needed, think I might have added that after upgrading to NCS 2.7

jakkra, 2024-08-26:
> This is what's being run in ci: `west build app --build-dir zswatch_nrf5340_cpuapp@3_debug -p -b zswatch_nrf5340_cpuapp@3 -- -DOVERLAY_CONFIG=boards/debug.conf -DEXTRA_CONF_FILE="boards/bsec.conf" -DBOARD_ROOT=${PWD}/app`
>
> So this should work, could be this extra DBOARD_ROOT that is needed, think I might have added that after upgrading to NCS 2.7

Yes exactly, I forgot to update the docs.
https://github.com/jakkra/ZSWatch/commit/4fcef0f4c5d00941ea593c224eef5cb4cd98ca8f

mirusu400, 2024-08-26:
> This is what's being run in ci: `west build app --build-dir zswatch_nrf5340_cpuapp@3_debug -p -b zswatch_nrf5340_cpuapp@3 -- -DOVERLAY_CONFIG=boards/debug.conf -DEXTRA_CONF_FILE="boards/bsec.conf" -DBOARD_ROOT=${PWD}/app`
>
> So this should work, could be this extra DBOARD_ROOT that is needed, think I might have added that after upgrading to NCS 2.7

Thank you!

But this command also not works...
```
~/lab/ZSWatch$ west build app --build-dir zswatch_nrf5340_cpuapp@3_debug -p -b zswatch_nrf5340_cpuapp@3 -- -DOVERLAY_CONFIG=boards/debug.conf -DEXTRA_CONF_FILE="boards/bsec.conf" -DBOARD_ROOT=${PWD}/app
-- west build: generating a build system
patching file drivers/sensor/nordic/npm1300_charger/npm1300_charger.c
Reversed (or previously applied) patch detected!  Assume -R? [n]
Apply anyway? [n]
Skipping patch.
1 out of 1 hunk ignored

...
[lots of logs..]
...

Number of external filesystem files:642
-- Configuring done (13.5s)
-- Generating done (0.3s)
-- Build files have been written to: /home/ubuntu/lab/ZSWatch/zswatch_nrf5340_cpuapp@3_debug
-- west build: building application
ninja: error: '/home/ubuntu/lab/ZSWatch/app/src/ext_drivers/BSEC2/src/cortex-m4/libalgobsec.a', needed by 'zephyr/zephyr_pre0.elf', missing and no known rule to make it
FATAL ERROR: command exited with status 1: /usr/bin/cmake --build /home/ubuntu/lab/ZSWatch/zswatch_nrf5340_cpuapp@3_debug
```

But in my case this command build successfully:
```
west build --build-dir /home/ubuntu/lab/ZSWatch/app/build /home/ubuntu/lab/ZSWatch/app --pristine --board nrf5340dk_nrf5340_cpuapp -- -DNCS_TOOLCHAIN_VERSION=NONE -DBOARD_ROOT=/home/ubuntu/lab/ZSWatch/app;/home/ubuntu/lab/ZSWatch/zephyr
```

Anyway thanks for quick help!

jakkra, 2024-08-26:
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

The error from my command is because it had: `DEXTRA_CONF_FILE="boards/bsec.conf"`
And the linking failed to to that needs one other command. So remove that and it will work.

Closed 2024-08-26.

Thread 361 (2024-10-17):

Prototype Fund

blubbsy, 2024-10-17:
Hi,

the german open knowledge fundation started togetther with the German Government again a fund for open source projects: https://hardware.prototypefund.de/

it funds 10 projects with 24.500€ for one year and after 12 month a presentable prototype should be done. Is it something ZSWatch should try to apply for? I also would understand that you wont like it, because it somehow builds up pressure to deliver something, but on the other side the big amount of time you invested would have some return :)

Though they write it's focus is on environmental topics the examples show laser cutters, pen holders and more:
https://hardware.prototypefund.de/en/projects-2/

jakkra, 2024-10-17:
Hi, thanks for the suggestion! I have already applied at https://nlnet.nl/funding.Html and should get reply soon. But will look this up if I don't get that!

jakkra, 2024-10-17:
> For the German fund it is time until the end of the month. Why not apply to both and in the worst case you reject one if them? Hope that it works, but I can check the participation conditions.

I see, I'll dig into it a bit. Can probably reuse alot from the other application, thanks :)

jakkra, 2024-10-17:
Oh, I can't apply. But @Kampi if you feel for it, you could give it a try.

> Due to our jury and funding regulations the application has to be in German and has to be submitted by someone with residency in Germany.

Kampi, 2024-10-18:
Yeah I can do it over the weekend.

Kampi, 2024-10-22:
We prepared the first draft for the fund. I will tune it a bit until the end of the month and then we have to cross the fingers :)

blubbsy, 2024-10-24:
Do you want me to take a look on it or are you ok?

Kampi, 2024-10-24:
@blubbsy sure. Can you share your e-mail address with me, so I can invite you?

blubbsy, 2024-10-24:
both possible ;)

discord username: devsibwarra

Closed 2024-10-24.

Thread 365 (2024-10-29):

esim support or sim

wanghaisheng, 2024-10-29:
I dont know if this is right place to ask

Kampi, 2024-10-29:
Hi,

what exactly is the question? Why do we need an eSIM?

wanghaisheng, 2024-10-29:
let me clarify, I want a 4g version

Kampi, 2024-10-29:
That´s currently not an option and not on our agenda. But you can do it on your own.

wanghaisheng, 2024-10-29:
can you point out a direction? any helps is appreciated

jakkra, 2024-10-29:
Chek in the HW repo for the kicad files. It will be hard to fit a cellular module. Maybe with double sided assembly, otherwise some other stuff needs to be removed/reedesigned.

Closed 2024-10-29.

Thread 371 (2025-01-30):

Question | How does environment sensor is exposed to the environment?

Aukstkalnis, 2025-01-30:
Hi. I am very curious about this watch. It is very interesting to have environment sensor on your wrist. But in the PCB the sensor is places behind the LCD.  So how does it senses environment if it is not exposed to it?

The same goes for the MIC. The sound quality can be very bad.

Kampi, 2025-01-30:
Hi,

there is a hole on the bottom side of the housing. This solution isn't ideal yet and we are still working on a better solution.

jakkra, 2025-01-30:
Mic is working great actually, there are holes in the casing and a tunnel allowing air to flow into the watch. Don't have the CAD up right now, but can send a picture later, unless I forget it :p

blubbsy, 2025-01-30:
you mean e.g. these?

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

Kampi, 2025-01-30:
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

Yes, exactly.

jakkra, 2025-01-30:
Also if you check the inner part design from above you see the path that air and sound can flow

Closed 2025-02-03.

Thread 372 (2025-02-14):

Reboot the system by pressing the button

DREAM669, 2025-02-14:
For this watch, if it crashes, can the system be restarted by pressing a button without turning on the power?

Also, can I set the time by pressing the button?

Thank you for your answer.

Thread 375 (2025-03-22):

gc9a01 driver screen cannot be displayed

fghill, 2025-03-22:
I encountered a problem where the screen failed to display when developing the screen display using Zephyr. My screen is a 1.28-inch circular color TFT display with a high-definition IPS module of 240*240 and an SPI interface, driven by GC9A01. I called the driver file display_gc9x01x.c under the directory F:\zephyr\zephyrproject\zephyr\drivers\display. When I ran "west build -p always -b esp32s3_devkitm", there were no error reports. However, after burning it into my mainboard, the display function failed to work, even showing a black screen. Is it a compatibility issue with my driver?

jakkra, 2025-03-22:
Are you running ZSWatch on an ESP32 board? ZSWatch use a modified Gc9a01 driver in order to o support low power modes better. In theory I think using the Zephyr GC9A01 driver should work, as it will just always be on. But don't see why not use ZSWatch driver as it is in the repo and built automically.

fghill, 2025-03-23:
Thank you for your reply. I used esp32s3-n8r2 for development. I defined the SDA, SCL, CS, RES and DC of the screen in the pin under gpio1 of esp32.overlay file, that is, gpio38 to gpio42. I used the driver in the zephyr driver directory. Now I am ready to use the driver you provided. If I succeed, I will come back and tell you.

Closed 2025-03-23.

Thread 381 (2025-04-08):

error realtime display on watchface

HiJackhem, 2025-04-08:
Start time should be 1970-01-01, not 1970-00-01. It will lead to the real month less one.

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

jakkra, 2025-04-08:
Hehe you are right, can see it myself now. Will fix once I get a chance. Feel free to submit a PR if you know where to change.

Kampi, 2025-04-08:
Do you use the external RTC? There was a bug in the RTC driver which I have fixed in Upstream Zephyr:

https://github.com/zephyrproject-rtos/zephyr/commit/db9b45a7b3f0d2a2b63a840d8d7d3abfcdb7709b

Maybe this fix isn´t ported to ZSWatch currently?

jakkra, 2025-04-08:
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

I got the same issue without RTC myself. So not related.

Thread 384 (2025-04-11):

Fix error messages in Sensor Fusion App

ergo333, 2025-04-11:
**Problem Description**

The strings used for error reporting in the file `[app/src/sensor_fusion/zsw_sensor_fusion.c]` are currently misleading or incorrect. They do not accurately describe the error condition that occurs, making debugging and understanding the underlying problem more difficult.

**Affected File / Function**

* **File:** `[app/src/sensor_fusion/zsw_sensor_fusion.c]`
* **Function:** `sensor_fusion_timeout`

**Examples of Incorrect Strings/Usage within `sensor_fusion_timeout`**

1.  **Log String:**
    ```c
    LOG_ERR("zsw_imu_fetch_gyro_f err: %d", ret);
    ```
    * **Context/Issue:** This exact log message appears three times within the `sensor_fusion_timeout` function.
        * The **first instance**, presumably within a context genuinely attempting to fetch gyroscope data, appears to be **correct**.
        * However, the **second and third instances** of this *exact same log message* are **incorrect**.
    * **Problem:** The log message incorrectly states `_gyro_f` even when the error (`ret`) originates from fetching a different sensor type within the same function. This is misleading during debugging, as it points the developer towards a gyroscope issue when the problem lies with a different sensor fetch attempt (e.g., accelerometer data).

Thanks you so much for your project! It's very interesting.

Closed 2025-06-15.

Thread 393 (2025-06-24):

Buying device

sx1262-test, 2025-06-24:
Hi Jakob,

More by incident than really looking for this I saw a video about your watch. First of all, respect for this cool work.
Is it possible to get a ZSWatch or to buy it somewhere? I'm really interested in trying it out and write code for it to expand it for my purposes if not covering all already.

Best

Andreas

jakkra, 2025-06-24:
Hi, we have developed a development kit we currently are waiting to receive to validate the design. Once that's done we will have some of those to sell for people who want to get started early. Suggest you read here and sign up on the mail list where we will keep you updated about progress. https://zswatch.dev/blog

sx1262-test, 2025-06-25:
Hi, many thanks. I put my address on the list. Andreas

Thread 406 (2025-08-11):

Issue with Bluetooth Connection on iOS

HongNguyen635, 2025-08-11:
I'm current on iOS 18.5, and is using nRF Connect Mobile app to connect.
I'm on debug mode, and the log shows that the connection is successful and the Bluetooth icon appeaers on the screen as well, however, time is not updated on the watch. I tried to switch to another phone also on iOS 18 and the same issue persists.

Below is a snipet from the log:
```
[00:00:11.833,312] <inf> ble_comm: Connected <the address> (random)
[00:00:11.833,496] <inf> ble_comm: MTU exchange pending
[00:00:11.833,526] <inf> ble_comm: Interval: 24, latency: 0, timeout: 72
[00:00:11.833,557] <inf> ble_chronos: Bluetooth  Connected
[00:00:11.836,578] <wrn> bt_hci_core: opcode 0x2022 status 0x0c
[00:00:11.836,608] <err> bt_conn: Failed to set data len (-13)
[00:00:12.094,451] <inf> ble_comm: LE PHY updated: TX PHY LE 2M, RX PHY LE 2M
[00:00:12.154,724] <inf> ble_comm: LE PHY updated: TX PHY LE 2M, RX PHY LE 2M
[00:00:12.184,356] <inf> ble_comm: LE data len updated: TX (len: 251 time: 2120) RX (len: 251 time: 2120)

[00:00:12.184,783] <inf> ble_comm: MTU exchange done. 244
[00:00:12.185,394] <wrn> bt_l2cap: Ignoring data for unknown channel ID 0x003a
[00:00:12.425,292] <dbg> ble_cts: discover_completed_cb: The discovery procedure succeeded```

HongNguyen635, 2025-08-11:
I'm building with RTC, and with the head up-to-date with main branch.

jakkra, 2025-08-11:
> I'm building with RTC, and with the head up-to-date with main branch.

You could try without, there is a conf no_rtc.conf to build with, don't think that's the problem, but you could try if you want. Anyway I'll check tonight when I have access to an iPhone.

HongNguyen635, 2025-08-12:
I'm closing this issue because it's been addressed in #407

Thread 423 (2025-08-20):

USB and UART automatically enabled/disabled when VBUS connect/disconnect

jakkra, 2025-08-20:
nPM1300 gives us VBUS events so it should be possible to enable/disable UART and USB functionality when watch is not connected to power.

This will make sure lowest power consumption when watch is not being charged/connected to a computer, and will seamless work when pluggin into a computer as USB and UART will then be automatically enabled, instead of manual need to enable/disable in the watch "update_app".

May want to think about devices in CI which we need logs to be enabled, while also measure current consumption (PPK2 connected as power source instead of battery). => Check if it's possible to dynamically disable UART RX to save power, meaning logs still work but power consumption is low. This is possible in dts, but we need dynamic as we want Shell over uart together with logs enabled.

jakkra, 2025-10-04:
I'm implementing this in a slightly different way. We don't want to always have USB enabled, as using USB requires XIP also enabled (due to us having USB code in XIP). This is not the problem, but during development we may miss bugs caused by XIP getting turned off. If we always have USB enabled, means XIP always enabled and we may miss bugs.

So instead I implemented it so after a reset we enable USB for 10 or 20s and see if someone connects USB, if not we disable it. This allows easier testing in CI as we can in CI just reset the device and then open the USB and USB will be kept on.

UART logging I made TX only, hence it's low power and don't require special handling.

Thread 436 (2025-08-29):

Update / sync license texts in the code

Kampi, 2025-08-29:
We should update them to the ZSWatch project and add them if missing.

jakkra, 2025-08-29:
Board we should also make sure it's Apache-2.0 as I think it's good id anyone can use the board files with the HW without GPL license restrictions.

Kampi, 2025-08-29:
> Board we should also make sure it's Apache-2.0 as I think it's good id anyone can use the board files with the HW without GPL license restrictions.

The files already contain the Apache header.
