jakkra/ZSWatch/ZSWatch-kicad-v2/ZSWatch.kicad_pcb

## KiCad design ZSWatch-kicad-v2/ZSWatch.kicad_pcb (2023-08-02, last stored version)

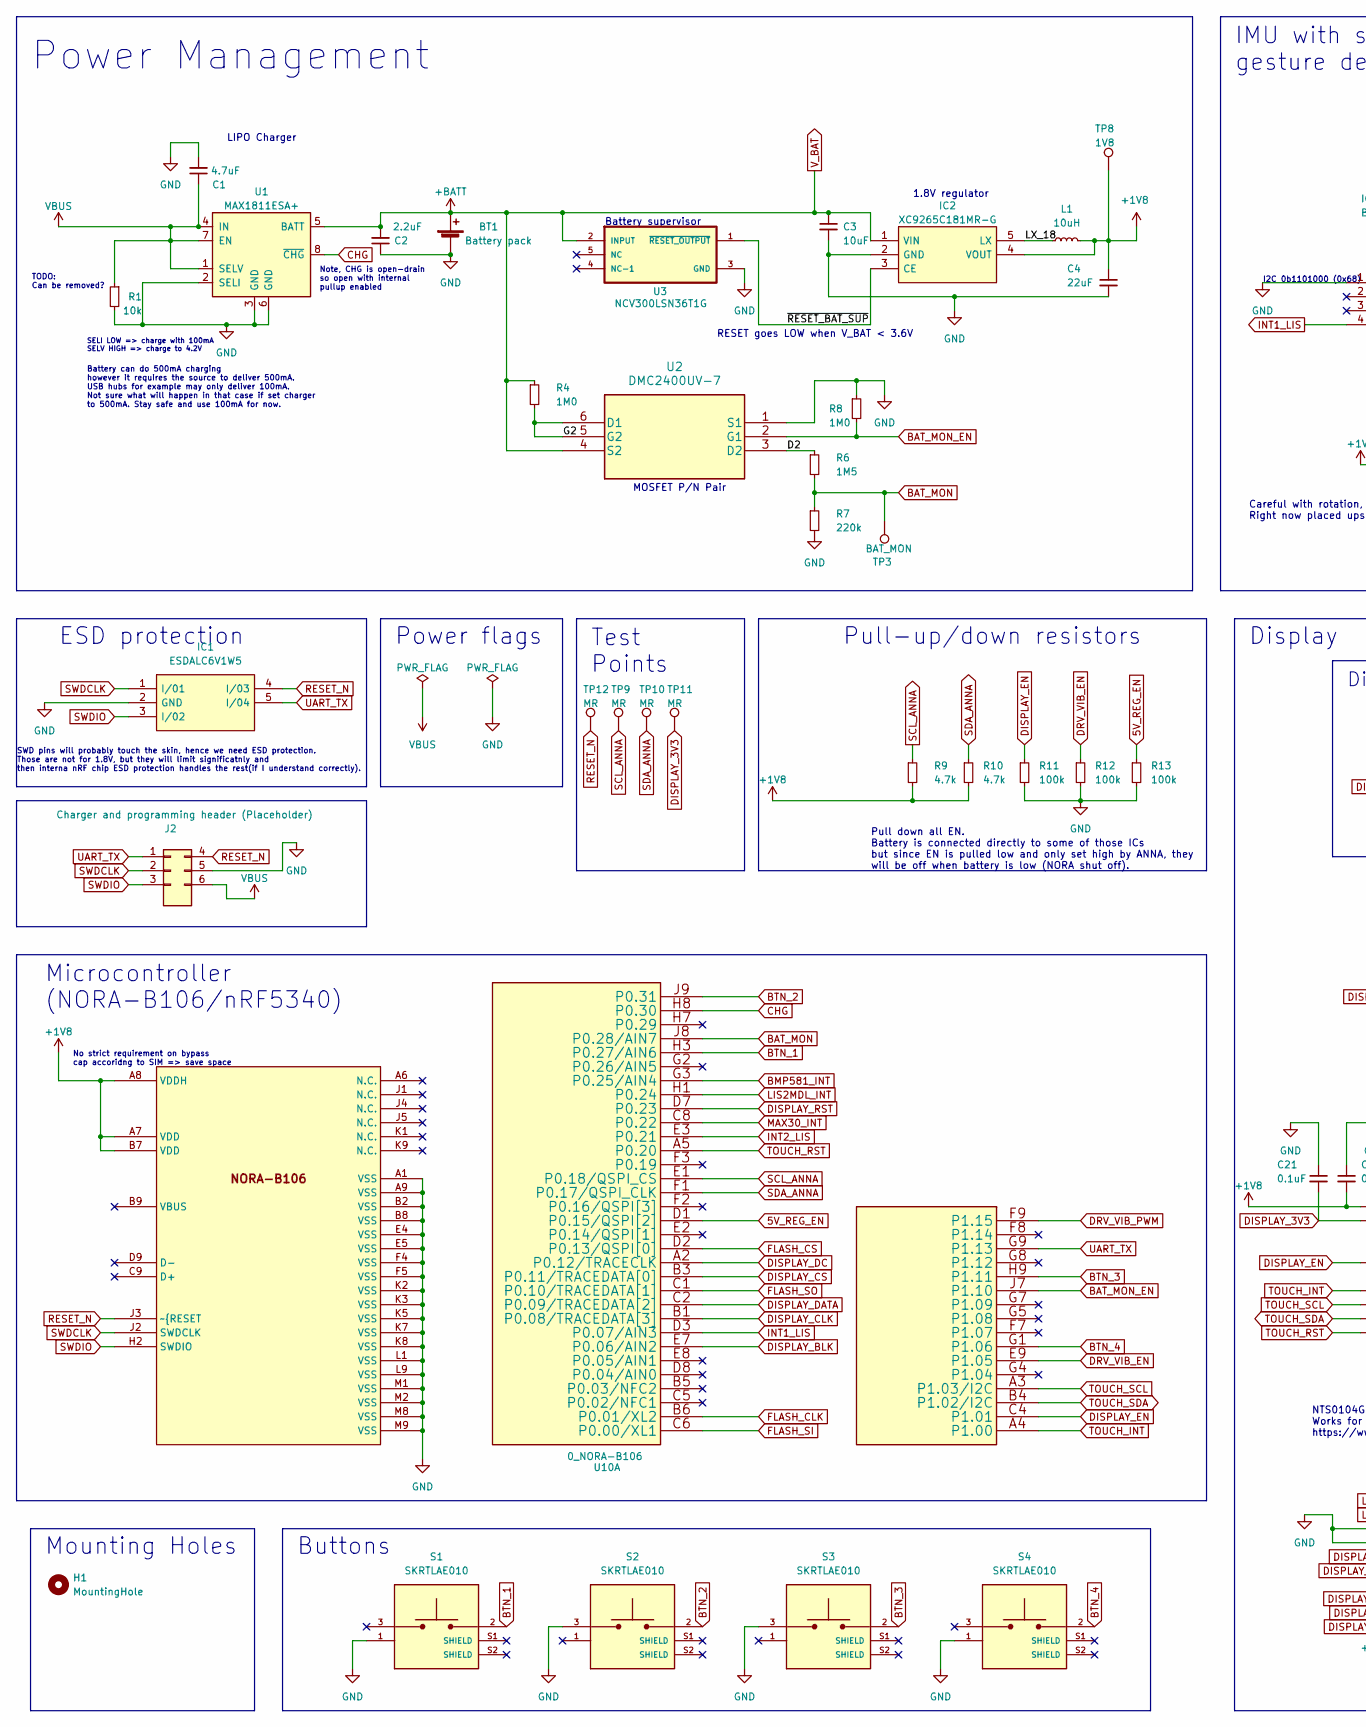
[picture p20: schematic ZSWatch.kicad_sch, ZSWatch v2, part in row 1, column 1]

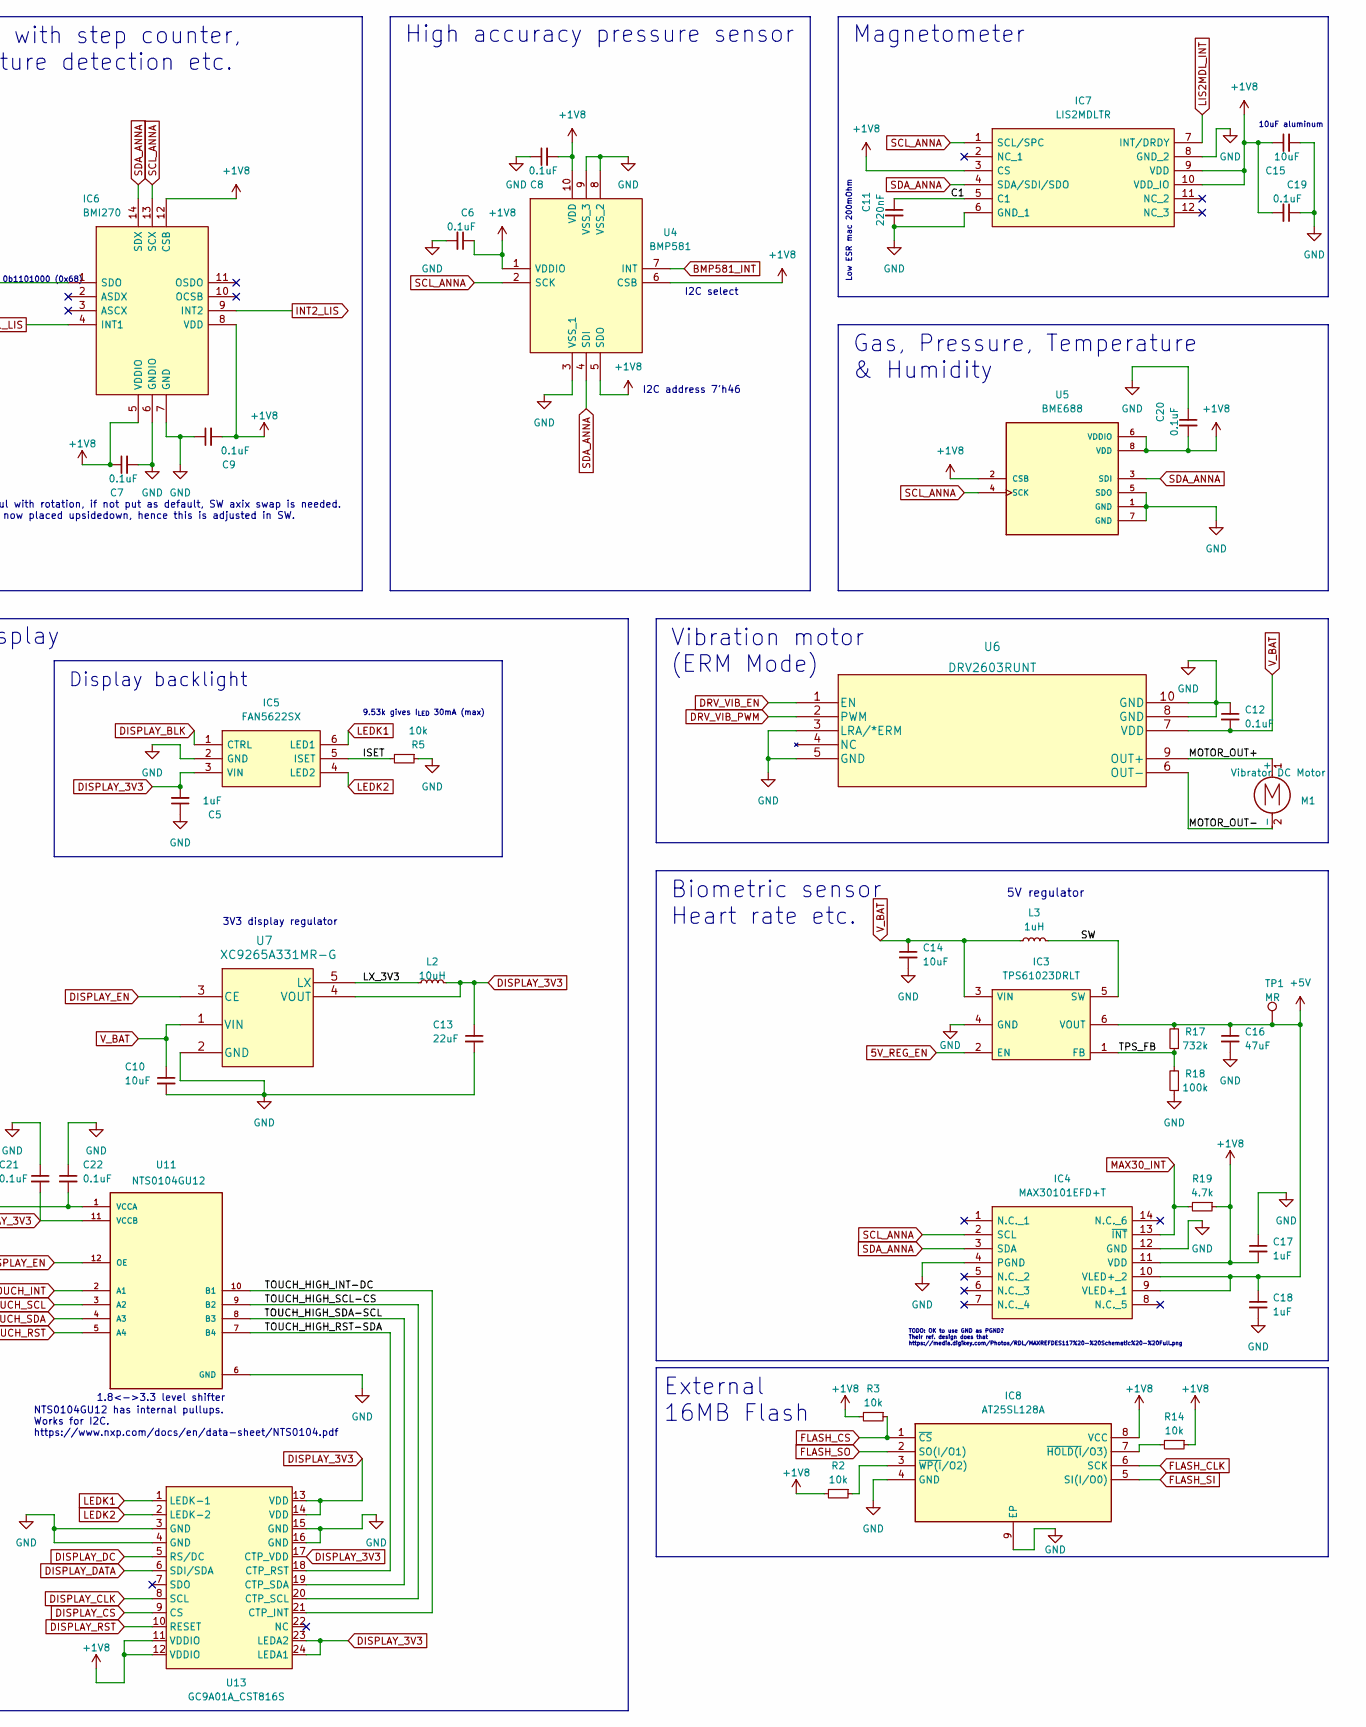
[picture p21: schematic ZSWatch.kicad_sch, ZSWatch v2, part in row 1, column 2]

Parts:
BT1: Battery pack; SolderWire-0.1sqmm_1x02_P3.6mm_D0.4mm_OD1mm
C1: 4.7uF; C_0603_1608Metric
C2: 2.2uF; C_0603_1608Metric
C3, C10, C14, C15: 10uF; C_0603_1608Metric
C4, C13: 22uF; C_0603_1608Metric
C5, C17, C18: 1uF; C_0603_1608Metric
C6, C7, C8, C9, C12, C19, C20, C21, C22: 0.1uF; C_0603_1608Metric
C11: 220nF; C_0603_1608Metric
C16: 47uF; C_0603_1608Metric
H1: MountingHole; MountingHole_3.5mm_Pad_Via
IC1: ESDALC6V1W5; SOT65P210X110-5L; Mouser Part Number 511-ESDALC6V1W5
IC2: XC9265C181MR-G; SOT95P280X130-5N; Mouser Part Number 865-XC9265C181MR-G
IC3: TPS61023DRLT; SOTFL50P160X60-6N; Mouser Part Number 595-TPS61023DRLT
IC4: MAX30101EFD+T; 14-LEAD-OESIP; Mouser Part Number 700-MAX30101EFD+T
IC5: FAN5622SX; SOT95P280X110-6N; Mouser Part Number 512-FAN5622SX
IC6: BMI270; QFN50P300X250X87-14N; Mouser Part Number 262-BMI270
IC7: LIS2MDLTR; LGA-12; Mouser Part Number 511-LIS2MDLTR
IC8: AT25SL128A; SON127P600X500X60-9N-D; Manufacturer_Part_Number 988-AT25SL128A-MHE-T; Mouser Part Number 988-AT25SL128A-MHE-T
J2: Charger and programming header (Placeholder); rtlecs-6-pin-2-54
L1, L2: 10uH; L_0603_1608Metric
L3: 1uH; L_0603_1608Metric
M1: Vibrator DC Motor; TestPoint_2Pads_Pitch2.54mm_Drill0.8mm
R1, R5, R14: 10k; R_0603_1608Metric
R2, R3: 10k; R_0402_1005Metric
R4, R8: 1M0; R_0603_1608Metric
R6: 1M5; R_0603_1608Metric
R7: 220k; R_0603_1608Metric
R9, R10, R19: 4.7k; R_0603_1608Metric
R11, R12, R13, R18: 100k; R_0603_1608Metric
R17: 732k; R_0603_1608Metric
S1, S2, S3, S4: SKRTLAE010; SW_SKRTLAE010; PARTREV --
TP1, TP9, TP10, TP11, TP12: MR; TestPoint_Pad_D1.0mm
TP3: BAT_MON; TestPoint_Pad_D1.0mm
TP8: 1V8; TestPoint_Pad_D1.0mm
U1: MAX1811ESA+; SOIC127P600X175-8N
U2: DMC2400UV-7
U3: NCV300LSN36T1G; SOT95P275X110-5N
U4: BMP581; Mouser Part Number 262-BMP581
U5: BME688; IC_BME688; PARTREV 1.0
U6: DRV2603RUNT
U7: XC9265A331MR-G; SOT95P280X130-5N
U10: 0_NORA-B106; NORA_LGA82R_1430X1040X180_ANT; MANUFACTURER P/N NORA-B106-00B
U11: NTS0104GU12; HPA01164RUTR; PARTREV 4210580/C 06/12
U13: GC9A01A_CST816S; ER-24F24-04

Connections:
5V_REG_EN: IC3.2 (EN), R13.1, U10.D1 (P0.15/QSPI[2])
+5V: C16.1, C18.1, IC3.6 (VOUT), IC4.9 (VLED+_1), IC4.10 (VLED+_2), R17.2, TP1.1
/C1: C11.1, IC7.5 (C1)
/D2: R6.1, U2.3 (D2)
/G2: R4.2, U2.5 (G2), U2.6 (D1)
/ISET: IC5.5 (ISET), R5.2
/LX_3V3: L2.1, U7.5 (LX)
/LX_18: IC2.5 (LX), L1.1
/MOTOR_OUT+: M1.1 (+), U6.9 (OUT+)
/MOTOR_OUT-: M1.2 (-), U6.6 (OUT-)
/SW: IC3.5 (SW), L3.2
/TOUCH_HIGH_INT-DC: U11.10 (B1), U13.21 (CTP_INT)
/TOUCH_HIGH_RST-SDA: U11.7 (B4), U13.18 (CTP_RST)
/TOUCH_HIGH_SCL-CS: U11.9 (B2), U13.20 (CTP_SCL)
/TOUCH_HIGH_SDA-SCL: U11.8 (B3), U13.19 (CTP_SDA)
/TPS_FB: IC3.1 (FB), R17.1, R18.2
/~RESET_BAT_SUP: IC2.3 (CE), U3.1 (~RESET_OUTPUT)
BAT_MON: R6.2, R7.1, TP3.1, U10.J8 (P0.28/AIN7)
BAT_MON_EN: R8.2, U2.2 (G1), U10.J7 (P1.10)
BMP581_INT: U4.7 (INT), U10.G3 (P0.25/AIN4)
BTN_1: S1.2, U10.H3 (P0.27/AIN6)
BTN_2: S2.2, U10.J9 (P0.31)
BTN_3: S3.2, U10.H9 (P1.11)
BTN_4: S4.2, U10.G1 (P1.06)
CHG: U1.8 (~CHG), U10.H8 (P0.30)
DISPLAY_3V3: C5.2, C13.1, C21.2, IC5.3 (VIN), L2.2, TP11.1, U7.4 (VOUT), U11.11 (VCCB), U13.13 (VDD), U13.14 (VDD), U13.17 (CTP_VDD), U13.23 (LEDA2), U13.24 (LEDA1)
DISPLAY_BLK: IC5.1 (CTRL), U10.E7 (P0.06/AIN2)
DISPLAY_CLK: U10.B1 (P0.08/TRACEDATA[3]), U13.8 (SCL)
DISPLAY_CS: U10.B3 (P0.11/TRACEDATA[0]), U13.9 (CS)
DISPLAY_DATA: U10.C2 (P0.09/TRACEDATA[2]), U13.6 (SDI/SDA)
DISPLAY_DC: U10.A2 (P0.12/TRACECLK), U13.5 (RS/DC)
DISPLAY_EN: R11.1, U7.3 (CE), U10.C4 (P1.01), U11.12 (OE)
DISPLAY_RST: U10.D7 (P0.23), U13.10 (RESET)
DRV_VIB_EN: R12.1, U6.1 (EN), U10.E9 (P1.05)
DRV_VIB_PWM: U6.2 (PWM), U10.F9 (P1.15)
FLASH_CLK: IC8.6 (SCK), U10.B6 (P0.01/XL2)
FLASH_SI: IC8.5 (SI(I/O0)), U10.C6 (P0.00/XL1)
FLASH_SO: IC8.2 (SO(I/O1)), U10.C1 (P0.10/TRACEDATA[1])
GND: BT1.2 (-), C1.2, C2.1, C3.2, C4.2, C5.1, C6.2, C7.2, C8.1, C9.1, C10.2, C11.2, C12.1, C13.2, C14.2, C15.2, C16.2, C17.1, C18.2, C19.1, C20.1, C21.1, C22.1, IC1.2 (GND), IC2.2 (GND), IC3.4 (GND), IC4.4 (PGND), IC4.12 (GND), IC5.2 (GND), IC6.1 (SDO), IC6.6 (GNDIO), IC6.7 (GND), IC7.6 (GND_1), IC7.8 (GND_2), IC8.4 (GND), IC8.9 (EP), J2.5, R1.2, R5.1, R7.2, R8.1, R11.2, R12.2, R13.2, R18.1, S1.1, S2.3, S3.3, S4.1, U1.2 (SELI), U1.3 (GND), U1.6 (GND), U2.1 (S1), U3.3 (GND), U4.3 (VSS_1), U4.8 (VSS_2), U4.9 (VSS_3), U5.1 (GND), U5.5 (SDO), U5.7 (GND), U6.3 (LRA/*ERM), U6.5 (GND), U6.8 (GND), U6.10 (GND), U7.2 (GND), U10.A1 (VSS), U10.A9 (VSS), U10.B2 (VSS), U10.B8 (VSS), U10.E4 (VSS), U10.E5 (VSS), U10.F4 (VSS), U10.F5 (VSS), U10.K2 (VSS), U10.K3 (VSS), U10.K5 (VSS), U10.K7 (VSS), U10.K8 (VSS), U10.L1 (VSS), U10.L9 (VSS), U10.M1 (VSS), U10.M2 (VSS), U10.M8 (VSS), U10.M9 (VSS), U11.6 (GND), U13.3 (GND), U13.4 (GND), U13.15 (GND), U13.16 (GND)
INT1_LIS: IC6.4 (INT1), U10.D3 (P0.07/AIN3)
INT2_LIS: IC6.9 (INT2), U10.E3 (P0.21)
LEDK1: IC5.6 (LED1), U13.1 (LEDK-1)
LEDK2: IC5.4 (LED2), U13.2 (LEDK-2)
LIS2MDL_INT: IC7.7 (INT/DRDY), U10.H1 (P0.24)
MAX30_INT: IC4.13 (~INT), R19.2, U10.C8 (P0.22)
unnamed: IC8.3 (~WP(I/O2)), R2.1
RESET_N: IC1.4 (I/03), J2.4, TP12.1, U10.J3 (~{RESET)
SCL_ANNA: IC4.2 (SCL), IC6.13 (SCX), IC7.1 (SCL/SPC), R9.1, TP9.1, U4.2 (SCK), U5.4 (SCK), U10.E1 (P0.18/QSPI_CS)
SDA_ANNA: IC4.3 (SDA), IC6.14 (SDX), IC7.4 (SDA/SDI/SDO), R10.1, TP10.1, U4.4 (SDI), U5.3 (SDI), U10.F1 (P0.17/QSPI_CLK)
SWDCLK: IC1.1 (I/01), J2.2, U10.J2 (SWDCLK)
SWDIO: IC1.3 (I/02), J2.3, U10.H2 (SWDIO)
TOUCH_INT: U10.A4 (P1.00), U11.2 (A1)
TOUCH_RST: U10.A5 (P0.20), U11.5 (A4)
TOUCH_SCL: U10.A3 (P1.03/I2C), U11.3 (A2)
TOUCH_SDA: U10.B4 (P1.02/I2C), U11.4 (A3)
UART_TX: IC1.5 (I/04), J2.1, U10.G9 (P1.13)
VBUS: C1.1, J2.6, R1.1, U1.1 (SELV), U1.4 (IN), U1.7 (EN)
V_BAT: BT1.1 (+), C2.2, C3.1, C10.1, C12.2, C14.1, IC2.1 (VIN), IC3.3 (VIN), L3.1, R4.1, U1.5 (BATT), U2.4 (S2), U3.2 (INPUT), U6.7 (VDD), U7.1 (VIN)

Notes on the sheet:
Test Points
Display backlight
Battery can do 500mA charging however it requires the source to deliver 500mA. USB hubs for example may only deliver 100mA. Not sure what will happen in that case if set charger to 500mA. Stay safe and use 100mA for now.
1.8<->3.3 level shifter
I2C select
Biometric sensor Heart rate etc.
Gas, Pressure, Temperature & Humidity
High accuracy pressure sensor
3V3 display regulator
Pull-up/down resistors
MOSFET P/N Pair
Power Management
SELI LOW => charge with 100mA SELV HIGH => charge to 4.2V
Battery supervisor
RESET goes LOW when V_BAT < 3.6V
I2C address 7'h46
Low ESR mac 200mOhm
_{I2C 0b1101000 (0x68)}
NTS0104GU12 has internal pullups. Works for I2C. https://www.nxp.com/docs/en/data-sheet/NTS0104.pdf
TODO: Can be removed?
Buttons
Microcontroller (NORA-B106/nRF5340)
TODO: OK to use GND as PGND? Their ref. design does that https://media.digikey.com/Photos/RDL/MAXREFDES117%20-%20Schematic%20-%20Full.png
Note, CHG is open-drain so open with internal pullup enabled
No strict requirement on bypass cap accoridng to SIM => save space
Power flags
9.53k gives I_{LED} 30mA (max)
Magnetometer
SWD pins will probably touch the skin, hence we need ESD protection. Those are not for 1.8V, but they will limit significatnly and then interna nRF chip ESD protection handles the rest(if I understand correctly).
Pull down all EN. Battery is connected directly to some of those ICs but since EN is pulled low and only set high by ANNA, they will be off when battery is low (NORA shut off).
Careful with rotation, if not put as default, SW axix swap is needed. Right now placed upsidedown, hence this is adjusted in SW.
IMU with step counter, gesture detection etc.
LIPO Charger
5V regulator
External 16MB Flash
ESD protection
Vibration motor (ERM Mode)
Mounting Holes
Display
10uF aluminum
1.8V regulator

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
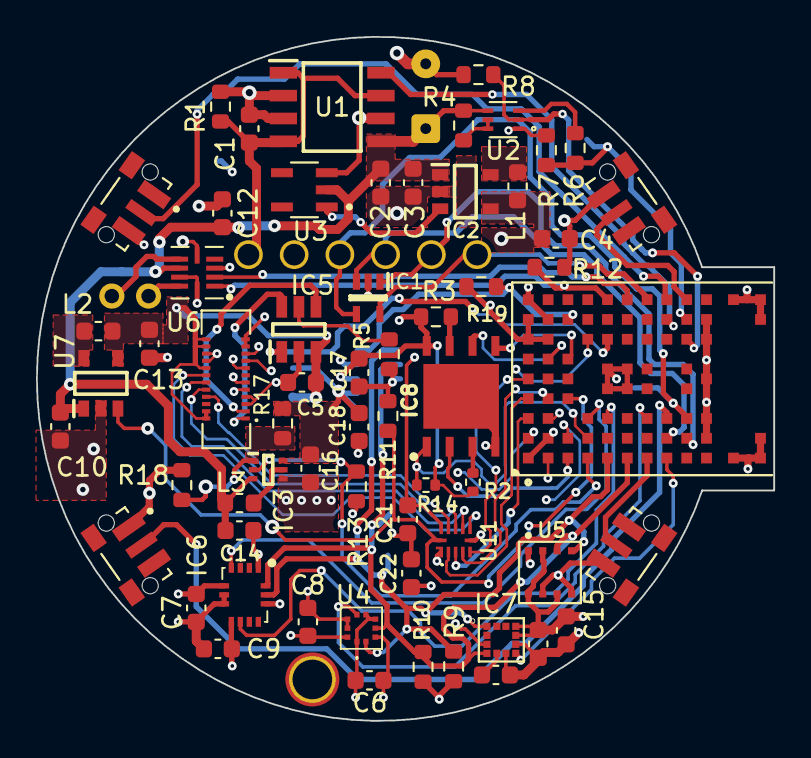
[picture p22: board ZSWatch.kicad_pcb from above]

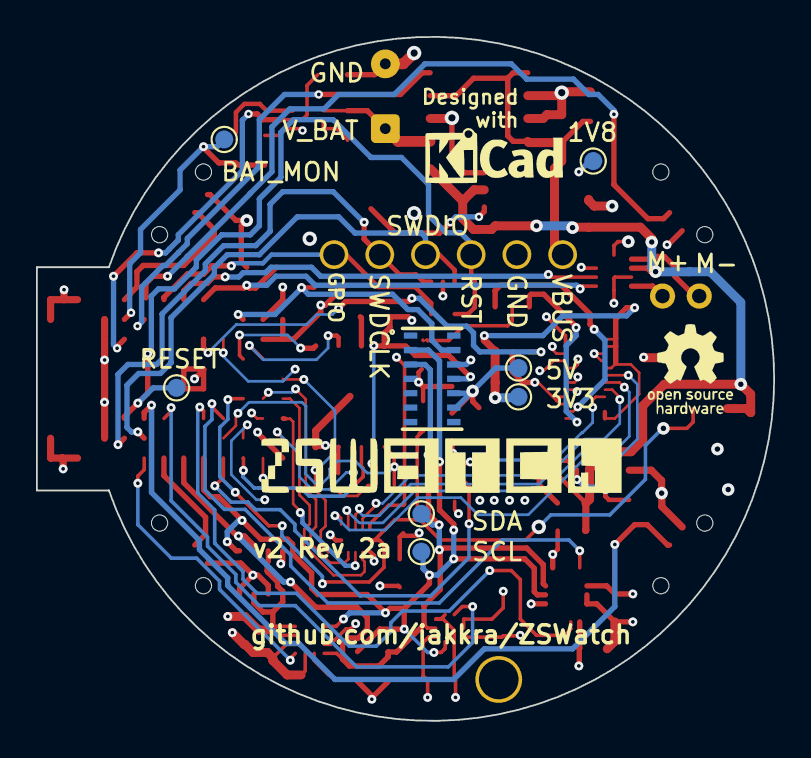
[picture p23: board ZSWatch.kicad_pcb from below]

Board: 4 copper layers, 41.0 x 38.0 mm, 74 parts (9 on the bottom side), 61 nets.
