jakkra/ZSWatch/ZSWatch-dock/dock.kicad_pcb

## KiCad design ZSWatch-dock/dock.kicad_pcb (2023-05-19, last stored version)

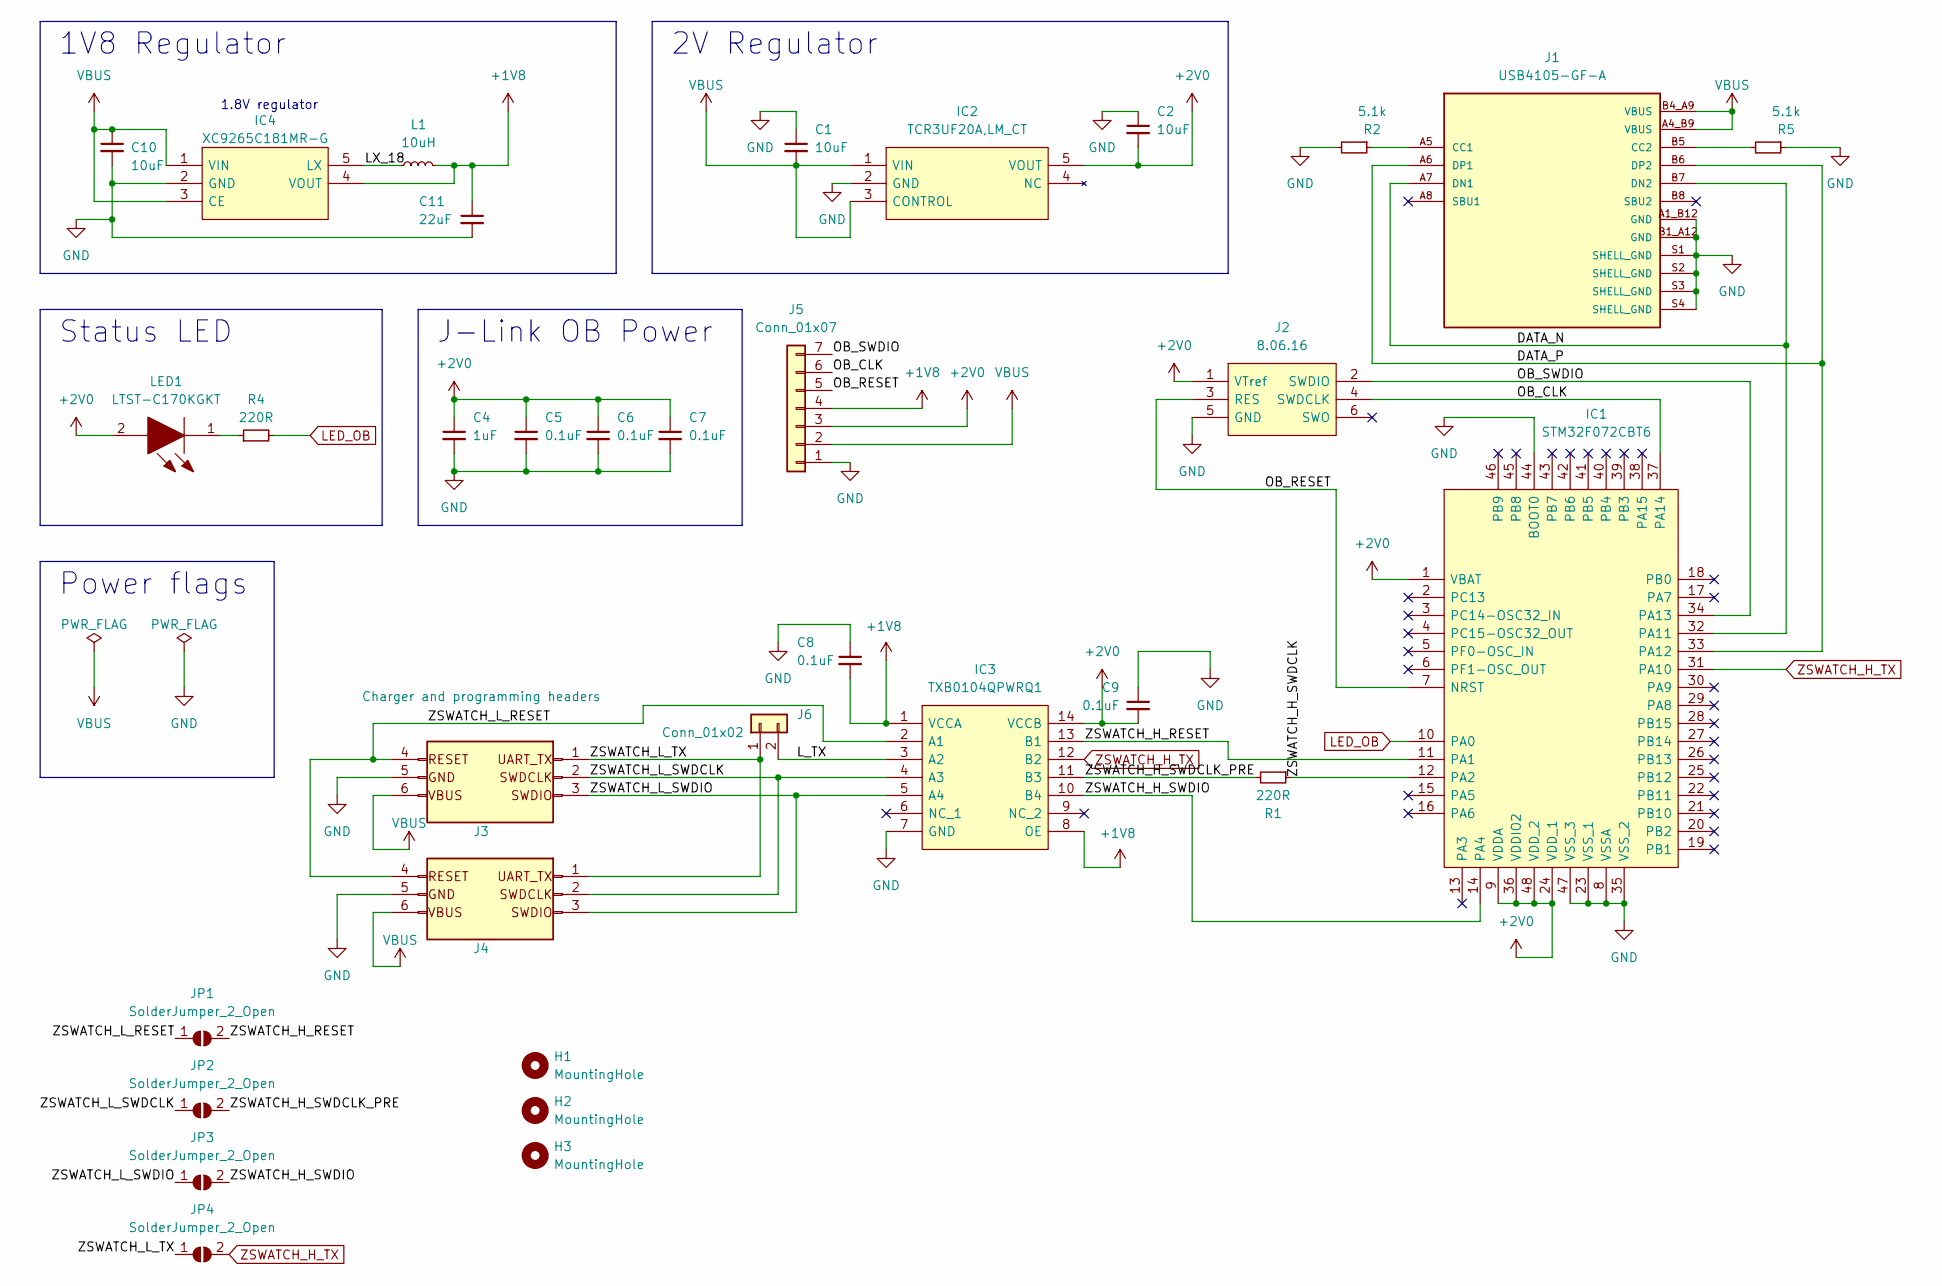
[picture p24: schematic dock.kicad_sch, ZSWatch Dock Programmer and Charger]

Parts:
C1, C2, C10: 10uF; C_0603_1608Metric
C4: 1uF; C_0603_1608Metric
C5, C6, C7, C8, C9: 0.1uF; C_0603_1608Metric
C11: 22uF; C_0603_1608Metric
H1, H2, H3: MountingHole; MountingHole_2.2mm_M2
IC1: STM32F072CBT6; QFP50P900X900X160-48N; Mouser Part Number 511-STM32F072CBT6
IC2: TCR3UF20A,LM_CT; TCR3UF20ALMCT; Mouser Part Number 757-TCR3UF20ALMCT
IC3: TXB0104QPWRQ1; SOP65P640X120-14N; Mouser Part Number 595-TXB0104QPWRQ1
IC4: XC9265C181MR-G; SOT95P280X130-5N; Mouser Part Number 865-XC9265C181MR-G
J1: USB4105-GF-A; GCT_USB4105-GF-A; PARTREV A3
J2: 8.06.16; 80616; Mouser Part Number 943-8.06.16
J3: Charger and programming headers; rtlecs-6-pin-2-54
J4: Charger and programming header; rtlecs-6-pin-2-54
J5: Conn_01x07; PinHeader_1x07_P2.54mm_Horizontal
J6: Conn_01x02; SolderJumper-2_P1.3mm_Bridged_Pad1.0x1.5mm
JP1, JP2, JP3, JP4: SolderJumper_2_Open; SolderJumper-2_P1.3mm_Open_RoundedPad1.0x1.5mm
L1: 10uH; L_0603_1608Metric
LED1: LTST-C170KGKT; LEDC2012X110N; Mouser Part Number 859-LTST-C170KGKT
R1, R4: 220R; R_0603_1608Metric
R2, R5: 5.1k; R_0603_1608Metric

Connections:
+1V8: C8.2, C11.1, IC3.1 (VCCA), IC3.8 (OE), IC4.4 (VOUT), J5.4, L1.2
+2V0: C2.2, C4.1, C5.1, C6.1, C7.1, C9.2, IC1.1 (VBAT), IC1.9 (VDDA), IC1.24 (VDD_1), IC1.36 (VDDIO2), IC1.48 (VDD_2), IC2.5 (VOUT), IC3.14 (VCCB), J2.1 (VTref), J5.3, LED1.2
/DATA_N: IC1.32 (PA11), J1.A7 (DN1), J1.B7 (DN2)
/DATA_P: IC1.33 (PA12), J1.A6 (DP1), J1.B6 (DP2)
/LX_18: IC4.5 (LX), L1.1
/L_TX: IC3.3 (A2), J6.2
/OB_CLK: IC1.37 (PA14), J2.4 (SWDCLK), J5.6
/OB_RESET: IC1.7 (NRST), J2.3 (RES), J5.5
/OB_SWDIO: IC1.34 (PA13), J2.2 (SWDIO), J5.7
/ZSWATCH_H_RESET: IC1.11 (PA1), IC3.13 (B1), JP1.2 (B)
/ZSWATCH_H_SWDCLK: IC1.12 (PA2), R1.1
/ZSWATCH_H_SWDCLK_PRE: IC3.11 (B3), JP2.2 (B), R1.2
/ZSWATCH_H_SWDIO: IC1.14 (PA4), IC3.10 (B4), JP3.2 (B)
/ZSWATCH_L_RESET: IC3.2 (A1), J3.4, J4.4, JP1.1 (A)
/ZSWATCH_L_SWDCLK: IC3.4 (A3), J3.2, J4.2, JP2.1 (A)
/ZSWATCH_L_SWDIO: IC3.5 (A4), J3.3, J4.3, JP3.1 (A)
/ZSWATCH_L_TX: J3.1, J4.1, J6.1, JP4.1 (A)
GND: C1.1, C2.1, C4.2, C5.2, C6.2, C7.2, C8.1, C9.1, C10.2, C11.2, IC1.8 (VSSA), IC1.23 (VSS_1), IC1.35 (VSS_2), IC1.44 (BOOT0), IC1.47 (VSS_3), IC2.2 (GND), IC3.7 (GND), IC4.2 (GND), J1.A1_B12 (GND), J1.B1_A12 (GND), J1.S1 (SHELL_GND), J1.S2 (SHELL_GND), J1.S3 (SHELL_GND), J1.S4 (SHELL_GND), J2.5 (GND), J3.5, J4.5, J5.1, R2.2, R5.1
LED_OB: IC1.10 (PA0), R4.2
unnamed: J1.A5 (CC1), R2.1
unnamed: J1.B5 (CC2), R5.2
unnamed: LED1.1, R4.1
VBUS: C1.2, C10.1, IC2.1 (VIN), IC2.3 (CONTROL), IC4.1 (VIN), IC4.3 (CE), J1.A4_B9 (VBUS), J1.B4_A9 (VBUS), J3.6, J4.6, J5.2
ZSWATCH_H_TX: IC1.31 (PA10), IC3.12 (B2), JP4.2 (B)

Notes on the sheet:
Status LED
1.8V regulator
1V8 Regulator
Power flags
J-Link OB Power
2V Regulator

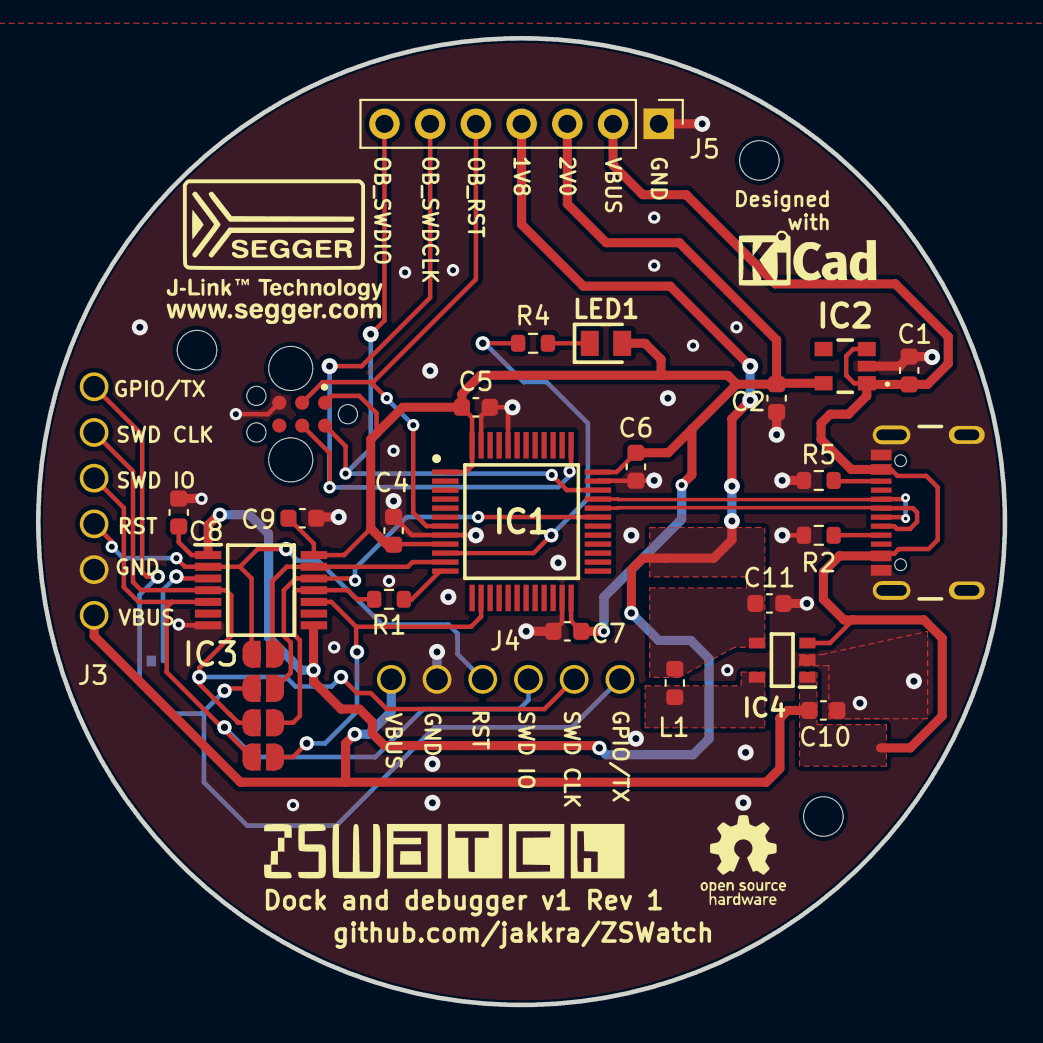
[picture p25: board dock.kicad_pcb from above]

Board: 2 copper layers, 53.7 x 53.7 mm, 33 parts (1 on the bottom side), 24 nets.
