jakkra/ZSWatch/ZSWatch-kicad-v2/zswatch-kicad.kicad_pro/zswatch-kicad.kicad_pro.kicad_pcb

## KiCad design ZSWatch-kicad-v2/zswatch-kicad.kicad_pro/zswatch-kicad.kicad_pro.kicad_pcb (2023-03-13, last stored version)

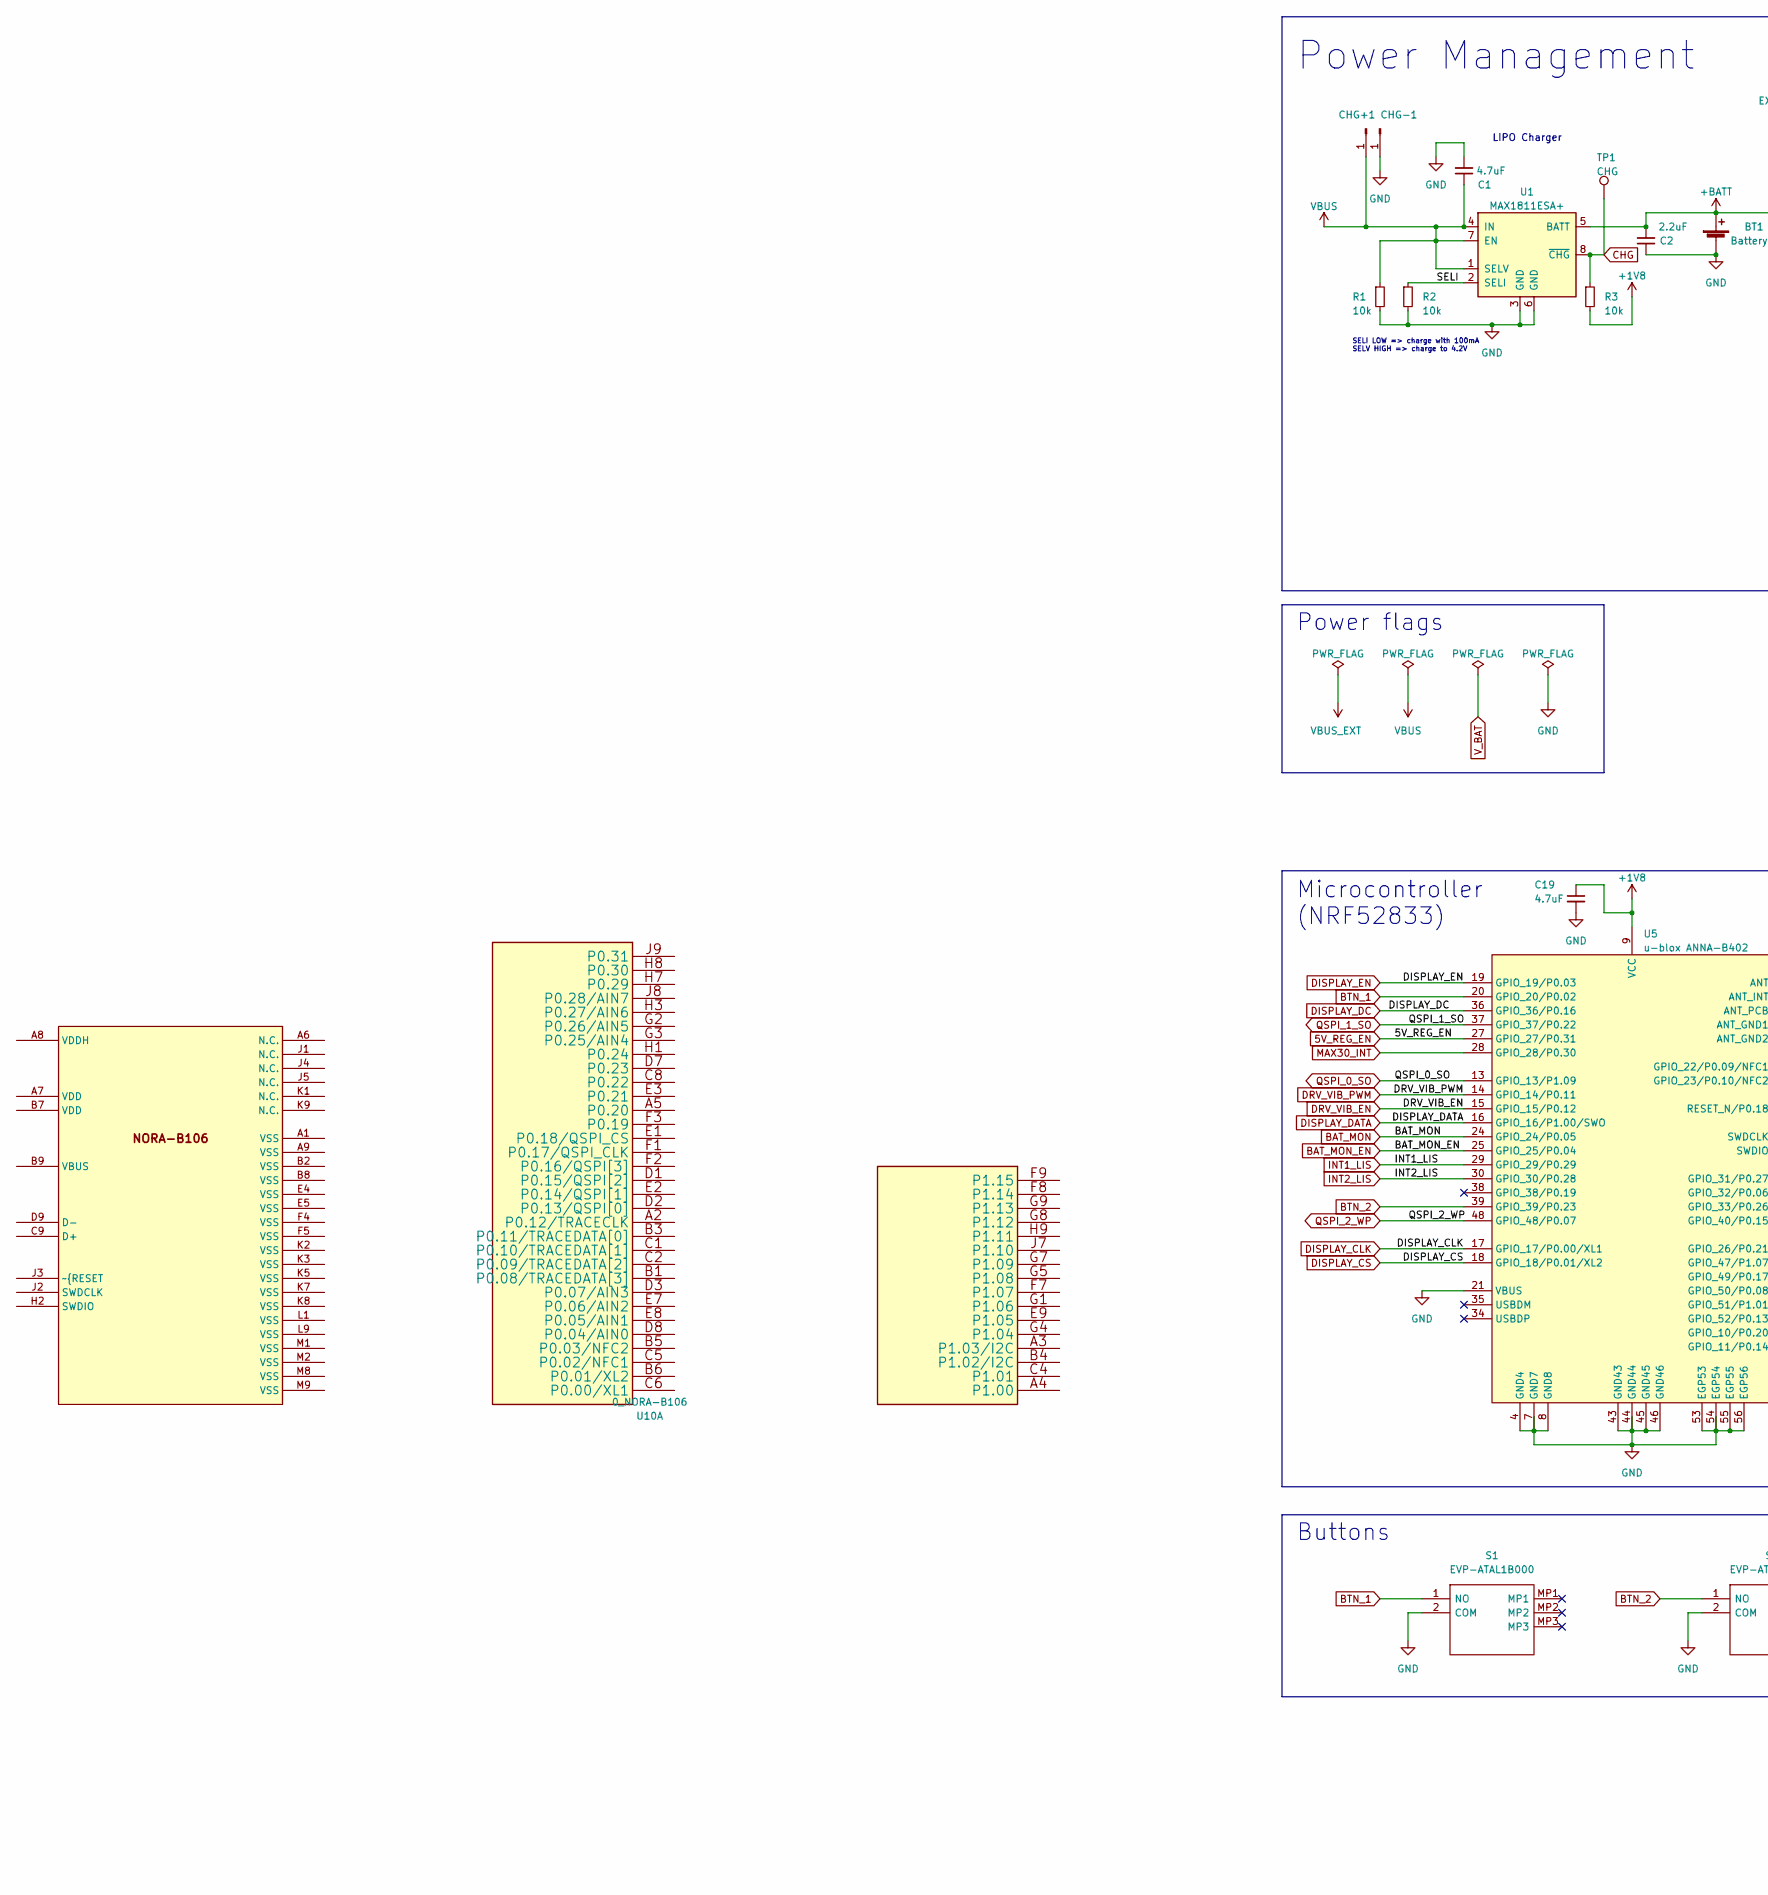
[picture p26: schematic zswatch-kicad.kicad_pro.kicad_sch, Smart Watch, part in row 1, column 1]

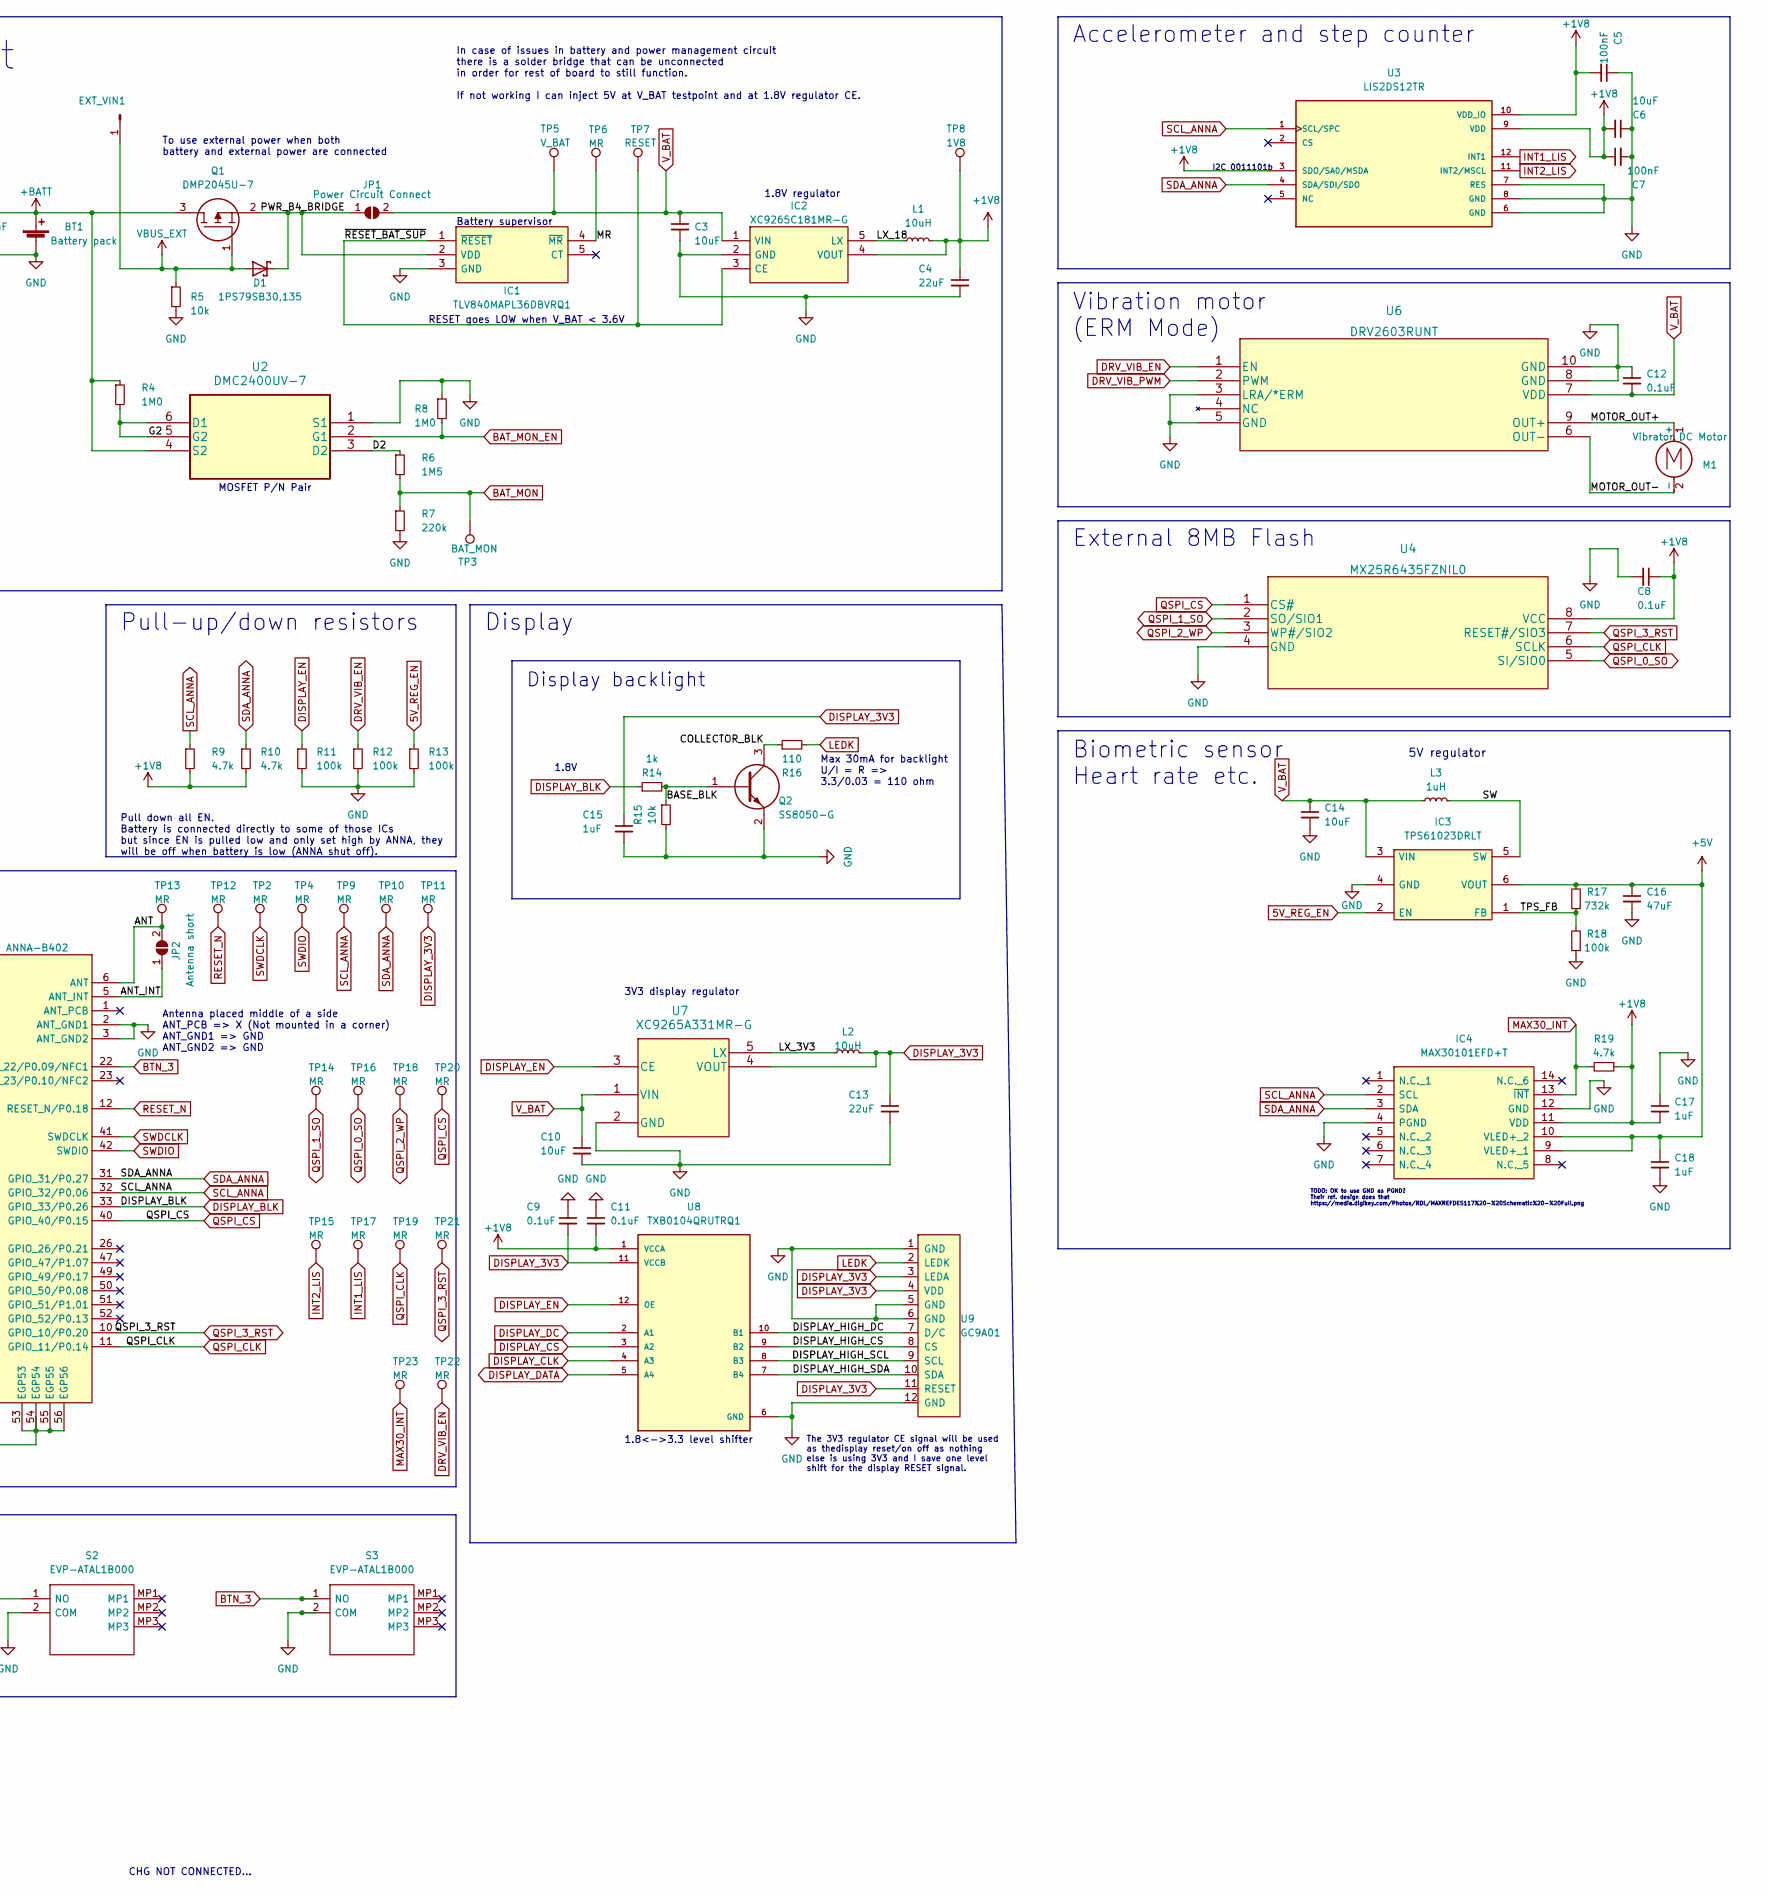
[picture p27: schematic zswatch-kicad.kicad_pro.kicad_sch, Smart Watch, part in row 1, column 2]

Parts:
BT1: Battery pack; SolderWire-0.1sqmm_1x02_P3.6mm_D0.4mm_OD1mm
C1, C19: 4.7uF; C_0603_1608Metric_Pad1.08x0.95mm_HandSolder
C2: 2.2uF; C_0603_1608Metric_Pad1.08x0.95mm_HandSolder
C3, C6, C10, C14: 10uF; C_0603_1608Metric_Pad1.08x0.95mm_HandSolder
C4, C13: 22uF; C_0603_1608Metric_Pad1.08x0.95mm_HandSolder
C5, C7: 100nF; C_0603_1608Metric_Pad1.08x0.95mm_HandSolder
C8, C9, C11, C12: 0.1uF; C_0603_1608Metric_Pad1.08x0.95mm_HandSolder
C15, C17, C18: 1uF; C_0603_1608Metric_Pad1.08x0.95mm_HandSolder
C16: 47uF; C_0603_1608Metric_Pad1.08x0.95mm_HandSolder
CHG+1: Conn_01x01_Male; TestPoint_THTPad_D1.0mm_Drill0.5mm
CHG-1: Conn_01x01_Male; TestPoint_THTPad_D1.0mm_Drill0.5mm
D1: 1PS79SB30,135; SOD523
EXT_VIN1: Conn_01x01_Male; TestPoint_Pad_D1.5mm
IC1: TLV840MAPL36DBVRQ1; SOT95P280X145-5N; Mouser Part Number 595-V840MAPL36DBVRQ1
IC2: XC9265C181MR-G; SOT95P280X130-5N; Mouser Part Number 865-XC9265C181MR-G
IC3: TPS61023DRLT; SOTFL50P160X60-6N; Mouser Part Number 595-TPS61023DRLT
IC4: MAX30101EFD+T; 14-LEAD-OESIP; Mouser Part Number 700-MAX30101EFD+T
JP1: Power Circuit Connect; SolderJumper-2_P1.3mm_Open_RoundedPad1.0x1.5mm
JP2: Antenna short; SolderJumper-2_P1.3mm_Open_Pad1.0x1.5mm
L1, L2: 10uH; L_0603_1608Metric_Pad1.05x0.95mm_HandSolder
L3: 1uH; L_0603_1608Metric_Pad1.05x0.95mm_HandSolder
M1: Vibrator DC Motor; TestPoint_2Pads_Pitch2.54mm_Drill0.8mm
Q1: DMP2045U-7; SOT96P240X110-3N; Mouser Part Number 621-DMP2045U-7
Q2: SS8050-G; SOT95P240X115-3N; Mouser Part Number 750-SS8050-G
R1, R2, R3, R5, R15: 10k; R_0603_1608Metric_Pad0.98x0.95mm_HandSolder
R4, R8: 1M0; R_0603_1608Metric_Pad0.98x0.95mm_HandSolder
R6: 1M5; R_0603_1608Metric_Pad0.98x0.95mm_HandSolder
R7: 220k; R_0603_1608Metric_Pad0.98x0.95mm_HandSolder
R9, R10, R19: 4.7k; R_0603_1608Metric_Pad0.98x0.95mm_HandSolder
R11, R12, R13, R18: 100k; R_0603_1608Metric_Pad0.98x0.95mm_HandSolder
R14: 1k; R_0603_1608Metric_Pad0.98x0.95mm_HandSolder
R16: 110; R_0603_1608Metric_Pad0.98x0.95mm_HandSolder
R17: 732k; R_0603_1608Metric_Pad0.98x0.95mm_HandSolder
S1, S2, S3: EVP-ATAL1B000; EVPATAL1B000; Mouser Part Number 667-EVP-ATAL1B000
TP1: CHG; TestPoint_Pad_D1.0mm
TP2, TP4, TP12: MR; TestPoint_THTPad_D1.0mm_Drill0.5mm
TP3: BAT_MON; TestPoint_Pad_D1.0mm
TP5: V_BAT; TestPoint_Pad_D1.0mm
TP6, TP9, TP10, TP11, TP13: MR; TestPoint_Pad_D1.0mm
TP7: RESET; TestPoint_Pad_D1.0mm
TP8: 1V8; TestPoint_THTPad_D1.0mm_Drill0.5mm
TP14, TP15, TP16, TP17, TP18, TP19, TP20, TP21, TP22, TP23: MR; TestPoint_Pad_D0.4mm
U1: MAX1811ESA+; SOIC127P600X175-8N
U2: DMC2400UV-7
U3: LIS2DS12TR
U4: MX25R6435FZNIL0
U5: u-blox ANNA-B402; ANNA-B402_altium_import
U6: DRV2603RUNT
U7: XC9265A331MR-G; SOT95P280X130-5N
U8: TXB0104QRUTRQ1; HPA01164RUTR; PARTREV 4210580/C 06/12
U9: GC9A01; GC9A01_disp
U10: 0_NORA-B106; NORA_LGA82R_1430X1040X180_ANT; MANUFACTURER P/N NORA-B106-00B

Connections:
5V_REG_EN: IC3.2 (EN), R13.1, U5.27 (GPIO_27/P0.31)
+1V8: C4.1, C5.2, C6.2, C7.1, C8.1, C11.2, C17.2, C19.1, IC2.4 (VOUT), IC4.11 (VDD), L1.2, R3.2, R9.2, R10.2, R19.1, TP8.1, U3.3 (SDO/SA0/MSDA), U3.9 (VDD), U3.10 (VDD_IO), U4.8 (VCC), U5.9 (VCC), U8.1 (VCCA)
+5V: C16.1, C18.1, IC3.6 (VOUT), IC4.9 (VLED+_1), IC4.10 (VLED+_2), R17.2
+BATT: BT1.1 (+), C2.2, Q1.3, R4.1, U1.5 (BATT), U2.4 (S2)
/ANT: JP2.2 (B), TP13.1, U5.6 (ANT)
/ANT_INT: JP2.1 (A), U5.5 (ANT_INT)
/BASE_BLK: Q2.1, R14.2, R15.1
/COLLECTOR_BLK: Q2.3, R16.1
/D2: R6.1, U2.3 (D2)
/DISPLAY_HIGH_CS: U8.9 (B2), U9.8 (CS)
/DISPLAY_HIGH_DC: U8.10 (B1), U9.7 (D/C)
/DISPLAY_HIGH_SCL: U8.8 (B3), U9.9 (SCL)
/DISPLAY_HIGH_SDA: U8.7 (B4), U9.10 (SDA)
/G2: R4.2, U2.5 (G2), U2.6 (D1)
/LX_3V3: L2.1, U7.5 (LX)
/LX_18: IC2.5 (LX), L1.1
/MOTOR_OUT+: M1.1 (+), U6.9 (OUT+)
/MOTOR_OUT-: M1.2 (-), U6.6 (OUT-)
/MR: IC1.4 (~MR), TP6.1
/PWR_B4_BRIDGE: D1.1, IC1.2 (VDD), JP1.1 (A), Q1.2
/SELI: R2.1, U1.2 (SELI)
/SW: IC3.5 (SW), L3.2
/TPS_FB: IC3.1 (FB), R17.1, R18.2
/~RESET_BAT_SUP: IC1.1 (~RESET), IC2.3 (CE), TP7.1
BAT_MON: R6.2, R7.1, TP3.1, U5.24 (GPIO_24/P0.05)
BAT_MON_EN: R8.2, U2.2 (G1), U5.25 (GPIO_25/P0.04)
BTN_1: S1.1 (NO), U5.20 (GPIO_20/P0.02)
BTN_2: S2.1 (NO), U5.39 (GPIO_39/P0.23)
BTN_3: S3.1 (NO), U5.22 (GPIO_22/P0.09/NFC1)
CHG: R3.1, TP1.1, U1.8 (~CHG)
DISPLAY_3V3: C9.2, C13.1, C15.1, L2.2, TP11.1, U7.4 (VOUT), U8.11 (VCCB), U9.3 (LEDA), U9.4 (VDD), U9.11 (RESET)
DISPLAY_BLK: R14.1, U5.33 (GPIO_33/P0.26)
DISPLAY_CLK: U5.17 (GPIO_17/P0.00/XL1), U8.4 (A3)
DISPLAY_CS: U5.18 (GPIO_18/P0.01/XL2), U8.3 (A2)
DISPLAY_DATA: U5.16 (GPIO_16/P1.00/SWO), U8.5 (A4)
DISPLAY_DC: U5.36 (GPIO_36/P0.16), U8.2 (A1)
DISPLAY_EN: R11.1, U5.19 (GPIO_19/P0.03), U7.3 (CE), U8.12 (OE)
DRV_VIB_EN: R12.1, TP22.1, U5.15 (GPIO_15/P0.12), U6.1 (EN)
DRV_VIB_PWM: U5.14 (GPIO_14/P0.11), U6.2 (PWM)
GND: BT1.2 (-), C1.2, C2.1, C3.2, C4.2, C5.1, C6.1, C7.2, C8.2, C9.1, C10.2, C11.1, C12.1, C13.2, C14.2, C15.2, C16.2, C17.1, C18.2, C19.2, CHG-1.1, IC1.3 (GND), IC2.2 (GND), IC3.4 (GND), IC4.4 (PGND), IC4.12 (GND), Q2.2, R1.2, R2.2, R5.2, R7.2, R8.1, R11.2, R12.2, R13.2, R15.2, R18.1, S1.2 (COM), S2.2 (COM), S3.2 (COM), U1.3 (GND), U1.6 (GND), U2.1 (S1), U3.6 (GND), U3.7 (RES), U3.8 (GND), U4.4 (GND), U5.2 (ANT_GND1), U5.3 (ANT_GND2), U5.4 (GND4), U5.7 (GND7), U5.8 (GND8), U5.21 (VBUS), U5.43 (GND43), U5.44 (GND44), U5.45 (GND45), U5.46 (GND46), U5.53 (EGP53), U5.54 (EGP54), U5.55 (EGP55), U5.56 (EGP56), U6.3 (LRA/*ERM), U6.5 (GND), U6.8 (GND), U6.10 (GND), U7.2 (GND), U8.6 (GND), U9.1 (GND), U9.5 (GND), U9.6 (GND), U9.12 (GND)
INT1_LIS: TP17.1, U3.12 (INT1), U5.29 (GPIO_29/P0.29)
INT2_LIS: TP15.1, U3.11 (INT2/MSCL), U5.30 (GPIO_30/P0.28)
LEDK: R16.2, U9.2 (LEDK)
MAX30_INT: IC4.13 (~INT), R19.2, TP23.1, U5.28 (GPIO_28/P0.30)
QSPI_0_SO: TP16.1, U4.5 (SI/SIO0), U5.13 (GPIO_13/P1.09)
QSPI_1_SO: TP14.1, U4.2 (SO/SIO1), U5.37 (GPIO_37/P0.22)
QSPI_2_WP: TP18.1, U4.3 (WP#/SIO2), U5.48 (GPIO_48/P0.07)
QSPI_3_RST: TP21.1, U4.7 (RESET#/SIO3), U5.10 (GPIO_10/P0.20)
QSPI_CLK: TP19.1, U4.6 (SCLK), U5.11 (GPIO_11/P0.14)
QSPI_CS: TP20.1, U4.1 (CS#), U5.40 (GPIO_40/P0.15)
RESET_N: TP12.1, U5.12 (RESET_N/P0.18)
SCL_ANNA: IC4.2 (SCL), R9.1, TP9.1, U3.1 (SCL/SPC), U5.32 (GPIO_32/P0.06)
SDA_ANNA: IC4.3 (SDA), R10.1, TP10.1, U3.4 (SDA/SDI/SDO), U5.31 (GPIO_31/P0.27)
SWDCLK: TP2.1, U5.41 (SWDCLK)
SWDIO: TP4.1, U5.42 (SWDIO)
VBUS: C1.1, CHG+1.1, R1.1, U1.1 (SELV), U1.4 (IN), U1.7 (EN)
VDDA: D1.2, EXT_VIN1.1, Q1.1, R5.1
V_BAT: C3.1, C10.1, C12.2, C14.1, IC2.1 (VIN), IC3.3 (VIN), JP1.2 (B), L3.1, TP5.1, U6.7 (VDD), U7.1 (VIN)

Notes on the sheet:
Display backlight
Biometric sensor Heart rate etc.
Antenna placed middle of a side ANT_PCB => X (Not mounted in a corner) ANT_GND1 => GND ANT_GND2 => GND
Microcontroller (NRF52833)
3V3 display regulator
Pull-up/down resistors
MOSFET P/N Pair
Power Management
SELI LOW => charge with 100mA SELV HIGH => charge to 4.2V
Battery supervisor
RESET goes LOW when V_BAT < 3.6V
CHG NOT CONNECTED...
Buttons
TODO: OK to use GND as PGND? Their ref. design does that https://media.digikey.com/Photos/RDL/MAXREFDES117%20-%20Schematic%20-%20Full.png
Max 30mA for backlight U/I = R => 3.3/0.03 = 110 ohm
In case of issues in battery and power management circuit there is a solder bridge that can be unconnected in order for rest of board to still function. If not working I can inject 5V at V_BAT testpoint and at 1.8V regulator CE.
Power flags
To use external power when both battery and external power are connected
External 8MB Flash
Pull down all EN. Battery is connected directly to some of those ICs but since EN is pulled low and only set high by ANNA, they will be off when battery is low (ANNA shut off).
Accelerometer and step counter
LIPO Charger
_{I2C 0011101b}
5V regulator
1.8<->3.3 level shifter
The 3V3 regulator CE signal will be used as thedisplay reset/on off as nothing else is using 3V3 and I save one level shift for the display RESET signal.
Vibration motor (ERM Mode)
Display
1.8V regulator
1.8V

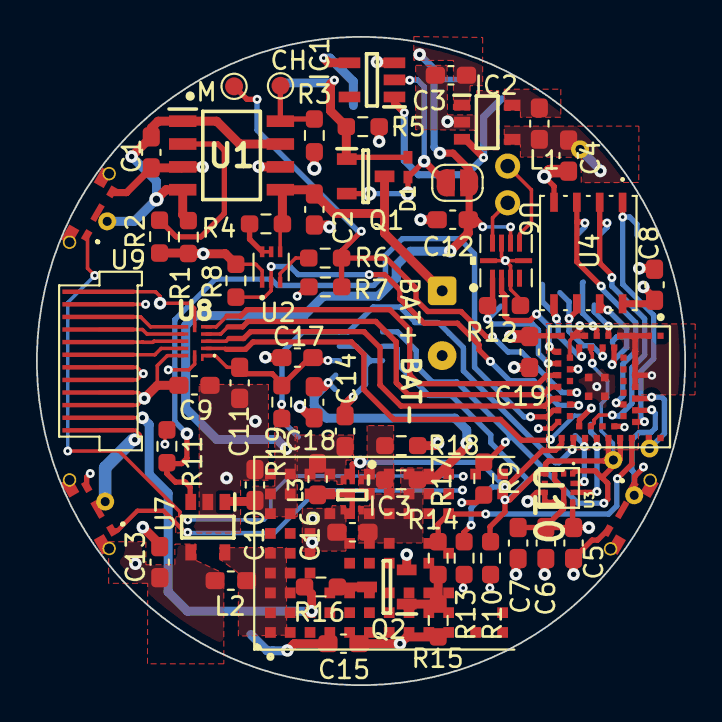
[picture p28: board zswatch-kicad.kicad_pro.kicad_pcb from above]

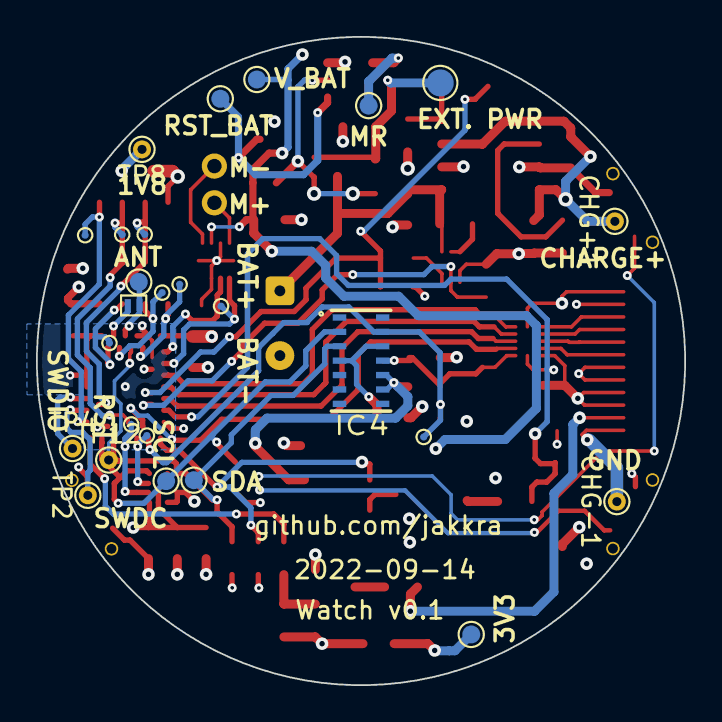
[picture p29: board zswatch-kicad.kicad_pro.kicad_pcb from below]

Board: 4 copper layers, 36.0 x 36.0 mm, 91 parts (26 on the bottom side), 58 nets.
