jakkra/ZSWatch/app/src/pressure_sensor.h

#ifndef PRESSURE_SENSOR_H_
#define PRESSURE_SENSOR_H_

#include <zephyr/drivers/sensor.h>
#include <bmp5_defs.h>

typedef struct pressure_data_evt_t {
    uint32_t    pressure;
    uint32_t    temp;
} pressure_data_evt_t;

typedef enum bmp5_odr_t {
    PRESSURE_SENSOR_ODR_240_HZ = BMP5_ODR_240_HZ,
    PRESSURE_SENSOR_ODR_218_5_HZ = BMP5_ODR_218_5_HZ,
    PRESSURE_SENSOR_ODR_199_1_HZ = BMP5_ODR_199_1_HZ,
    PRESSURE_SENSOR_ODR_179_2_HZ = BMP5_ODR_179_2_HZ,
    PRESSURE_SENSOR_ODR_160_HZ = BMP5_ODR_160_HZ,
    PRESSURE_SENSOR_ODR_149_3_HZ = BMP5_ODR_149_3_HZ,
    PRESSURE_SENSOR_ODR_140_HZ = BMP5_ODR_140_HZ,
    PRESSURE_SENSOR_ODR_129_8_HZ = BMP5_ODR_129_8_HZ,
    PRESSURE_SENSOR_ODR_120_HZ = BMP5_ODR_120_HZ,
    PRESSURE_SENSOR_ODR_110_1_HZ = BMP5_ODR_110_1_HZ,
    PRESSURE_SENSOR_ODR_100_2_HZ = BMP5_ODR_100_2_HZ,
    PRESSURE_SENSOR_ODR_89_6_HZ = BMP5_ODR_89_6_HZ,
    PRESSURE_SENSOR_ODR_80_HZ = BMP5_ODR_80_HZ,
    PRESSURE_SENSOR_ODR_70_HZ = BMP5_ODR_70_HZ,
    PRESSURE_SENSOR_ODR_60_HZ = BMP5_ODR_60_HZ,
    PRESSURE_SENSOR_ODR_50_HZ = BMP5_ODR_50_HZ,
    PRESSURE_SENSOR_ODR_45_HZ = BMP5_ODR_45_HZ,
    PRESSURE_SENSOR_ODR_40_HZ = BMP5_ODR_40_HZ,
    PRESSURE_SENSOR_ODR_35_HZ = BMP5_ODR_35_HZ,
    PRESSURE_SENSOR_ODR_30_HZ = BMP5_ODR_30_HZ,
    PRESSURE_SENSOR_ODR_25_HZ = BMP5_ODR_25_HZ,
    PRESSURE_SENSOR_ODR_20_HZ = BMP5_ODR_20_HZ,
    PRESSURE_SENSOR_ODR_15_HZ = BMP5_ODR_15_HZ,
    PRESSURE_SENSOR_ODR_10_HZ = BMP5_ODR_10_HZ,
    PRESSURE_SENSOR_ODR_05_HZ = BMP5_ODR_05_HZ,
    PRESSURE_SENSOR_ODR_04_HZ = BMP5_ODR_04_HZ,
    PRESSURE_SENSOR_ODR_03_HZ = BMP5_ODR_03_HZ,
    PRESSURE_SENSOR_ODR_02_HZ = BMP5_ODR_02_HZ,
    PRESSURE_SENSOR_ODR_01_HZ = BMP5_ODR_01_HZ,
    PRESSURE_SENSOR_ODR_0_5_HZ = BMP5_ODR_0_5_HZ,
    PRESSURE_SENSOR_ODR_0_250_HZ = BMP5_ODR_0_250_HZ,
    PRESSURE_SENSOR_ODR_0_125_HZ = BMP5_ODR_0_125_HZ,
    PRESSURE_SENSOR_ODR_DEFAULT
} bmp5_odr_t;

int pressure_sensor_init(void);

int pressure_sensor_set_odr(uint8_t bmp5_odr);

int pressure_sensor_fetch_pressure(float *pressure, float *temperature);

#endif
