jakkra/ZSWatch/app/drivers/sensor/apds9306/apds9306.c

/* apds9306.c - Driver for Avago APDS9306 light sensor. */

/*
 * Copyright (c) 2023, Daniel Kampert
 *
 * SPDX-License-Identifier: Apache-2.0
 */

#include <zephyr/device.h>
#include <zephyr/devicetree.h>
#include <zephyr/drivers/i2c.h>
#include <zephyr/drivers/gpio.h>
#include <zephyr/pm/device.h>
#include <zephyr/pm/device_runtime.h>
#include <zephyr/logging/log.h>
#include <zephyr/sys/byteorder.h>

#include "apds9306.h"

#define APDS9306_REGISTER_MAIN_CTRL         0x00
#define APDS9306_REGISTER_ALS_MEAS_RATE     0x04
#define APDS9306_REGISTER_ALS_GAIN          0x05
#define APDS9306_REGISTER_PART_ID           0x06
#define APDS9306_REGISTER_MAIN_STATUS       0x07
#define APDS9306_REGISTER_CLEAR_DATA_0      0x0A
#define APDS9306_REGISTER_CLEAR_DATA_1      0x0B
#define APDS9306_REGISTER_CLEAR_DATA_2      0x0C
#define APDS9306_REGISTER_ALS_DATA_0        0x0D
#define APDS9306_REGISTER_ALS_DATA_1        0x0E
#define APDS9306_REGISTER_ALS_DATA_2        0x0F
#define APDS9306_REGISTER_INT_CFG           0x19
#define APDS9306_REGISTER_INT_PERSISTENCE   0x1A
#define APDS9306_REGISTER_ALS_THRES_UP_0    0x21
#define APDS9306_REGISTER_ALS_THRES_UP_1    0x22
#define APDS9306_REGISTER_ALS_THRES_UP_2    0x23
#define APDS9306_REGISTER_ALS_THRES_LOW_0   0x24
#define APDS9306_REGISTER_ALS_THRES_LOW_1   0x25
#define APDS9306_REGISTER_ALS_THRES_LOW_2   0x26
#define APDS9306_REGISTER_ALS_THRES_VAR     0x27

#define ADPS9306_BIT_ALS_EN                 BIT(0x01)
#define ADPS9306_BIT_ALS_DATA_STATUS        BIT(0x03)
#define APDS9306_BIT_SW_RESET               BIT(0x04)
#define ADPS9306_BIT_ALS_INTERRUPT_STATUS   BIT(0x03)
#define APDS9306_BIT_POWER_ON_STATUS        BIT(0x05)

#ifdef CONFIG_APDS9306_IS_APDS9306_065
#define APDS_9306_CHIP_ID               0xB3
#else
#define APDS_9306_CHIP_ID               0xB1
#endif

LOG_MODULE_REGISTER(apds9306, CONFIG_SENSOR_LOG_LEVEL);

#if(DT_NUM_INST_STATUS_OKAY(DT_DRV_COMPAT) == 0)
#warning "apds9306 driver enabled without any devices"
#endif

static void apds9306_worker(struct k_work *p_work);

K_WORK_DEFINE(apds9306_work, apds9306_worker);

struct apds9306_data {
    uint32_t light;
};

struct apds9306_config {
    struct i2c_dt_spec i2c;
};

struct sensor_worker_item_t {
    struct k_work work;
    const struct device *dev;
} apds9306_worker_item;

uint32_t apds9306_last_measurement;

/** @brief          Get the conversion time for a given sensor resolution.
 *  @param value    Sensor resolution
 *  @return         Conversion time in ms
*/
static uint32_t apds9306_get_time_for_resolution(uint8_t value)
{
    switch (value) {
        case APDS9306_RES_20:
            return 400;
        case APDS9306_RES_19:
            return 200.0;
        case APDS9306_RES_18:
            return 100.0;
        case APDS9306_RES_17:
            return 50.0;
        case APDS9306_RES_16:
            return 25.0;
        case APDS9306_RES_13:
            return 4;
        default:
            return 100.0;
    }
}

/** @brief          Enable the ALS measurement.
 *  @param p_dev    Pointer to sensor device
 *  @return         0 when successful
*/
static int apds9306_enable(const struct device *p_dev)
{
    const struct apds9306_config *config = p_dev->config;

    return i2c_reg_update_byte_dt(&config->i2c, APDS9306_REGISTER_MAIN_CTRL, ADPS9306_BIT_ALS_EN, ADPS9306_BIT_ALS_EN);
}

/** @brief          Disable the ALS measurement.
 *  @param p_dev    Pointer to sensor device
 *  @return         0 when successful
*/
static int apds9306_standby(const struct device *p_dev)
{
    const struct apds9306_config *config = p_dev->config;

    return i2c_reg_update_byte_dt(&config->i2c, APDS9306_REGISTER_MAIN_CTRL, ADPS9306_BIT_ALS_EN, 0x00);
}

/** @brief
 *  @param
 *  @return
*/
static int apds9306_attr_set(const struct device *p_dev, enum sensor_channel channel, enum sensor_attribute attribute,
                             const struct sensor_value *p_value)
{
    uint8_t mask;
    uint8_t value;
    uint8_t reg;
    const struct apds9306_config *config = p_dev->config;

    __ASSERT_NO_MSG(p_value != NULL);

    if (channel != SENSOR_CHAN_LIGHT) {
        return -ENOTSUP;
    }

    if (attribute == SENSOR_ATTR_SAMPLING_FREQUENCY) {
        reg = APDS9306_REGISTER_ALS_MEAS_RATE;
        mask = (0x07) << 0x00;
        value = p_value->val1 & 0x07;
    } else if (attribute == SENSOR_APDS9306_ATTR_GAIN) {
        reg = APDS9306_REGISTER_ALS_GAIN;
        mask = (0x07) << 0x00;
        value = p_value->val1 & 0x07;
    } else if (attribute == SENSOR_APDS9306_ATTR_RESOLUTION) {
        reg = APDS9306_REGISTER_ALS_MEAS_RATE;
        mask = (0x07) << 0x04;
        value = (p_value->val1 & 0x07) << 0x04;
    } else {
        return -ENOTSUP;
    }

    if (i2c_reg_update_byte_dt(&config->i2c, reg, mask, value)) {
        LOG_ERR("Failed to set sensor attribute!");
        return -EIO;
    }

    return 0;
}

/** @brief          Sensor worker handler.
 *  @param p_work   Pointer to worker object
*/
static void apds9306_worker(struct k_work *p_work)
{
    int error;
    uint8_t buffer[3];
    uint8_t reg;
    uint8_t resolution;
    uint16_t delay;
    uint32_t now;
    struct sensor_worker_item_t *item = CONTAINER_OF(p_work, struct sensor_worker_item_t, work);
    const struct apds9306_config *config = item->dev->config;

    LOG_DBG("Start a new measurement...");
    if (apds9306_enable(item->dev) != 0) {
        LOG_ERR("Can not enable ALS!");
        return;
    }

    // Get the measurement resolution.
    if (i2c_reg_read_byte_dt(&config->i2c, APDS9306_REGISTER_ALS_MEAS_RATE, &buffer[0])) {
        LOG_ERR("Failed reading resolution");
        return;
    }

    // Convert the resolution into a delay time and wait for the result.
    resolution = (buffer[0] >> 4) & 0x07;
    delay = apds9306_get_time_for_resolution(resolution);
    LOG_DBG("Measurement resolution: %u", resolution);
    LOG_DBG("Wait for %u ms", delay);
    k_msleep(delay);

    // Wait for the end of the measurement.
    now = k_uptime_get_32();
    do {
        if (i2c_reg_read_byte_dt(&config->i2c, APDS9306_REGISTER_MAIN_STATUS, &buffer[0])) {
            LOG_ERR("Failed to read ALS status!");
            return;
        }

        // We wait 100 ms maximum for the device to become ready.
        if ((k_uptime_get_32() - now) > 500) {
            LOG_ERR("Sensor timeout!");
            return;
        }

        k_msleep(10);
    } while (!(buffer[0] & ADPS9306_BIT_ALS_DATA_STATUS));

    if (apds9306_standby(item->dev) != 0) {
        LOG_ERR("Can not disable ALS!");
        return;
    }

    // Read the results.
    reg = APDS9306_REGISTER_ALS_DATA_0;
    error = i2c_write_read_dt(&config->i2c, &reg, sizeof(reg), &buffer, sizeof(buffer));
    if (error < 0) {
        return;
    }

    apds9306_last_measurement = sys_get_le24(buffer);

    LOG_DBG("Last measurement: %u", apds9306_last_measurement);

    return;
}

/** @brief
 *  @param
 *  @return
*/
static int apds9306_attr_get(const struct device *p_dev, enum sensor_channel channel, enum sensor_attribute attribute,
                             struct sensor_value *p_value)
{
    uint8_t mask;
    uint8_t value;
    uint8_t reg;
    const struct apds9306_config *config = p_dev->config;

    __ASSERT_NO_MSG(p_value != NULL);

    if (channel != SENSOR_CHAN_LIGHT) {
        return -ENOTSUP;
    }

    if (attribute == SENSOR_ATTR_SAMPLING_FREQUENCY) {
        reg = APDS9306_REGISTER_ALS_MEAS_RATE;
        mask = 0x00;
    } else if (attribute == SENSOR_APDS9306_ATTR_GAIN) {
        reg = APDS9306_REGISTER_ALS_GAIN;
        mask = 0x00;
    } else if (attribute == SENSOR_APDS9306_ATTR_RESOLUTION) {
        reg = APDS9306_REGISTER_ALS_MEAS_RATE;
        mask = 0x04;
    } else {
        return -ENOTSUP;
    }

    if (i2c_reg_read_byte_dt(&config->i2c, reg, &value)) {
        LOG_ERR("Failed to read sensor attribute!");
        return -EIO;
    }

    LOG_DBG("Attribute value: %u", value);

    p_value->val1 = (value >> mask) & 0x07;
    p_value->val2 = 0;

    return 0;
}

/** @brief
 *  @param
 *  @return
*/
static int apds9306_sample_fetch(const struct device *p_dev, enum sensor_channel channel)
{
    enum pm_device_state pm_state;

    pm_device_state_get(p_dev, &pm_state);
    if (pm_state != PM_DEVICE_STATE_ACTIVE) {
        return -EIO;
    }

    if ((channel != SENSOR_CHAN_ALL) && (channel != SENSOR_CHAN_LIGHT)) {
        return -ENOTSUP;
    }

    apds9306_worker_item.dev = p_dev;
    apds9306_worker_item.work = apds9306_work;
    k_work_submit(&apds9306_worker_item.work);

    return 0;
}

/** @brief
 *  @param
 *  @return
*/
static int apds9306_channel_get(const struct device *p_dev, enum sensor_channel channel, struct sensor_value *p_value)
{
    if (channel != SENSOR_CHAN_LIGHT) {
        return -ENOTSUP;
    }

    // TODO: Conversion to lux is missing here

    p_value->val1 = apds9306_last_measurement;
    p_value->val2 = 0;

    return 0;
}

/** @brief
 *  @param
 *  @return
*/
static int apds9306_sensor_setup(const struct device *p_dev)
{
    uint32_t now;
    uint8_t temp;
    const struct apds9306_config *config = p_dev->config;

    // Wait for the device to become ready after a power cycle.
    now = k_uptime_get_32();
    do {
        i2c_reg_read_byte_dt(&config->i2c, APDS9306_REGISTER_MAIN_STATUS, &temp);

        // We wait 100 ms maximum for the device to become ready.
        if ((k_uptime_get_32() - now) > 100) {
            LOG_ERR("Sensor timeout!");
            return -EIO;
        }

        k_msleep(10);
    } while (temp & APDS9306_BIT_POWER_ON_STATUS);

    if (i2c_reg_read_byte_dt(&config->i2c, APDS9306_REGISTER_PART_ID, &temp)) {
        LOG_ERR("Failed reading chip id!");
        return -EIO;
    }

    if (temp != APDS_9306_CHIP_ID) {
        LOG_ERR("Invalid chip id! Found 0x%X, expect 0x%X", temp, APDS_9306_CHIP_ID);
        return -EIO;
    }

    // Reset the sensor.
    if (i2c_reg_write_byte_dt(&config->i2c, APDS9306_REGISTER_MAIN_CTRL, APDS9306_BIT_SW_RESET)) {
        LOG_ERR("Can not reset the sensor!");
        return -EIO;
    }
    k_msleep(10);

    return 0;
}

static const struct sensor_driver_api apds9306_driver_api = {
    .attr_set = apds9306_attr_set,
    .attr_get = apds9306_attr_get,
    .sample_fetch = apds9306_sample_fetch,
    .channel_get = apds9306_channel_get,
};

/** @brief
 *  @param
 *  @return
*/
static int apds9306_init(const struct device *p_dev)
{
    const struct apds9306_config *config = p_dev->config;

    LOG_DBG("Start to initialize APDS9306...");

    if (device_is_ready(config->i2c.bus) == false) {
        LOG_ERR("Bus device is not ready");
        return -EINVAL;
    }

    if (apds9306_sensor_setup(p_dev) < 0) {
        LOG_ERR("Failed to setup device!");
        return -EIO;
    }

    LOG_DBG("APDS9306 initialization successful!");

    return 0;
}

#ifdef CONFIG_PM_DEVICE
static int apds9306_pm_action(const struct device *p_dev, enum pm_device_action action)
{
    switch (action) {
        case PM_DEVICE_ACTION_SUSPEND:
        case PM_DEVICE_ACTION_RESUME:
        case PM_DEVICE_ACTION_TURN_OFF:
        case PM_DEVICE_ACTION_TURN_ON: {
            break;
        }
        default: {
            return -ENOTSUP;
        }
    }

    return 0;
}
#endif

#define APDS9306_INIT(inst)                                             \
    static struct apds9306_data apds9306_data_##inst;                   \
                                                                        \
    static const struct apds9306_config apds9306_config_##inst = {      \
        .i2c = I2C_DT_SPEC_INST_GET(inst),                              \
    };                                                                  \
                                                                        \
    PM_DEVICE_DT_INST_DEFINE(inst, apds9306_pm_action);                 \
                                                                        \
    SENSOR_DEVICE_DT_INST_DEFINE(inst, apds9306_init,                   \
                  PM_DEVICE_DT_INST_GET(inst),                          \
                  &apds9306_data_##inst,                                \
                  &apds9306_config_##inst, POST_KERNEL,                 \
                  CONFIG_SENSOR_INIT_PRIORITY,                          \
                  &apds9306_driver_api);

DT_INST_FOREACH_STATUS_OKAY(APDS9306_INIT)
