jakkra/ZSWatch/app/src/zsw_power_manager.c

/*
 * This file is part of ZSWatch project <https://github.com/jakkra/ZSWatch/>.
 * Copyright (c) 2023 Jakob Krantz.
 *
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
 * You should have received a copy of the GNU General Public License
 * along with this program. If not, see <http://www.gnu.org/licenses/>.
 */

#include <zsw_power_manager.h>
#include <zephyr/kernel.h>
#include <zephyr/init.h>
#include <events/accel_event.h>
#include <zephyr/zbus/zbus.h>
#include <display_control.h>
#include <lvgl.h>
#include <zephyr/logging/log.h>
#include <events/activity_event.h>
#include <ram_retention_storage.h>
#include <zsw_cpu_freq.h>

LOG_MODULE_REGISTER(zsw_power_manager, LOG_LEVEL_INF);

#ifdef CONFIG_BOARD_NATIVE_POSIX
#define IDLE_TIMEOUT_SECONDS    UINT32_MAX
#else
#define IDLE_TIMEOUT_SECONDS    20
#endif

static void update_and_publish_state(zsw_power_manager_state_t new_state);
static void enter_active(void);
static void enter_inactive(void);
static void handle_idle_timeout(struct k_work *item);
static void zbus_accel_data_callback(const struct zbus_channel *chan);

K_WORK_DELAYABLE_DEFINE(idle_work, handle_idle_timeout);

ZBUS_CHAN_DECLARE(activity_state_data_chan);

ZBUS_CHAN_DECLARE(accel_data_chan);
ZBUS_LISTENER_DEFINE(power_manager_accel_lis, zbus_accel_data_callback);

static bool is_active = true;
static bool is_stationary;
static uint32_t last_wakeup_time;
static uint32_t last_pwr_off_time;
static zsw_power_manager_state_t state;

bool zsw_power_manager_reset_idle_timout(void)
{
    if (!is_active) {
        // If we are inactive, then this means we we should enter active.
        enter_active();
        return true;
    } else {
        // We are active, then just reschdule the inactivity timeout.
        k_work_reschedule(&idle_work, K_SECONDS(IDLE_TIMEOUT_SECONDS));
        return false;
    }
}

uint32_t zsw_power_manager_get_ms_to_inactive(void)
{
    if (!is_active) {
        return 0;
    }
    uint32_t time_since_lvgl_activity = lv_disp_get_inactive_time(NULL);
    uint32_t time_to_timeout = k_ticks_to_ms_ceil32(k_work_delayable_remaining_get(&idle_work));

    if (time_since_lvgl_activity >= IDLE_TIMEOUT_SECONDS * 1000) {
        return time_to_timeout;
    } else {
        return MAX(time_to_timeout, IDLE_TIMEOUT_SECONDS * 1000 - lv_disp_get_inactive_time(NULL));
    }
}

zsw_power_manager_state_t zsw_power_manager_get_state(void)
{
    return state;
}

static void update_and_publish_state(zsw_power_manager_state_t new_state)
{
    state = new_state;

    struct activity_state_event evt = {
        .state = state,
    };
    zbus_chan_pub(&activity_state_data_chan, &evt, K_MSEC(250));
}

static void enter_inactive(void)
{
    LOG_INF("Enter inactive");
    is_active = false;
    retained.wakeup_time += k_uptime_get_32() - last_wakeup_time;
    retained_update();
    display_control_sleep_ctrl(false);

    zsw_cpu_set_freq(ZSW_CPU_FREQ_DEFAULT, true);

    // Screen inactive -> wait for NO_MOTION interrupt in order to power off display regulator.
    zsw_imu_feature_enable(ZSW_IMU_FEATURE_NO_MOTION, true);
    zsw_imu_feature_disable(ZSW_IMU_FEATURE_ANY_MOTION);

    update_and_publish_state(ZSW_ACTIVITY_STATE_INACTIVE);
}

static void enter_active(void)
{
    LOG_INF("Enter active");
    int ret;

    is_active = true;
    is_stationary = false;
    last_wakeup_time = k_uptime_get_32();

    // Running at max CPU freq consumes more power, but rendering we
    // want to do as fast as possible. Also to use 32MHz SPI, CPU has
    // to be running at 128MHz. Meaning this improves both rendering times
    // and the SPI transmit time.
    zsw_cpu_set_freq(ZSW_CPU_FREQ_FAST, true);

    ret = display_control_pwr_ctrl(true);
    display_control_sleep_ctrl(true);

    if (ret == 0) {
        retained.display_off_time += k_uptime_get_32() - last_pwr_off_time;
        retained_update();
    }

    // Only used when display is not active.
    zsw_imu_feature_disable(ZSW_IMU_FEATURE_NO_MOTION);
    zsw_imu_feature_disable(ZSW_IMU_FEATURE_ANY_MOTION);

    update_and_publish_state(ZSW_ACTIVITY_STATE_ACTIVE);

    k_work_schedule(&idle_work, K_SECONDS(IDLE_TIMEOUT_SECONDS));
}

static void handle_idle_timeout(struct k_work *item)
{
    uint32_t last_lvgl_activity_ms = lv_disp_get_inactive_time(NULL);

    if (last_lvgl_activity_ms > IDLE_TIMEOUT_SECONDS * 1000) {
        enter_inactive();
    } else {
        k_work_schedule(&idle_work, K_MSEC(IDLE_TIMEOUT_SECONDS * 1000 - last_lvgl_activity_ms));
    }
}

static void zbus_accel_data_callback(const struct zbus_channel *chan)
{
    const struct accel_event *event = zbus_chan_const_msg(chan);

    switch (event->data.type) {
        case ZSW_IMU_EVT_TYPE_WRIST_WAKEUP: {
            if (!is_active) {
                LOG_DBG("Wakeup gesture detected");
                enter_active();
            }
            break;
        }
        case ZSW_IMU_EVT_TYPE_NO_MOTION: {
            LOG_INF("Watch enterted stationary state");
            if (!is_active) {
                is_stationary = true;
                last_pwr_off_time = k_uptime_get();
                display_control_pwr_ctrl(false);
                zsw_imu_feature_enable(ZSW_IMU_FEATURE_ANY_MOTION, true);
                zsw_imu_feature_disable(ZSW_IMU_FEATURE_NO_MOTION);

                update_and_publish_state(ZSW_ACTIVITY_STATE_NOT_WORN_STATIONARY);
            }
            break;
        }
        case ZSW_IMU_EVT_TYPE_ANY_MOTION: {
            LOG_INF("Watch moved, init display");
            if (!is_active) {
                is_stationary = false;
                display_control_pwr_ctrl(true);
                retained.display_off_time += k_uptime_get_32() - last_pwr_off_time;
                retained_update();
                zsw_imu_feature_enable(ZSW_IMU_FEATURE_NO_MOTION, true);
                zsw_imu_feature_disable(ZSW_IMU_FEATURE_ANY_MOTION);

                update_and_publish_state(ZSW_ACTIVITY_STATE_INACTIVE);
            }
            break;
        }
        default:
            break;
    }
}

static int zsw_power_manager_init(void)
{
    last_wakeup_time = k_uptime_get_32();
    last_pwr_off_time = k_uptime_get_32();
    k_work_schedule(&idle_work, K_SECONDS(IDLE_TIMEOUT_SECONDS));
    return 0;
}

SYS_INIT(zsw_power_manager_init, APPLICATION, CONFIG_APPLICATION_INIT_PRIORITY);
