jakkra/ZSWatch/app/src/zsw_clock.h

/*
 * This file is part of ZSWatch project <https://github.com/jakkra/ZSWatch/>.
 * Copyright (c) 2023 Jakob Krantz.
 *
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
 * You should have received a copy of the GNU General Public License
 * along with this program. If not, see <http://www.gnu.org/licenses/>.
 */

#pragma once

#include <zephyr/drivers/rtc.h>

#include <inttypes.h>
#include <time.h>

#if CONFIG_RTC
typedef void (*zsw_clock_on_update)(void);
#endif

typedef struct {
#if CONFIG_RTC
    struct rtc_time tm;     /**< Modified time object with 1900 added to the year*/
#else
    struct tm   tm;         /**< Modified time object with 1900 added to the year*/
#endif
    uint32_t    tv_usec;
} zsw_timeval_t;

/**
 * Sets the time of the clock.
 *
 * @param ztm A pointer to a `zsw_timeval_t` structure representing the desired time.
 */
void zsw_clock_set_time(zsw_timeval_t *ztm);

/**
 * @brief Retrieves the current time from the.
 *
 * This function retrieves the current time from the clock and stores it in the provided zsw_timeval_t structure.
 *
 * @param ztm Pointer to the zsw_timeval_t structure where the current time will be stored.
 */
void zsw_clock_get_time(zsw_timeval_t *ztm);

/**
 * @brief Sets the timezone for the ZSW clock.
 *
 * This function sets the timezone for the clock. The timezone is specified
 * using the provided string in setenv and tzset format.
 *
 * @param tz The timezone string to set.
 */
void zsw_clock_set_timezone(char *tz);

/**
 * @brief Converts a zsw_timeval_t structure to a struct tm structure.
 *
 * This function converts a zsw_timeval_t structure to a struct tm structure.
 *
 * @param ztm Pointer to the zsw_timeval_t structure to convert.
 * @param tm Pointer to the struct tm structure where the converted time will be stored.
 */
void zsw_timeval_to_tm(zsw_timeval_t *ztm, struct tm *tm);
