jakkra/ZSWatch/app/src/dfu.h

/*
 * Copyright (c) 2023 Victor Chavez
 *
 * SPDX-License-Identifier: GPL-3.0-or-later
 */

#pragma once

/**
 * @brief Initialize Device firmware upgrade functionality
 * @details Registers callback to manage image upload
 *
 */
void dfu_init();
