jakkra/ZSWatch/app/drivers/sensor/bmi270/trigger/bosch_bmi270_interrupt.h

/* bosch_bmi270_interrupt.h - Driver for Bosch BMI270 IMU. */

/*
 * Copyright (c) 2023, Daniel Kampert
 *
 * SPDX-License-Identifier: Apache-2.0
 */

#pragma once

/** @brief          
 *  @param p_dev    
 *  @return         0 when successful
*/
int bmi2_init_interrupt(const struct device *p_dev);

/** @brief          
 *  @param p_dev    
 *  @param p_trig   
 *  @param handler  
 *  @return         0 when successful
*/
int bmi270_trigger_set(const struct device *p_dev, const struct sensor_trigger *p_trig, sensor_trigger_handler_t handler);
