jakkra/ZSWatch/(commit log)

2022-08-27 Screen working and displaying LVGL sample.
2022-09-04 Initial schematic done. Some TODOs left.
    [nrf-watch-kicad.kicad_pcb, nrf-watch-kicad.kicad_sch]
2022-09-05 Schematic pretty much done, final review left.
    [nrf-watch-kicad.kicad_sch]
2022-09-06 Started with routing.
    [nrf-watch-kicad.kicad_pcb, nrf-watch-kicad.kicad_sch]
2022-09-08 Routed power, flash, accelerometer and vibration driver.
    [nrf-watch-kicad.kicad_pcb, nrf-watch-kicad.kicad_sch]
2022-09-09 All routed except test pads.
    [nrf-watch-kicad.kicad_pcb, nrf-watch-kicad.kicad_sch]
2022-09-10 Added and routed buttons.
    [nrf-watch-kicad.kicad_pcb, nrf-watch-kicad.kicad_sch]
2022-09-10 Fix 1.8V and 3.3V regulator bug.
    [nrf-watch-kicad.kicad_pcb, nrf-watch-kicad.kicad_sch]
2022-09-11 Neat up the silkscreen a bit and move around the testpoints.
    [nrf-watch-kicad.kicad_pcb]
2022-09-11 Before moving bottom to top
    [nrf-watch-kicad.kicad_pcb, nrf-watch-kicad.kicad_sch]
2022-09-11 Moved 5V regulator to top side.
    [nrf-watch-kicad.kicad_pcb]
2022-09-11 Squeezed all support components for Biometric sensor onto top lower.
    [nrf-watch-kicad.kicad_pcb]
2022-09-12 Routed out the antenna pins so that a wire antenna could be solder onto it if needed. Added a bunch of test points.
    [nrf-watch-kicad.kicad_pcb, nrf-watch-kicad.kicad_sch]
2022-09-14 Make sure buttons are aligned perfectly.
    [nrf-watch-kicad.kicad_pcb]
2022-09-14 Add gerbers used to produce PCB version 0.1.
2022-09-18 Initial board setup.
2022-09-19 Support for multiple buttons.
2022-09-19 Add gpio debugging capabilities to debug potential soldering or PCB issues.
    [main.c]
2022-09-21 Minor estetic changes in sch1ematic.
    [nrf-watch-kicad.kicad_sch]
2022-09-28 Fix pin bug offset in TXB0104QRUTRQ1 footprint.
    [nrf-watch-kicad.kicad_pcb, nrf-watch-kicad.kicad_sch]
2022-09-28 Move ANNA-B4 silkscreen closer to module for easier placing on PCB.
    [nrf-watch-kicad.kicad_pcb]
2022-10-01 Test code to verify PCB.
2022-10-01 Bring in NINA-B406 option fo simpler soldering instead of ANNA.
    [nrf-watch-kicad.kicad_sch]
2022-10-04 LI2DS12, battery voltage reading and display working.
2022-10-12 Add anther page showing accelerometer values.
2022-11-13 Improved time handling by retaining the clock when reset and syncing over BLE.
    [nrf-watch-kicad.kicad_pcb, nrf-watch-kicad.kicad_sch]
2022-11-13 Cleanup: Fix stack overflow. Tweak vibration.
    [main.c]
2022-11-13 Add missing AoA and RAM retention files.
    [ram_retention_storage.h]
2022-11-13 Code cleanup. Formatted all code.
    [astyle.cfg]
2022-11-14 WIP: ISR driven accelerometer.
2022-11-21 Fix missing callback when accelerometer tilt is detected.
    [accelerometer.c]
2022-11-24 Always support hard reset when BUTTON_3 is long pressed.
    [main.c]
2022-12-14 Fix Messenger notifications having wrong body.
    [ble_comm.c, notification_manager.c]
2022-12-17 Add parsing of current time sent from phone.
2022-12-17 Draw temperature and weather icon on the watchface.
2023-01-02 Phone sends temperature in K not F.
2023-01-02 Send battery status to phone.
2023-01-02 Use time set by app instead of requiring Current Time Service on phone.
2023-01-03 Extract vibration and display controls into seperate files. Refactor main.c
    [display_control.c, main.c]
2023-01-03 Add the GC9A01 display driver as an of tree display driver. Previously I copied it manually into Zephyr folder.
    Now kept in application code as it should.
2023-01-05 Adds a simple Application Manager.
    Right now accelerometer and setings are made as applications.
2023-01-06 Fix parsing to many characters in musicinfo.
    [ble_comm.c]
2023-01-09 Fix stack overflow when displaying notification popup, don't do it in BT callback context.
    [main.c, notification_manager.c, notification_manager.h]
2023-01-09 Limit cases when accelerometer double tap and tilt are allowed.
2023-01-11 Move the watch application into app folder.
    [astyle.cfg]
2023-01-12 Add exported schematic of the watch.
    [nrf-watch-kicad.kicad_sch]
2023-01-12 Add Fusion 360 CAD design.
    [watch-and-dock.f3z]
2023-01-13 Name the watch, rename folders etc.
    [nrf-watch-kicad.kicad_pcb, nrf-watch-kicad.kicad_sch]
2023-01-13 Make use of events system to propogate accelerometer events.
2023-01-16 Add BOM and document PCB v1 issues.
    [zswatch-bom.csv]
2023-02-03 Add finished schematic for v2. Document more news in v2 and a small update of the progress.
2023-02-06 Add renders of finished v2 PCB.
2023-02-16 Update to latest v2 schematic.
2023-03-09 Update of v2 status. Add image of assembled and working v2.
2023-03-13 v2 started. nRF5340 (NORA-B106) added.
    [ZSWatch.kicad_pcb, ZSWatch.kicad_sch, zswatch-kicad.kicad_pro.kicad_pcb, zswatch-kicad.kicad_pro.kicad_sch]
2023-03-13 Add Bosch BMI270, new LED backligt driver, replace battery supervisor, new buttons, new display with touch, ESD protected SWD pins.
    [ZSWatch.kicad_sch]
2023-03-13 Remove unused parts from v1.
    [nrf-watch-kicad.kicad_pcb, nrf-watch-kicad.kicad_sch]
2023-03-13 Remove some unneeded components.
    [ZSWatch.kicad_sch]
2023-03-13 Add SWD/JTAG connector.
    [ZSWatch.kicad_sch]
2023-03-13 Started layout and routing of power parts.
    [ZSWatch.kicad_pcb, ZSWatch.kicad_sch, pcb_outline.dxf]
2023-03-13 Routed power management part.
    [ZSWatch.kicad_pcb, ZSWatch.kicad_sch]
2023-03-13 Fix flipped footprint of display connector.
    [ZSWatch.kicad_pcb, ZSWatch.kicad_sch]
2023-03-13 Routed display and vibrator.
    [ZSWatch.kicad_pcb, ZSWatch.kicad_sch]
2023-03-13 Add Bosch BMP581 high accuracy pressure sensor. Routed voltage regulators and HR sensor.
    [ZSWatch.kicad_pcb, ZSWatch.kicad_sch]
2023-03-13 Everything is routed, some minor DRC errors left only.
    [ZSWatch.kicad_pcb, ZSWatch.kicad_sch]
2023-03-13 Add LIS2MD magnetometer and Bosch BME688.
    [ZSWatch.kicad_pcb, ZSWatch.kicad_sch]
2023-03-13 Fixed some DRC errors and warnings.
    [ZSWatch.kicad_pcb]
2023-03-13 All DRC errors handled.
    [ZSWatch.kicad_pcb, ZSWatch.kicad_sch]
2023-03-13 Add some nice silkscreen on the back.
    [ZSWatch.kicad_pcb]
2023-03-13 Renaming some labels. Moved RESET_N to magnetic connector.
    [ZSWatch.kicad_pcb, ZSWatch.kicad_sch]
2023-03-13 Add kitkit config for panalization and the panalized PCB (WIP).
2023-03-13 IDK what I changed.
    [ZSWatch.kicad_sch]
2023-03-13 Make dock connector pin spacing 2.54mm so it's more generic.
    [ZSWatch.kicad_pcb, ZSWatch.kicad_sch]
2023-03-13 Add two mounting holes.
    [ZSWatch.kicad_pcb, ZSWatch.kicad_sch]
2023-03-13 Add plugin to generate better BOM. Add link to buy for all components.
    [ZSWatch.kicad_pcb, ZSWatch.kicad_sch]
2023-03-13 LISMDL make solder paste smaller then pad size according to documentation.
    [ZSWatch.kicad_pcb]
2023-03-13 Fix panelization, plugin requires all filled zones inside Edge.Cuts.
    [ZSWatch.kicad_pcb]
2023-03-13 Cleanup v2 KiCad project.
    [zswatch-kicad.kicad_pro.kicad_pcb, zswatch-kicad.kicad_pro.kicad_sch]
2023-03-13 Add bom generation config.
2023-03-13 Programmer/Dock schematic and routing finished.
    [dock.kicad_pcb, dock.kicad_sch, dock.sch]
2023-03-13 Add generated interactive BOM to help with manual assembly.
2023-03-13 Correct some pin mappings. BMP581 working.
    [main.c]
2023-03-13 Use all 4 buttons correctly.
    [main.c]
2023-03-13 Add option to build the application for PCB without touch screen.
    Usage:
    -DDTC_OVERLAY_FILE=boards/no_touch.conf
    -DDTC_OVERLAY_FILE=boards/no_touch.overlay
2023-03-13 Bluetooth now works and the child image for net core is configured correctly for the required features.
    [main.c]
2023-03-13 PWM brightness change.
2023-03-13 Add BMI270 port and drivers from Bosch as submodule.
    Will use Bosch drivers as they are way more powerful compared
    to what is right now implemented in Zephyr.
2023-03-13 Pure Zephyr build: Replace nRF event manager with ZBUS.
    [accelerometer.c, ble_comm.c, main.c]
2023-03-13 Adopt accelerometer code to use Bosch driver instead of Zephyr one for BMI270.
2023-03-14 Add Bosch BMP581 driver including interrupt support.
2023-03-14 Publish pressure readings for subscribing to.
2023-03-15 Add INT support and more dynamic driver design for BMI270 IMU.
2023-03-15 Adjust watchface after color fixes in display driver.
2023-03-15 Bump BT Host RX thread stack size so we can do some smaller stuff in the callbacks from it.
2023-03-15 Formatting fix for main.c
    [main.c]
2023-03-17 Fix BMI270 interrupts configuration. Working step counter.
    [accelerometer.c]
2023-03-17 Add IMU styp activity feature.
2023-03-20 Disable UART as it's not used to save power.
2023-03-20 Display Driver: in order to save power disable SPI inbetween display updates.
2023-03-20 Display Driver: Initialize all pins to disabled to have a known state at init.
2023-03-20 Disable KSCAN until there is working HW to try it on and optimzie it's power consumption.
2023-03-20 Tweak accelerometer default config in order to save power.
2023-03-20 Optimize default pressure sensor config for reduced power consumption.
2023-03-20 Reduce magnetometer default ODR to 1Hz. More improvements needed here.
2023-03-20 Fix invalid error print in vibrator.
2023-03-20 To save power, don't update the watchface unless something changed.
2023-03-20 Note about PWM power consumption for future me.
2023-03-20 Fix pressure sensor ODR not being set correctly.
    [pressure_sensor.c]
2023-03-22 Turn of PWM after use to save power.
2023-03-22 Use regulator API to control display 3v3 regulator.
2023-03-23 Functionality to do a hard off and reinit of the display in order to achieve very low power consumption.
    Current config with sensors still running and BLE connected or advertising power consumption is about 50uA.
2023-03-23 Template app: Button close functinality not needed anymore.
    Since there now is a dedicated physical button for exiting/going back the template
    app does not need a close button anymore. Now it will demonstrate counting a value instead
    when pressed.
2023-03-24 Add API for CPU clock frequence. Increase CPU clock to 128MHz during rendering.
    Bumping the CPU Clock frequence to 128MHz during rendering and SPI transfer (128MHz needed for 30MHz SPI) will
    make the UI even more responsive. Keep the clock at 64MHz at other times as it will consume
    about 400uA more at 128MHz.
2023-03-28 Fix always using 1% display brightness.
    [display_control.c]
2023-03-28 CST816S touch chip need to be powered on when Zephyr is booting in order for everything to work.
2023-03-28 Replace touch chip logic shifter with one that works with I2C.
    Replace TXB0104 with pin compatible NTS0104GU12. It includes internal
    pullups hence the touch I2C pin pullups are removed.
    For ZSWatch without touch screen then we may still mount TXB0104 as I can see
    there may be some current leakage when running SPI and using NTS0104 due to it's
    internal pullups. Will test this later.
    [ZSWatch.kicad_pcb, ZSWatch.kicad_sch]
2023-03-30 Add battery charging status detection.
2023-04-02 Add missing charging inducator GPIO to devicetree.
2023-04-02 Make it possible to run ZSWatch SW on a nRF5340-DK or NORA-B1-EVK.
    The Dev Kits have the required 4 buttons already, all extra HW needed is
    a breakout of the display."
2023-04-03 Implement proper device power control of GC9A01.
2023-04-03 Add charging event. Send to phone etc. when charge state changes.
2023-04-26 Move display connector so there is no strain on the cable. From now on only touch screen is supported. Remove none touch screen connector as it does not fit anymore.
    The moving of touch display connector caused a bit of re-routing. Without redoing alot of the routing
    we need the space used by the connector to the none touch screen. From now on only touch screen is supported.
    [ZSWatch.kicad_pcb, ZSWatch.kicad_sch]
2023-04-27 Minor tidy up of v2 PCB and improved silkscreen.
    [ZSWatch.kicad_pcb]
2023-04-30 When close button is pressed and no app is running, then exit the application picker.
2023-05-02 Fix color of minute hand since display driver color fix.
2023-05-02 Display correct (inherited) background color in accelerometer app.
2023-05-04 Don't format code in external driver submodules.
2023-05-04 Added inactivity tracking to save power. Turn off screen etc. when user is inactive.
    Pressing any button or doing a wakeup gesture will turn display on again.
2023-05-04 Publish event when watch activity changes, enables power save functionality depending on if user is active or not.
2023-05-05 Make hour hand slot transparent.
2023-05-08 Changed logic converter IC to NTS0104, no variant with old one. Re-generate ibom.
    [ZSWatch.kicad_pcb, ZSWatch.kicad_sch]
2023-05-13 Change what's considered up and down on the app, by mirroring the buttons.
2023-05-13 Swap the "select" button with the "back/exit" button.
    [main.c]
2023-05-13 Fix error in display power control logic, did not follow intended use of device_pm.
    [display_control.c]
2023-05-14 Revert "Swap the "select" button with the "back/exit" button."
    This reverts commit e80c664d5f6677afc497b7dd80775459f7f2c4f3.
    [main.c]
2023-05-15 Do axis remapping of BMI270. Due to PCB is now mounted upsidedown in enclosure.
    The BMI270 is now rotated 180 degree, hence we need to configure it accordingly for all features to work.
2023-05-15 Fix/workaround step counting not firing INT.
    Probably something I miss, it used to work, for now just poll steps whenever
    there is another event.
    [accelerometer.c]
2023-05-19 Finished dock/debugger/programmer PCB.
    Moved connectors around.
    Added missing silkscreen.
    Added extra connector for easy access to pins such as power etc.
    [dock.kicad_pcb, dock.kicad_sch]
2023-05-19 Dock PCB: Minor routing and silkscreen improvements.
    [dock.kicad_pcb, dock.kicad_sch]
2023-05-19 Move CST816S touch driver into repo to allow modifications in it.
2023-05-19 Add device power control to cst816s touch driver.
2023-05-19 Add a battery manager that handles sampling and publishes periodically battery level.
2023-05-21 Watchface cache connected status, weather, battery and charge status.
2023-05-22 ZSWatch PCB: Minor cleanup.
    [ZSWatch.kicad_sch]
2023-05-22 Patch to make CST816s to work with Zephyr and LVGL port.
    I'm not sure where the real bug is, but for now this solves it.
    [kscan_cst816s.c]
2023-05-22 Don't format driver code copied from Zephyr.
2023-05-22 Save battery by only enabling accelerometer features currently used.
    ISR will trigger each time those happens and consume battery. Enable again when used.
2023-05-22 Add battery history application.
    Since storage is not implemented yet, the app will collect and cache one sample per hour.
2023-05-23 Add battery app icon and tune chart.
2023-05-23 Add function to read out current display brightness.
2023-05-23 Add "x-ray" application. Shows the inside PCB of the watch as seen below the screen.
2023-05-23 Music app: keep track of played music when app is not active so that when opened it's there immediately. Remove back button.
2023-05-23 Enable IMU features again, but add option to disable ISR report of them.
2023-05-23 When the watch is inactive, save power by not waking up every seconds to update watchface.
2023-05-30 Overwrite RTT logs, so that after attaching debugger we can read out the last logs.
2023-06-01 When dislay has been off, we need to clear cached values in watchface used to optimize.
    Otherwise they won't be updated until the values changes.
    [watchface_app.c]
2023-06-04 Vibration feedback also when clicking using touch.
    [main.c]
2023-06-04 Add support for remote control of the ZSWatch.
    Done by sending emulated button pressed over BLE.
2023-06-06 Add release build that will enable watchdog and reset on crash.
    [main.c]
2023-06-06 For now don't vibrate when screen is clicked as it will vibrate for all presses and not only buttons etc. Needs fix.
    [main.c]
2023-06-06 Add config for fast display wakup, will consume more power however. Should be a setting on the watch later.
2023-06-06 Enable UART by default in ZSWatch_nrf5340 board, but turn it off by default in prj.conf. Makes it easier to enable logs on UART.
2023-06-08 Remove prints from pressure_sensor.c.
2023-06-09 Add System Info app showing stats such as uptime, display on time etc. since last power loss.
2023-06-10 Fix bug that any gesture would turn on the display bypassing active/inactive mode.
    [display_control.c, main.c]
2023-06-11 Show dummy weather icon and temperature until weather info is received from phone app.
2023-06-11 Fix notification crash when fields are empty. Make sure empty string are also NULL terminated.
    [ble_comm.c]
2023-06-12 Return error when trying to use accelerometer if init failed.
    [accelerometer.c]
2023-06-13 Watch temperature reading from BME688 instead from BMP581.
2023-06-13 Fix flickering display. From way too low 50Hz to now 2kHz.
    1kHz is probbaly enought, maybe even 500Hz, but let's stay safe.
2023-06-14 Display brightness fix, works OK but not for all brightness levels but not correct TODO added.
    [display_control.c]
2023-06-15 Update BLE Controller image with fix for long connection intervals.
    [ble_comm.c]
2023-06-15 Disable SPI after setting power mode for display. Fixes higher current consumption than expected.
2023-06-15 Only use magnetometer when the compass app is used. Fixes increased current consumption.
    [magnetometer.c]
2023-06-15 Enable runtime device power management to auto disable I2C when not used (fixes touch increased current consumption).
2023-06-15 Advertise less often to consume less battery. Once per second should be enough. Phone should not disconnect very often anyway.
2023-06-16 Make remote control scripts synced. Add UI to remote click ZSWatch buttons.
2023-06-16 Remove assert when powering down display if it's already in sleep.
2023-06-20 Fix watchface battery not showing old samples.
    [watchface_app.c]
2023-06-23 Add command to reset the UI state when doing remote control.
    [ble_comm.c, main.c]
2023-06-23 Fix crash when parsing notifications if they miss a fields.
    [ble_comm.c]
2023-06-24 Native Posix build working.
    There are some limitations, but working pretty well.
    Going back is left->right swipe (does not work with full creen images apps)
    [accelerometer.c, display_control.c, magnetometer.c, main.c, pressure_sensor.c]
2023-06-26 Schematic: Re-generate latest schematic after some cleanup. Remove obsolete v1 kicad project.
    [ZSWatch.kicad_sch, nrf-watch-kicad.kicad_pcb, nrf-watch-kicad.kicad_sch, zswatch-bom.csv]
2023-06-26 CAD: Update to latest casing design. Still a bit WIP, but works.
    [watch-and-dock.f3z]
2023-07-08 New way to handle periodic events. Save power by having periodic events published if there is someone observing.
    For peridic events exact period is not important, hence we can update everyone at once, instead of waking up every time for every app/file using k_work_reschedule for periodic tasks.
    We can extend with other intervals if needed.
2023-07-09 Fix nRF plugin detecting zswatch board when root folder is opened instead of "app" folder.
2023-07-09 Fixes for native_posix build for Zephyr 3.4 / NCS 2.4.
    [display_control.c]
2023-07-12 Watchface: Fix UI not being updated correctly when waking up.
    [watchface_app.c]
2023-07-20 Add getters for magnetometer data.
2023-07-20 Add GATT Battery Service.
2023-07-20 Enable Gyro functionality.
2023-07-20 Set log level warn for sensors in debug build.
2023-07-22 Refactor sensor files and usage.
2023-07-22 Add services that exposes sensors over GATT.
    For use with https://github.com/jakkra/ZSWatch-Web-Dashboard
    Service ids taken from https://github.com/adafruit/bluetooth-low-energy
    in order to have compatability with Adafruit tools.
2023-07-24 Rename accelerometer to imu, as BMI270 is an imu.
2023-07-24 Add simple hardiron calibration of magnetometer.
2023-07-26 Settings App: Add button settings type.
2023-07-27 Fix some invalid code formatting.
    [ble_comm.c, ble_transport.c]
2023-07-27 Avoid accidental presses by not using events until gesture is finished.
    [main.c]
2023-07-29 Make notifications list an application.
    No dedicated button to show notification, instead swipe left to right on watchface.
2023-07-31 Initial hardware changes to add an external flash (AT25SL128A) to ZSwatch.
    [ZSWatch.kicad_pcb, ZSWatch.kicad_sch]
2023-07-31 Updated flash pcb design, with DRC rule fixes.
    - Lowered down silkscreen of ZWatch to add test points to SPI for testing.
    - Ground pad of flash is connected but is not necessary and can be removed
    to simplify connections.
    - Due to size constraints added 0402 resistors for pull up resistors on the left side
    of the flash.
    - Pending, change name of FLASH in Kicad to AT25SL128A.
    [ZSWatch.kicad_pcb, ZSWatch.kicad_sch]
2023-07-31 PCB: Tidy up some traces and vias for external flash feature.
    [ZSWatch.kicad_pcb]
2023-07-31 PCB: Move draft flash schematic into its own section. Correct datasheet and model number of flash.
    [ZSWatch.kicad_sch]
2023-07-31 PCB: Fix and exclude DRC errors/warnings we don't care about. Some introduced by moving to KiCad 7.
    [ZSWatch.kicad_pcb]
2023-08-02 Added DFU with MCUBoot and external flash
    - This change adds support for the MCUBootloader with
    the external flash AT25SL128A. The spi nor flash driver
    has been activated, configuration for MCUMgr and the
    BT SMP transport for DFU have been activated.
    - Overlay for MCUBoot child image and proper configuration for
    net core have been also included.
    - Enforce use of P0.00 and P0.00 pins as GPIOs in defconfig of
    board files.
    - Declaration of static partition for DFU with use of external flash
    for LittleFS, NVS, and MCUBoot secondary partition.
    - DFU callback management to reduce connection interval for faster
    throughput.
2023-08-02 Inreased DFU speed with MCUMgr
    Added CONFIG_MCUMGR_TRANSPORT_BT_CONN_PARAM_CONTROL to control
    automatically speed of ble connection when SMP is active.
    In addition a patch suggested here was added
    https://github.com/jakkra/ZSWatch/pull/26#issuecomment-1656933604
    [ble_comm.c, dfu.c]
2023-08-02 Added conditional compilation of DFU if not a posix board.
2023-08-02 Use board revisions to handle external flash.
2023-08-02 -Added regex command to select DFU if rev>2 - Added github actions to build the rev1 and rev2 of board.
2023-08-02 Added workflow to build different revision boards.
2023-08-02 Update building instructions to match board revision additions.
2023-08-03 Fix gestures not working within apps due to main grabbing the event.
    Now only do lv_indev_wait_release(lv_indev_get_act()); when it was a swipe on the watchface.
    [main.c]
2023-08-07 Fix slow periodic event publishing to wrong channel.
    [zsw_periodic_event.c]
2023-08-07 Cleanup where current time is periodically stored into retention RAM.
2023-08-08 ci: Fix not building all board variants.
2023-08-10 Update notification close workaround.
    100ms delay stopped working, let's go with 500ms...
    [main.c]
2023-08-11 ui: watchface: Fix humidity and pressure arc range.
2023-08-12 imu: Add way of detecting when watch is stationary.
    Can be used to further implement new power saving functionality.
2023-08-15 display: Optimize the way display power is handled.
    This will turn off the display power completely after the watch has been left stationary for some time. As soon as the watch is moved, power will be applied and GC9A01 will be initialized, so that we can still have a fast wakeup when user wakes up the watch again.
2023-08-15 display: Avoid showing random data when display has been off.
    [display_control.c]
2023-08-15 power manager: Make the watch idle time 20s and the watch stationary 30s.
2023-08-15 imu: Add support to dynamically enable/disable features.
    Can be used either to save power when features are not used,
    or as a way to manage watch movement states.
    NOTE: Right now assumptions are made that only zsw_power_manager have
    control of NO_MOTION and ANY_MOTION features.
2023-08-15 display: Protect functions with mutex. Functions return error code.
    [display_control.c]
2023-08-15 display: Keep track of how much time display is powered off in retention RAM.
2023-08-15 display: Fix native_posix build error.
    [display_control.c]
2023-08-15 info app: Show time 3V3 regulator has been off.
2023-08-15 Bluetooth: Fix regression since DFU with wrong connection intervals.
    Short intervals was used when long was requested (low power).
    [ble_comm.c]
2023-08-15 info_ui app: Add buttons that resets retained RAM.
    [ram_retention_storage.h]
2023-08-15 display: Handle button wakeup same time as ANY_MOTION triggers.
2023-08-15 Don't wakeup display and vibrate when notification is received if watch is not worn.
    [main.c, zsw_imu.c, zsw_power_manager.c]
2023-08-15 imu: Fix error when enabling BMI270 features. Regression from 17d22ae3911e06ec00fccca4437c8c9ad4d8f166
    [zsw_imu.c]
2023-08-15 imu: Remove defines to control features as dynamic feature enable/disable is now supported.
2023-08-17 watchface: Change watchface during runtime. Multiple watchfaces can now be swapped between.
    Swip left to right on any watchface to change the current watchface to the next one.
    Keeping defines to enable different watchface for now as watchfaces may consume flash needed
    for something else, and can then be disabled.
    [main.c, watchface_app.c, zsw_power_manager.c]
2023-08-19 Extend close button touch area, expand title on click
2023-08-19 Fix long notifications not being shown and parsed correctly.
    Due to 8 bit variable overflow.
    Due to parse buffer not being large enough.
    Added warning and proper handling in case payload
    from GadgetBridge is too big.
    [ble_comm.c, ble_transport.c]
2023-08-26 Rework vibrations, patterns now run async, fixes https://github.com/jakkra/ZSWatch/issues/43
    [main.c, watchface_app.c, zsw_vibration_motor.c, zsw_vibration_motor.h]
2023-08-27 Fix crash when receiving multiple notification close after eachother.
    Issue due to opening notifications is done after a context switch in lvgl context, if another notfication
    was received before this async function was called, the notification would be created twice, causing crash
    when closing it.
    [main.c]
2023-09-04 watchfaces: Support open an app when watchface ui elements are clicked. Fixes https://github.com/jakkra/ZSWatch/issues/52
    For example clicking the battery arc will open the battery app.
    [main.c, watchface_app.c]
2023-09-09 Status update in README about current status.
2023-10-01 Use upstream Zephyr and Zephyr Workspace structure and west to feteh correct Zephyr.
    [display_control.c, input_cst816s.c, watchface_app.c, zsw_periodic_event.c]
2023-10-01 Remove Heart Rate Sensor.
    There are 2 main reasons I have put pretty much no effort into the MAX30101:
    Getting good heart rate readings require ALOT of clever algorithms, there are some online, but tbh I have not found any that would work as good as you would expect. Good HR algorithms require fusion with accelerometer data etc. to be accurate when moving, as light may slip in below the watch and make the data "bad", hence accelerometer data needs to be fused toghether. So a lot of work would be needed, work I don't find fun :p
    Mechanically it turned out to be a real challenge with the watch case. I have the sensor on the bottom of the PCB, and the sensor needs to sit directly touching the s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
    [main.c, watchface_app.c]
2023-10-01 Hardware moved to seperate repos.
    [ZSWatch.kicad_pcb, ZSWatch.kicad_sch, dock.kicad_pcb, dock.kicad_sch, dock.sch, pcb_outline.dxf]
2023-10-01 Fix zbus breaking change in latest Zephyr.
    [zsw_periodic_event.c]
2023-10-02 Update axis remapping for BMI270 on revision 3 PCB.
2023-10-02 Fix wrong pin for BMI270 INT1 causing issues with external flash.
2023-10-02 Fix CPU freq. not being clocked down when entering inactive mode.
    [zsw_power_manager.c]
2023-10-04 imu: Fix readout check for axis remap.
    [zsw_imu.c]
2023-10-07 - Remove MAX30101 from device tree - Make the default applications selectable via Kconfig
2023-10-08 - Create a new branch for starting working on APDS9306 driver.
2023-10-08 - Align sensor driver directory structure with the Examplesensor example - Zephyr path doesn´t work in the drivers CMakeLists currently and will be handled later
2023-10-08 - Driver is functional - Has some open topics (see TODO)
2023-10-08 - Enable default applications in Kconfig - Convert tabs to spaces - Fix typo `yn` in project Kconfig
    [apds9306.c]
2023-10-08 - Fix typo with "ny" in Kconfig - Set accelerometer application as requirement for ZDS application - Enable default applications and disable the reset - Fix wrong config macro in CMakeLists for ZDS a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
2023-10-08 Support placing LVGL resourses in the external SPI Flash. Uploading using RTT.
    How it works:
    - Debugger writes magic number into a RAM address.
    - Debugger resets CPU
    - Application read the magic number
    - If set then don't start normal application, instead start RTT flash loader.
    - Upload the filesystem or dump it from target.
    - Debugger issues a reset.
    - Application boots as normal.
    [main.c, zsw_charger.c, zsw_filesystem.c, zsw_rtt_flash_loader.c, zsw_rtt_flash_loader.h]
2023-10-08 LVLG Resources: Fix correct header size calculation.
    [zsw_filesystem.c, zsw_lvgl_spi_decoder.c, zsw_rtt_flash_loader.c]
2023-10-09 - Add light sensor to sensor summary - Add light sensor configuration to project configuration - Change data type for "sensors_summary_ui_set_*" functions to "float" because all other functions are u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
    [apds9306.c, zsw_env_sensor.c, zsw_light_sensor.c, zsw_magnetometer.c]
2023-10-09 flash loader: Fix dumping of flash.
    [zsw_rtt_flash_loader.c]
2023-10-11 fixup! - Add light sensor to sensor summary - Add light sensor configuration to project configuration - Change data type for "sensors_summary_ui_set_*" functions to "float" because all other function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
2023-10-11 Sensor summary app: Fix compile errors.
2023-10-17 Fix notification parsing after new Gadgetbridge update.
    Codebase now requies Gadgetbridge 0.76.1a
    [ble_comm.c]
2023-10-17 - Do some clean up in APDS9306 driver by removing unneccesary variables and simplify bit shift macros - Working on touch driver as input device. Touch seem to work now. It can be used via the input s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
2023-10-17 - Align button numbers in device tree with schematics - Add a unique button keys (INPUT_KEY_1 to 4) to each of the push buttons in device tree - Add button key INPUT_KEY_POWER to charger in device tr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
    [input_cst816s.c, main.c]
2023-10-17 - Clean up double includes - Reorganize code - Add Powershell script for code formatting with astyle - Apply code formatting with astyle
2023-10-17 - Replace LVGL gesture callback - Fix a bug where swiping during display off causes an interaction on the display - Rework GPIO code in LVGL encoder for input subsystem logic - Remove old GPIO code -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
    [main.c]
2023-10-17 - Fix swapped right and left swipe event - Apply snake_case pattern to variables in APDS9303 and CST816S driver - Add worker queue to APDS9306 driver to reduce system load during a continous readout 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
    [apds9306.c, input_cst816s.c, main.c]
2023-10-17 Keep Zephyr code formatting on drivers copid from Zephyr.
    This makes diffing when they are changed upstream much easier.
2023-10-17 Fix native_posix after input code rework.
    [main.c]
2023-10-18 Add west extension 'west format' that run code formatting and new github actions to check format on PRs before they can be merged.
    Fixes https://github.com/jakkra/ZSWatch/issues/89
    [astyle.cfg]
2023-10-20 - Add Bosch BME6XX driver as submodule - Disable BME680 support in project configuration - Rename submodule path for BMI270 sensor to align it with the other external drivers - Remove not needed "CON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
2023-10-21 Case: Add CAD and 3D printing files for the case.
2023-10-24 Fix battery not being initialized before battery_manager runs.
    [battery.c, zsw_vibration_motor.c]
2023-10-26 Sensors Summary - Rework "Sensors Summary" application to use sensor subsystem - Remove "zsw_light_sensor" and "zsw_env_sensor" from project - Remove "zsw_env_sensor" from "Sensors Summary" applicati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
    Bosch BSEC integration
    - Add IAQ application
    - Remove gas resistance from "Sensors Summary" application
    - Add IAQ output to "Sensors Summary" application
    Kconfig
    - Add "Default configuration" menu to Kconfig
    - Rename "CONFIGURATION_IDLE_TIMEOUT_SECONDS" into "POWER_MANAGEMENT_IDLE_TIMEOUT_SECONDS" and move it to "Default configuration" menu
    - Move "SENSOR_REFRESH_INTE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
    [apds9306.c, ble_transport.c, bme68x_iaq.c, bme68x_iaq.h]
2023-10-30 - Add "About" application - Add application version file - Remove Bosch Sensor drivers from the project, because they were added as module - Undo change with ".vscode" directories
2023-10-30 - Remove "CAD" directory, because it is moved into the hardware repository - Add BSEC2 directory to gitignore
2023-10-30 Exclude iaq ui_export folder and format code
    [astyle.cfg]
2023-10-30 SPI Flash Loader: Add a delay to compensate for slower boot time with settings enabled.
2023-11-01 Support none ascii characters sent from Gadgetbridge. Fixes https://github.com/jakkra/ZSWatch/issues/83
    Added new font of size 16 that contains most UTF letters between 0x0 and 0xFF.
    Use this font in notifications.
    Disable ZDS app by default to fit new font with more UTF characters.
    [ble_comm.c]
2023-11-02 notifications: Fix app picker able to open when notification is shown.
    [main.c]
2023-11-02 Fix swiping not dismissing notifications. Don't feed gesture events into LVGL encoder.
    [main.c]
2023-11-02 notification: Fix closing notification opening battery application.
    Clicks where processed also by the element behind the notification, as the notification was closed in press and not press+release.
2023-11-02 Reboot on crash for debug too. If halt is needed, put a breakpoint in k_sys_fatal_error_handler instead.
    [main.c]
2023-11-02 - Add sensor wrapper for light and environment sensor - Replace include guards of all sensor wrapper with "pragma once" - Fix missing light sensor output in "Sensors Summary" app - Set value for ligh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
    [main.c, zsw_light_sensor.c]
2023-11-02 - Replace include guard in APDS9306 driver with "pragma once"
    [apds9306.h]
2023-11-02 IAQ-App: - Remove font - Change data type for IAQ label to float without decimal places
    ADPS9306:
    - Enable ADPS9306 driver for hardware revision 3
    - Move "DT_DRV_COMPAT" in ADPS9306 source file
    - Fix typos in ADPS9306 driver
    - Smaller layout changes
    BMP581:
    - Enable BMP581 driver for all hardware revisions
    - Change BMP581 implementation to sensors subsystem
    - Remove the old BMP581 driver
    - Change path for BMP5 sensor API module to /ext_drivers
    Sensors:
    - Put directory for BMP5 sensor API to gitignore to prevent a listing in git
    - Add CMakeLists for sensors
    - Add ZBUS for light sensor
    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
    [apds9306.c, apds9306.h]
2023-11-02 - Align the names of the sensor get data functions - Refractoring of BMP581 driver - Add ZBUS to magnetometer - Change SENSOR_CHAN_AMBIENT_TEMP in BMP581 driver to SENSOR_CHAN_DIE_TEMP - Remove BME68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
2023-11-08 - Add manufacturer name to driver files for APDS9306, BME688 and BMP581 - Add BMI270 driver directory from Bosch to gitignore because it´s a submodule - Change module path for Bosch BMI270 driver fro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
    [bosch_bme68x_iaq.c, bosch_bme68x_iaq.h, bosch_bmi270.c, bosch_bmi270.h, bosch_bmi270_interrupt.h, bosch_bmp581.c]
2023-11-10 - Simplify BMP581 driver code - Rename "BMI270" driver to "BMI270 Plus" - Rework "zsw_imu" and add IMU subsys - Remove old BMI270 driver - Remove unused variables warning in IAQ app - Remove TODOs fr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
    [avago_apds9306.c, avago_apds9306.h, bosch_bmi270.c, bosch_bmi270.h]
2023-11-10 - Fix different issues in build configurations. Rev1 and Rev2 still have issues open
    Add BMP5 Sensor API submodule
    Fix different CI/CD issues
    Remove wrong sensor API directory
    Add BMI270 Sensor API submodule
    fixup! - Fix different configuration issues for rev1
    - Fix different configuration issues for rev1
2023-11-11 Fix BT Pairable button
2023-11-11 General: - Add debug message when no sensor device is found to sensor wrapper
    APDS9306:
    - Background worker is now using a delayed worker to remove the wait time from the worker handler
    - Replace "EIO" error codes with "EFAULT"
    - Replace "EIO" error codes with "EFAULT"
    IMU:
    - Enable BMI270_Plus sensor instead of the regular BMI270
    - Add missing axis remapping to BMI270 initialization
    - Clean up code
    - Replace "EIO" error codes with "EFAULT"
    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
    [avago_apds9306.c, bosch_bmi270.c, bosch_bmi270_interrupt.c, bosch_bmp581.c, zsw_imu.c]
2023-11-13 fixup! Misc: - Add debug message to timer callback in "Sensors Summary" app - Change description for BME680 section in Kconfig
    Misc: - Add debug message to timer callback in "Sensors Summary" app - Change description for BME680 section in Kconfig
    BMI270:
    - Fix wrong axis remapping cause of compiler optimization
    - Fix application crash through flooding scheduled work pipeline by checking if a work is pending before adding a new one
    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
    [avago_apds9306.c, bosch_bmi270.c, bosch_bmi270_interrupt.c, zsw_imu.c, zsw_magnetometer.c]
2023-11-14 IMU: - Fix wrong axis mapping - Add float readout for IMU - Add activity specific callbacks to BMI270 driver
    [bosch_bmi270.c, bosch_bmi270.h, bosch_bmi270_interrupt.c, zsw_imu.c]
2023-11-14 - Fix broken BMI270 interrupts
    [bosch_bmi270.c, bosch_bmi270_interrupt.c]
2023-11-16 Migrate to NCS SDK v2.5.0 (#107)
    * NCS v2.5.0
    * no partition for non ZS hardware
    * partition for dk
    * PR feedback
    * here we go
    * fix partitions
    * Use NCS Partition manager to put settings in external flash.
    * lvgl patch ad NCS 2.5 does not include a patch for touch input which causes accidental presses.
    ---------
    [main.c]
2023-11-17 BMI270: - Add code for "bmi2_set_gyro_osr" function - Fixes from PR - Add IMU feature enable / disable function via device attributes api
    Misc:
    - Remove Bosch drivers for BMI270 and BMP5 from gitignore
    - Add PCB revision macro to config files
    - Add log level configuration for application
    - Fix CI/CD issue with Kconfig for ZSW sensors - Add missing Kconfig file
    [bosch_bmi270.c, bosch_bmi270.h, bosch_bmi270_interrupt.c, zsw_imu.c]
2023-11-18 Fix native_posix, don't crash if sensor not ready and trying read from it.
    [zsw_imu.c, zsw_light_sensor.c, zsw_pressure_sensor.c]
2023-11-18 Fix NCS include errors in BMI270 and BMP581 driver
2023-11-18 Always enable thread debug info, helps for debugging issues.
    Makes the debugger thread aware.
2023-11-19 Fix external flash when using nRF Partition Manager.
    [zsw_rtt_flash_loader.c]
2023-11-19 Current Time Service (CTS) client (#121)
    * Current Time Service (CTS) client
    also update on read_current_time_cb
    dst
    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
2023-11-19 Fix parsing of gadgetbridge messages.
    [ble_comm.c]
2023-11-20 Do not set timezone on iOS and fix Music Control (#128)
    * Do not set timezone on iOS
    * channel observer for music events
    [zsw_clock.c]
2023-11-20 Ble enhancements#124 (#129)
    * BLE:
    - Add "Subject" field to notification object
    - Remove length check for notification fields, because empty fields have a length of 0 which causes issues with the string termination
    main:
    - Rename log level for main in Kconfig
    - Add log level for main application
    - Use short payload of a notification instead of the long version
    * BLE:
    - Add log level for Bluetooth code
    - Replace include guards with "pragma once"
    Template app:
    - Add log level for template app
    Settings app:
    - Add log level for settings app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
    [ble_comm.c, ble_transport.c]
2023-11-20 Fix iOS notifications not working.
    [main.c]
2023-11-21 Remove `#ifdef` from clock init and also remove "TZ" (#131)
    Time from Gadgetbridge is already corrected for timezone.
    [zsw_clock.c]
2023-11-21 Use system workqueue for BLE RX.
    Saves us bunch of RAM not having a seperate on.
    Helps with thread safety.
2023-11-21 Merge iOS version to Android and have both enabled (#133)
    * always enabled iOS
    * fix docs
    * set needed flags for nRF
    * I can't type
    * Update README.md
    [ble_comm.c, main.c]
2023-11-22 BMP581: - Rename definitions and bind them to BMP581 driver - Add log level for driver
    - Add log level for driver
    APDS9306
    - Add log level for driver
    BMP688:
    - Code refractoring
    - Add VOC measurement
    - Add CO2 measurement
    - Set default temperature offset to 0
    - Remove ambient temperature from Kconfig and measure it during driver initialization
    environment sensor:
    - Add VOC measurement
    - Add CO2 measurement
    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
2023-11-23 Fix max CPU freq. not being used until after display turn off and on again.
    We set cpu freq. when going to active mode, but when we boot, we are alreadt in active mode, but did not set max CPU freq.
    [zsw_power_manager.c]
2023-11-23 Fix display glitching. Randomly turning white or going black.
    Issue was that we would send display enter sleep, while we where at the same tie flushing data to it to display.
    Fixed by making sure rendering finishes and giving the flushing thread some time to flush all data to the
    display before we till the display to go to sleep.
    [zsw_display_control.c]
2023-11-23 Fix crash if multiple clicks register on an app in app picker.
    For example both clicking physical button and touch may at some rare occasions cause double presses causing in an app being
    opened twice => crash.
2023-11-23 accel app: Remove on screen back button, not needed.
2023-11-25 Add popup with yes/no and add setting to erase whole external flash (#144)
    * Add optional Yes/No button to zsw_popup_window.
    * Add setting to erase all settings and resources (external flash).
    * Keep flash logic and boot modes in zsw_flash_loader.
2023-11-25 Fix crash if there is no file table in external flash.
    [zsw_lvgl_spi_decoder.c]
2023-11-26 digital watchface: Show IAQ and CO2 as arc values instead of pressure.
    Colors change depending on how good/bad they are. Low is better.
2023-11-26 Store magnetometer calibration in flash.
2023-11-26 sensor summary app: Add CO2 levels.
2023-11-26 compass app: Add button to calibrate magnetometer.
2023-11-27 HID over GATT and Powerpoint remote App (#148)
2023-11-27 BMI270:
    - IMU gestures don´t need a BMI270 "fetch" call
    Power manager:
    - Add IMU flick in and flick out event to enter inactive mode
    - Add minimum active time of 1 seconds after a wake up
    - Fix wrong axis remapping for revision 3
    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
    [bosch_bmi270.c, bosch_bmi270.h, zsw_imu.c, zsw_power_manager.c]
2023-11-28 Power Manager: - Flick In event don´t put the device into inactive mode when display always on is enabled
2023-11-29 Add board files for HW v4 which use external flash on QSPI.
2023-11-30 Fix timezone handling on Android/GadgetBridge.
    Time from GdgetBridge app is UTC wiht a timezone offset.
    [ble_comm.c, main.c]
2023-12-02 Fix using wrong area in retained RAM.
    Missed to change when cleaning up.
    [zsw_retained_ram_storage.c]
2023-12-03 Add overlay for when mounting the watch rotated in case.
2023-12-05 Notification rework
    commit d8e3d3892bef2eee1229bbe1fd709022eb0d8cf8
    Author: Daniel Kampert <DanielKampert@kampis-elektroecke.de>
    Date: Tue Dec 5 09:22:26 2023 +0100
    - Fix wrong include in 'trivia_app.c'
    - Add lost code for 'trivia_app'
    - Add lost code for time zone settings
    commit 1e348b221918954d387845b517ae2ab1baee30cf
    Merge: 6024526 4475a74
    Author: Daniel Kampert <DanielKampert@kampis-elektroecke.de>
    Date: Tue Dec 5 09:09:37 2023 +0100
    Merge branch 'main' into BLE_enhancements#124
    commit 60245268e0c7d4e20269796cd5302ef00cd03f38
    Author: Daniel Kampert <DanielKampert@kampis-elektroecke.de>
    Date: Thu Nov 30 21:47:59 2023 +0100
    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
    [ble_comm.c]
2023-12-05 Store timezone in retained RAM.
    Otherwise the timezone will be lost after a reset or crash and the time will be off.
    [main.c, zsw_clock.c, zsw_clock.h, zsw_retained_ram_storage.c, zsw_retained_ram_storage.h]
2023-12-05 - Replace remaining include guards in ZSWatch code with "pragma once"
    [dfu.h, zsw_clock.h, zsw_cpu_freq.h, zsw_display_control.h]
2023-12-05 Remove the charger for now. Re-introduce in v5. Closes https://github.com/jakkra/ZSWatch/issues/69#issuecomment-1841627459
    [main.c, watchface_app.c, zsw_charger.c, zsw_phone_app_publisher.c]
2023-12-09 - Move system reset button from top left to bottom right - Increase long press time for system reset to 10 s to match with nPM1300
2023-12-10 BMI270: - Add reset for step counter via offset attribute
    - Add function to reset the step counter
    - Add periodic reset at 00:00 for step counter (needs rework later when RTC is added)
    Battery:
    - Move "vbat" device tree entry into rev 1-4 files
    IAQ app:
    - Align app source name with other apps
    - Add initial measurement during app startup
    - Fix wrong error condition during IAQ sensor value fetch
    Template:
    - Fix broken macro in CMakeLists
    - Remove "sw-top-right", "sw-top-left", "sw-bottom-right" and "sw-bottom-left" because they are unused
    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
    [bosch_bmi270.c, zsw_imu.c]
2023-12-10 Use RTC alarm to reset step counter. Fixes https://github.com/jakkra/ZSWatch/issues/189
    [zsw_imu.c]
2023-12-10 Revert "RTC timer API usage"
    [zsw_imu.c]
2023-12-10 Don't vibrate when battery is low. Fixes https://github.com/jakkra/ZSWatch/issues/190.
    [zsw_power_manager.c, zsw_vibration_motor.c, zsw_vibration_motor.h]
2023-12-11 Compile and add the GATT Sensor server. Add light service. Partly implements https://github.com/jakkra/ZSWatch/issues/116
    [zsw_gatt_sensor_server.c, zsw_magnetometer.c]
2023-12-11 Fix changing connection interval in a ble_connect cb.
    If connection interval update is requested in the scope of a ble_connected callback,
    which is called before the connect callback in ble_comm, the current connection
    would be NULL. Add a retry after a context switch to handle this case.
    [ble_comm.c]
2023-12-11 Update zswatch_nrf5340_cpuapp_4.overlay
    Missed rev4 with the changes for the reset button
    - Set reset time to 10 s
    - Use the bottom right button as system reset
2023-12-11 Switch from NEWLIB NANO to PICOLIB.
2023-12-16 Fix bug causing high current consumption after watch was left stationary and then moved.
    3V3 power was enabled, display initialized, which means display is active, but it should be in sleep.
    Now the display and touch IC is left in sleep state after powering on.
    [zsw_display_control.c, zsw_power_manager.c]
2023-12-16 Define the BMP581 default ODR, to the defaul one set in driver.
    Fixes that power consumption is higher after entering/exiting the sensors summary app.
    [bosch_bmp581.c, zsw_pressure_sensor.c]
2023-12-18 Fix missing custom filesystem functions.
    [zsw_lvgl_spi_decoder.c]
2023-12-21 Fix release build sometimes not booting.
    Crashed due to WDT timeout. Booting specifically on v3 takes sometimes long due to slow flash access.
    [main.c]
2023-12-27 Revert back to using LVGL for screen gestures, fix accidental presses.
    Using touch IC to provide gestures works well, but LVGL is also fed
    the touch input, so when we change screen outside of LVGL, then
    LVGL comes in a state where it's feeding the touch from the gesture
    into the new opened page.
    [main.c]
2024-01-08 Fix watchdog hit on v3 by moving watchdog init to after other init.
    Caused due to the time it can take to init all systems,
    reading init data from flash etc. (especially on v3 with none QSPI flash).
    the watchdog if unlucky could hit and the watch would never boot.
    [main.c]
2024-01-08 Fix PPT App not removing itself correctly after exit.
    Caused due to buttons not created in the root container that is deleted on exit,
    hence they would show behind other UI even after app closed.
2024-01-21 Hardware submodule update. Fix switch footprint Fixes https://github.com/jakkra/ZSWatch-HW/issues/11
    Fix soldermask in switches footprint.
2024-01-21 Hardware submodule update. Decrease production files Other.zip
    Due to PCBWay file upload limit. Images are now cropped.
2024-01-25 Fix display not waking up going directly from stationary -> active state.
    The case is when the watch is stationary and woken up by touch or buttons without being first moved.
    I.e. going from state stationary -> active.
    [zsw_display_control.c]
2024-02-02 Proper handling of display backlight. Fixes https://github.com/jakkra/ZSWatch/issues/221
    [main.c, zsw_display_control.c]
2024-02-15 add Sensor-Fusion submodule
2024-02-15 Sensor Fusion added. Accelerometer app replaced with Sensor Fusion app.
    [zsw_magnetometer.c]
2024-02-21 Fix not being able to open apps on nRF5340DK.
    Cause by not overriding button 0 in nRF5340-DK board files, causing duplicated INPUT events being generated for button press.
2024-02-21 Fix nRF5340-DK display code crashing to counter device being NULL.
2024-02-26 Fix native_sim crashing to to not having a timer.
    [zsw_display_control.c]
2024-02-26 Fix closing notifications also causing press on element behind it.
    Fixed by handling clicks on release instead on press.
    [zsw_display_control.c]
2024-02-27 App manager: Move close button to external QSPI flash.
2024-02-27 Actually use QUAD SPI, default is only one data line...
2024-02-27 Use raw filesystem as littlefs have issues with caching running out of memory.
    [zsw_lvgl_spi_decoder.c]
2024-02-27 Popup a warning window on boot if files are missing in external flash.
    [main.c, zsw_filesystem.h, zsw_lvgl_spi_decoder.c]
2024-02-29 Fix notification popup up not showing after stationary state.
    [main.c]
2024-03-01 Trivia app: Fix buttons not deleted after app close.
2024-03-05 Notifications: Replace icons with colored icons. Add Google Cal notification type.
    [astyle.cfg]
2024-04-06 - Add emulated GPIO SDL driver to support the input buttons of the watch in POSIX build
2024-04-14 pmic: Configure interrupts. Publish battery event.
2024-04-14 nPM1300 app: Replace plot of state with just current stats.
2024-04-14 nPM1300 App: Store battery history in flash. UI improvements.
2024-04-14 Initial PCB v5 board files.
2024-04-14 nPM1300: Use actual profile of our battery foor fual guage.
2024-04-14 Temp fix for soldered flash, will change to one with 4K sector size later.
2024-04-14 Refactor battery handling so v5 PMIC code and pre v5 simple battery voltage divider works cleanly.
2024-04-14 Battery App: PMIC and pre v5 (none pmic) now use the same battery app.
2024-04-14 battery app: Move missed icon to external flash.
2024-04-14 Update Kconfig
    Set default PCB revision in Kconfig to 5
2024-04-14 Update native_posix.conf
    POSIX doesn´t work with PCB_REV set to 5
2024-04-14 - Add option to disable system reset in Kconfig - Enable system reset in debug mode, disable system reset in release mode
    [main.c]
2024-04-14 Battery app: Fix some color and alignment issues.
2024-04-17 Add zephyr boards for nRF VScode plugin to pick them up.
    Used to work, but maybe something changed in the plugin.
2024-04-17 coredump: Add coredump menu in settings.
    Will move to a standalone app later.
    Settings app: Adjust size so menus doesn't show outside of screen.
    Scrolling will now start earlier.
    [zsw_coredump.c]
2024-04-19 popup: Fix crash when popup was closed by the close button.
    Cause due to LVGL not calling our on press callback, as the object got deleted in the previous callback
    that was added lv_msgbox. Fix is to remove all event callbacks for the close button so only
    ours exist. We make sure to close the lv_msgbox ourselves instead.
2024-04-20 RTT Flash Loader: Add CRC to each transfer to log if there was any byte errors.
    [zsw_rtt_flash_loader.c]
2024-04-20 RTT Flash Loader: Add option for JLink speed in case auto speed is unreliable.
2024-05-02 Some fixed for v5.
    [zsw_display_control.c]
2024-05-02 Fix power managing of touch chip.
    [input_cst816s.c, zsw_display_control.c, zsw_power_manager.c]
2024-05-02 Buzzer: Add initial buzzer support.
    [input_cst816s.c, main.c, zsw_buzzer.c, zsw_buzzer.h]
2024-05-06 Add support for short and long dates
    [watchface_app.c]
2024-05-06 Rename value argument in set_battery for watchfaces to battery
2024-05-06 Add support for optional assets from the ESP32 LVGL watchface repository
2024-05-06 Watchfaces: Add new watchface.
    Generated using: https://github.com/Kampi/esp32-lvgl-watchface
    Command: ./generate.sh https://github.com/fbiego/watch-face-wearfit/raw/main/dials/HW21/107_2_dial.bin
    https://github.com/fbiego/watch-face-wearfit/raw/main/dials/HW21/107_2_dial.png?raw=true
2024-05-06 watchface app: Store/keep selected watchface after reboot.
    WIP
    [watchface_app.c, zsw_settings.h]
2024-05-06 watchface picker: When opened scroll to the currently selected wathchface.
2024-05-06 Watchfaces: Add a few new watchfaces.
    Generated using: Generated using: https://github.com/Kampi/esp32-lvgl-watchface
    Faces:
    https://github.com/fbiego/watch-face-wearfit/raw/main/dials/HW21/116_2_dial.bin
    https://github.com/fbiego/watch-face-wearfit/raw/main/dials/HW21/66_2_dial.bin
    https://github.com/fbiego/watch-face-wearfit/raw/main/dials/HW21/70_2_dial.bin
    https://github.com/fbiego/watch-face-wearfit/raw/main/dials/HW21/73_2_dial.bin
    https://github.com/fbiego/watch-face-wearfit/raw/main/dials/HW21/79_2_dial.bin
    https://github.com/fbiego/watch-face-wearfit/raw/main/dials/HW21/80_2_dial.bin
    https://github.com/fbiego/watch-face-wearfit/raw/main/dials/HW21/84_2_dial.bin
2024-05-06 Move QSPI config from prj.conf to board specific as v3 < does not have QSPI.
2024-05-08 - Add missing offsets for month and year
    [zsw_clock.c]
2024-05-08 The month is no longer increased by one in the core dump
    [zsw_clock.h, zsw_coredump.c]
2024-05-08 Watchface: Fix one watchface not using percent in battery percent.
2024-05-08 Fix some rease conditions where for example a watchface would get rendered inside app picker.
    [main.c, watchface_app.c]
2024-05-10 PMIC: Read the battery at init so there is a cached value if battery read before next readout.
    Fixes sending 0% battery to app which cause low batetry notifications.
    [zsw_pmic.c]
2024-05-17 pmic: Fix issue due 3V3 not getting enabled in time for Display driver init, causing display to glitch.
2024-05-17 watchface dropdown: Add battery icon reflecting charge, time to empty, percent.
    Also adjust the UI, making buttons round and changing the brightness slider icon.
2024-05-17 watchface quick menu: Advoid pressing buttons when dragging. Match color of brightness slider with button color.
2024-05-27 - Add skeleton for RV-8263-C8 RTC - Rename display driver to match it with the vendor_type scheme of the other drivers - Remove Funkytown song from Buzzer driver - Disable selecting of the step count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
    [bosch_bmi270.c, buydisplay_gc9a01.c, zsw_buzzer.c]
2024-05-27 Feature Generic History Storage for e.g. sensor data.
    - Adds a component that simpifies storage of sensor reading to flash.
    - Handles automaticallt removing old data etc.
    - Easy way to read out.
2024-05-28 - Update bosch_bmi270_types.h - Add RV-8263-C8 driver - Couple smaller changes
2024-05-31 Workaround for Linux build getting black screen on some computers.
    See issue for more details https://github.com/zephyrproject-rtos/zephyr/issues/71410
    Workaround is to run lv_task_handler from main thread and disable CONFIG_LV_Z_FLUSH_THREAD.
    [main.c, zsw_display_control.c]
2024-07-04 Fix charging status not being sent to phone correctly.
    [zsw_phone_app_publisher.c]
2024-07-13 Weather app: Fetches GPS data from phone and uses it in a HTTP request over BLE to fetch forecast and current weather.
2024-07-13 watchface app: Save some RAM by not storing a copy of last BLE message.
    Also fixes possible loss of data if let's say one music and one weather come fast
    after eachother before workqueue been processed.
    [watchface_app.c]
2024-07-15 nPM1300: Fuel Guage: Fix missed changed in the fuel guage API since NCS 2.6
    [zsw_pmic.c]
2024-07-15 nPM1300: Fuel Guage: Support enter ship mode and battery cutoff.
    Ship mode turns off all power and enters lowest possible state.
    To exit ship mode BTN 3 needs to be pressed.
    Added safety for battery to enter ship mode when the battery is low voltage,
    but not low enough to trigger the battery protection circuit (typically at 3.0V).
2024-07-15 Add new battery model for v5 battery.
2024-07-15 Final v5 does not have USB switch powered by 3V0. Rename accordingly.
2024-07-16 - Add patch to port RV-8263-C8 driver from upstream Zephyr to ZSWatch Zephyr - Move patches from "zephyr_patches" directory into "patches" directory - Remove "zephyr_patches" directory - Add RTC to f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
2024-07-17 Demote pylink log messages
    Too much stuff printed
2024-07-17 Print INFO log on green color on RTT (#315)
    * Print INFO log on green color on RTT
2024-07-21 hw-test: constantly read RTT logs in order to prevent RTT block
    RTT works in block mode where the last message is not printed if the buffer is full, since the buffer is small by adding a delay, the last message was not print.
2024-07-28 Take version from board overlay
2024-07-30 Custom LVGL FS: Make sure all reads are aligned to avoid multiple sperate reads to external flash.
    Make all reads from external flash aligned as the QSPI driver will split
    uniligned reads into 2-3 seperate reads (depending on if both start and end address is unaligned).
    Now instead make sure all reads are aligned by reading into a temporary buffer.
    [zsw_lvgl_spi_decoder.c]
2024-08-06 Add option for relative battery scale and set limit for battery arc
2024-08-06 Fix touch sometimes not working after watch have been stationary and 3V3 been off.
    Making sure to reset and re-init the driver each time seems to fix it.
    [input_cst816s.c]
2024-08-07 Add patch for BMP5 sensor API to fix an uninitialized variable warning
2024-08-07 Remove double entry, remove UART disabling for rev >3 because it is disabled in DT, add it to board config for rev 1 and 2
2024-08-08 nRF system reset is disabled for rev 5 and above now
    [main.c]
2024-09-04 App Manager: Send back button presses to applications and let them consume it instead of always exiting the app.
    In settings app finally back button won't exit the app if pressed when inside a sub menu. Instead it will go back one menu level.
2024-09-12 zsw_clock: Adjust the RTC time according to the timezone and fix time when not using RTC.
    [main.c, zsw_clock.c, zsw_clock.h]
2024-09-12 periodic_event: Don't use RTC for 1s event.
    It complicates the code and really doesn't add a anything.
    [main.c, zsw_clock.h, zsw_periodic_event.c]
2024-10-09 Timer and Alarm app.
    Create timers or alarms. Utilizing the RTC on v5 PCB for timers and alarms.
2024-10-09 Digital watchface: Show battery percent by default.
2024-10-09 Publish pressure data every 10s instead of 1s to save some battery.
    Anyone wanting faster update rate can change odr and then poll.
    A future improvement could be based on the set ODR, automatically change the publishing frequencey.
2024-10-09 wachface dropdown: When charger is connected, then power button will reset the system.
    Powering down is not supported by the nPM1300 when charger is connected,
    instead of button not doing anything, we now just do a system reset.
    [main.c, zsw_pmic.c, zsw_pmic.h]
2024-10-10 When step counter is reset at midnight, also publish step event with 0 steps.
    [zsw_imu.c]
2024-10-13 timers: Add alarm buzzer and vibration patterns when timers expire.
    [zsw_buzzer.c, zsw_buzzer.h, zsw_vibration_motor.c, zsw_vibration_motor.h]
2024-10-16 Overlay for disabling RTC. Some builds of v5 PCB require patching, or disable RTC.
    This adds option to not having to patch the PCB and instead just disable the RTC feature of v5.
2024-10-16 Fitness app: Extract setep counting reset into an app.
    The fitness app is hidden for now, but this is the app to add UI and logic for showing graphs of
    daily steps, calories etc.
    [zsw_imu.c]
2024-10-24 zsw_imu: Add step counter offset set.
    If watch is reset the BMI270 step counter is reset. Add function to insert an offset
    making the fetch_num_steps function return for example the steps today.
    [zsw_imu.c]
2024-10-24 Fitness App: Use latest steps and not latest stored steps as current steps.
2024-10-27 New icons for Fitness and Sensor Fusion apps.
2024-10-27 Sensor Fusion: Return error if necessary HW is not ready.
    For example when building for native_posix.
2024-10-29 BT: Use ACL flow control, not having this caused running out of ACL buffers.
    Must enable this when BLE Controller is running on another core.
    This fixes various issues with currupt and lost BLE packets.
2024-10-29 Fitness App: Make stored steps sample smaller as it passed max setting size.
    struct rtc_time use int for all members, but this is not needed. Introduce a minimized variant of sample time.
    Now consumes much less bytes per step sample.
2024-10-29 zsw_history: Make sure samples cannot exceed one NVS page.
    When using NVS as settings backend the stored data can't exceed the page size. Add an assert for this.
2024-12-16 Migarte ZSWatch board to Zephyr HW Model V2.
2026-10-13 ui: Confirm removing paired devices and load settings pages on demand
2026-10-13 ble: Bound parser input for ZDS-001 ZDS-002 ZDS-003 ZDS-004 ZDS-005 ZDS-008 ZDS-009
    Validate Chronos assembly and weather, version, and icon payloads before changing state. Bound Gadgetbridge text conversion and terminate full receive buffers. Parse AMS elapsed time from validated playback fields.
2026-10-14 WIP(altimeter_app): fix some issues, clean up, add clibration, add power managment.
2026-10-14 WIP(altimeter): enhance altitude data channel with calibration flag and floor counters
2026-10-14 fix(altimeter_app): remove redundant comment in periodic calibration handler
2026-10-17 ci: Add MemBrowse memory footprint tracking
2026-10-18 notifications: Only report user dismissals to the phone
    Every removal from the notification manager sent DISMISS to the phone,
    including evicting the oldest notification when the 10-slot list is full
    and removals the phone itself requested. A burst of more than 10
    notifications therefore cleared the oldest ones on the phone although the
    user never saw or dismissed them, and phone removals were echoed back.
    Carry a removal reason in zsw_notification_remove_event and send DISMISS
    only for ZSW_NOTIFICATION_REMOVED_BY_USER.
    Verified on WatchDK with RTT: notifications 11 and 12 evicted the oldest
    two on the watch and all 12 stayed on the Android phone.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
2026-10-18 west: use MAX32664C driver fixes
    Point the driver module at zswatch_hr_fixes, based on master:
    - hr: serialize hub polling and stop commands
    - hr: only exit wake-on-motion when it is active
    - hr: preserve fresh reports and skin-contact states
2026-10-18 hr: handle repeated PM transitions and report failed stops
    Treat -EALREADY from resume and suspend as success, propagate other
    resume failures, and log when sensor shutdown fails instead of always
    reporting a clean stop.
2026-10-18 hr: preserve fresh reports and skin-contact states
    Keep the full SCD state next to the on-skin flag, do not count the
    driver's empty-queue results as read failures, and start the UI without
    placeholder pulse values.
2026-10-18 bmi270: avoid resetting after configuration upload
    bmi270_init already resets and uploads the configuration. A second soft reset caused cold-start IMU detection failures; three hardware cold starts passed after removing it.
2026-10-18 codec: discard unused relocated Opus sections
    Allow section garbage collection for relocated Opus text and constants. The watch comparison build removes decoder entry points while retaining the encoder API and saves 25,664 bytes of external flash.
2026-10-18 mic: remove unused RTT audio output
    Remove microphone RTT output, its settings, UI toggle and obsolete capture script. Default to raw callbacks for the spectrum app and keep file recording. Stop enabling RTT in normal microphone board profiles; RTT logging and the optional flash loader can still enable it explicitly.
2026-10-18 partition: bound watch app to the MCUboot primary slot
    Reserve the 48 KiB gap after the primary slot so Partition Manager does not grow the dynamic app region into it. A pristine sysbuild now reports an 867,840-byte linker region ending at 0xe4000. All existing slot and storage addresses and sizes are unchanged.
2026-10-18 display: shut down devices before cutting their supply
    Run display and touch TURN_OFF callbacks while their 3.3 V supply is still enabled. The touch callback performs I2C initialization and sleep writes, which failed after the supply was removed. Real-watch testing reproduced the fault before this change and passed five full sleep/wake cycles afterward without touch I2C errors.
2026-10-18 shell: add filtered thread stack usage query
    Report reserved, used and unused stack bytes for matching thread names.
    Filtering keeps BLE dummy-shell replies small enough to inspect.
2026-10-18 hr: right-size the acquisition stack
    Use 1536 bytes for the plotting-enabled acquisition thread. Measured peak
    use was 680 bytes during HR, UI, recording and repeated start/stop tests.
    The non-plotting 1024-byte allocation is unchanged.
2026-10-18 hr: check the hub before reading its firmware version
    The init hook read the MAX32664C firmware version before checking that the
    alias exists and the device is ready. Check first and name the supplies
    and pins to inspect when the hub is not ready. Use the void SYS_INIT
    signature.
2026-10-18 lvgl_editor: drop chart and bar shims now provided by LVGL
    The current LVGL exposes lv_chart_set_axis_min/max_value,
    lv_chart_set_hor/ver_div_line_count, lv_bar_set_min/max_value and
    lv_bar_bind_value, so the local inline versions conflict with them.
2026-10-18 hr: only build the HR app when heart rate is available
    Gate the app on APPLICATIONS_USE_HR, enabled by default when a MAX32664C
    is in the devicetree or on native_sim, where the app shows generated
    data. Watches without the HR hub no longer get an HR app that cannot
    show measurements.
2026-10-18 zswatch: add opt-in heart rate addon build variant
    Most ZSWatch rev 1 units have no HR addon PCB, so keep the default build
    unchanged and enable the MAX32664C hub through an extra config and overlay.
    The overlay also keeps LDO1 (VHR, shared with the microphone) on.
    CI builds the variant for zswatch@1 debug to catch HR regressions.
2026-10-18 partition: bound WatchDK app to the MCUboot primary slot
    Reserve the 48 KiB gap after the primary slot, as on the watch, so the
    linker region ends at 0xe4000 (867,840 bytes). Slot and storage
    addresses are unchanged.
2026-10-18 hr: disable raw data plotting by default
    The plotting define made the acquisition thread poll every 10 ms and print a CSV line per report, ignoring the requested interval. Keep it as an opt-in debug switch.
2026-10-18 production_test: check the HR hub before updating its firmware
    setup_hr_firmware() returned a value from a void function, called the driver without including its header, passed a possibly missing hub to the driver and ignored update errors.
2026-10-18 hr: read the acquisition thread under the lock when registering a callback
    zsw_hr_register_callback() read hr_state.thread_id after releasing the lock, unlike zsw_hr_set_sampling_interval().
2026-10-18 hr: only allow the HR app where its driver exists
    Enabling the app by hand on a board without the MAX32664C failed at link time.
2026-10-18 west: update MAX32664C driver fixes
    Keep polling when stopping the algorithm fails.
2026-10-18 production_test: take the HR hub firmware from the driver module
    The firmware header was never committed under app/src/ext_drivers/firmware, so the WatchDK production test could not build. The MAX32664C module already ships the same image.
2026-10-18 hr: update copyright year of the HR driver wrapper
2026-10-18 hr: only poll for samples when the sensor started
    After a failed start the update timer could show the last sample of a previous session.
2026-10-18 watchdk: move heart rate support to an opt-in build variant
    The MAX32664C sits on a separate extension board, so normal WatchDK builds should not include it. Mirror the ZSWatch HR variant with watchdk_nrf5340_cpuapp_hr.overlay/.conf, keep the hub node in the production test through that overlay, and build the variant in CI for both boards.
2026-10-18 Docs: Update documentation for #579
    Update documentation to reflect the new Heart Rate (HR) application and sensor integration:
    - Added HR app as reference example for LVGL Editor UI pattern in writing_apps.md
    - Updated system architecture diagram to include Heart Rate sensor and app
    - Added HR driver documentation in sensor data flow section
    Related to PR #579 which adds:
    - New HR (heart rate) application using MAX32664C biometric sensor
    - New HR driver with periodic and continuous measurement modes
    - LVGL Editor-based multi-screen UI (overview, debug, graph pages)
2026-10-19 HR: Update driver and fix sampling thread wakeup.
    Use the merged MAX32664C changes. Use a semaphore to wake the sampling thread and allow retrying a failed stop.
    Disable the in-tree Zephyr MAX32664C driver with a patch, the driver module provides it and the duplicated binding broke the HR builds.
2026-10-19 Reduce idle current and track IMU motion from boot.
    Turn off the touch level shifter with the display and let unused UART hardware sleep. Same UART fix for WatchDK and Legacy v5.
    Use 50 Hz accelerometer sampling while stationary. Keep 100 Hz when the gyro is in use. UART logging builds keep the UART enabled to avoid scrolling stutter.
2026-10-19 HR: Add background measurements and saved mode selection.
    Add Off, Background and Continuous modes, plus manual measurements.
    The manager controls the sensor independently of the app and stores accepted readings for the graph. Stop a background attempt when a reading is accepted or after 45 seconds without a result.
2026-10-19 Add shell commands for HR and power testing.
    Add mode selection, manual measurement, cancel and status commands. Also add motion injection, sleep/wake commands and stack usage.
2026-10-19 HR: Turn off the shared HR and mic supply when HR is stopped.
    LDO1 powers both the HR addon and the mic and was always on in HR builds, around 70 uA extra when the watch is stationary. Now HR and the mic each enable it only when needed. The hub is reset and configured again before the next measurement.
2026-10-19 boards: use 32-bit QSPI addressing for user storage above 16 MiB
    User storage crosses 16 MiB on the MX25U51245, where 24-bit addresses
    alias other partitions. Enable 4-byte addressing in the board and the
    nrfjprog QSPI config, and assert it at build time.
2026-10-19 ui: ignore hardware input until startup is complete
    The input callback is registered at boot, so touch events could reach the
    power and UI managers before they were initialized.
2026-10-19 ble: let the SMP transport own connection parameters
    Enable MCUMGR connection parameter control (7.5 ms while SMP is active)
    and use CONFIG_BT_PERIPHERAL_PREF_* for the idle interval so both paths
    agree. Keep the parameters across SMP service reconnects, send each BLE
    log line as one NUS message, report partial NUS sends, and restart sensor
    notifications when a bonded peer rewrites an enabled CCCD.
2026-10-19 ble: bound the Find vibration and stop it on disconnect
    Move Find device handling into ble_find_device.c, limit how long it runs,
    and stop only the Find pattern when the phone disconnects.
2026-10-19 ble_http: complete each request once and decode Gadgetbridge strings
    Every admitted request now gets exactly one callback, also on relay
    errors and malformed replies, and the response is borrowed instead of
    copied. HTTP replies are decoded as JavaScript strings (\x, octal and
    atob escapes) since Gadgetbridge does not send strict JSON. The UTF-8
    conversion buffer is moved off the BLE workqueue stack.
2026-10-19 ci: Remove duplicated builds in CI by running MemBrowse from the build job
    The MemBrowse report workflow rebuilt the release firmware for the four
    watch boards on every PR and push, duplicating build.yml's release matrix
    row. Run the MemBrowse action inside the build job instead, after the
    normal-orientation release build, on pull_request and push only.
    - The MemBrowse step is non-blocking and does not fail on budget alerts.
    - The build matrix no longer fails fast, so one failing variant does not
    cancel the other boards' builds, artifacts and reports.
    - Internal PRs get the MemBrowse comment from ci.yml right after the build
    job; membrowse-comment.yml handles fork PRs via workflow_run.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
2026-10-19 Docs: Add HR Manager documentation to architecture overview
    Add documentation for the HR Manager that was introduced in #595.
    Includes the three HR modes (Off, Background, Continuous), their power
    characteristics, and key features like mode control, manual measurements,
    history tracking, and motion-aware scheduling.
2026-10-20 boards: zswatch_legacy: use 32-bit QSPI addressing on v5
    v5 has the same MX25U51245G as the newer boards and its user storage
    also crosses 16 MiB, so the user storage BUILD_ASSERT failed. Enable
    4-byte addressing in the overlay and the nrfjprog QSPI config.
2026-10-20 ble: preserve full-MTU notifications and batch sensor updates
2026-10-20 drivers: leave 4-byte flash addressing before every reset
    The external flash is put in 4-byte address mode at boot since user
    storage crosses 16 MiB. The flash keeps that mode over a soft reset, but
    bootloaders flashed before that change use 24-bit addressing. They then
    fail to validate the image in external flash and stay in serial recovery
    after the first reboot of a watch updated to the new firmware.
    Wrap sys_arch_reboot() at link time and send EX4B first, so mcumgr
    resets, fatal errors and all other sys_reboot() callers leave the flash
    in 3-byte mode. Resets that bypass the firmware, such as from a debugger,
    still need a power cycle with an old bootloader; document that on the
    firmware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
2026-10-20 pytest: use a 32-bit flash addressing build for firmware update tests
    The firmware update tests upload the committed v0.7.0 package. It uses
    24-bit flash addressing, but the current bootloader leaves the flash in
    4-byte mode when it starts the application, so v0.7.0 crashes on its
    first access to external flash. Use a current WatchDK debug build
    instead; the tests check the update paths, not a downgrade to old
    firmware.
2026-10-20 drivers: only leave 4-byte flash addressing on WatchDK
    Only WatchDK has shipped with bootloaders that use 24-bit flash
    addressing; ZSWatch watch@1 has not been released yet. Build the
    sys_arch_reboot() wrapper for WatchDK only.
2026-10-20 website: show the old bootloader note only for WatchDK
    Shorten the firmware update page note, say that it only applies to
    WatchDK bootloaders from before 2026-10-19 and fold it away. The web
    updater reads the board from the dfu_application.zip manifest and shows
    a short, collapsed hint when a WatchDK package is selected.
2026-10-20 pytest: add shared bench helpers for BLE, PPK2, SWD and the toolchain
    Investigation scripts kept reimplementing the same pieces. Move them into
    app/pytest/bench so pytest and ad hoc scripts share one copy:
    - bench.ble: one connection with SMP shell and NUS, GB commands and replies
    - bench.ppk: PPK2 as the battery, kept open between captures by a server
    - bench.swd: read firmware variables by ELF symbol over J-Link
    - bench.toolchain: run west and nrfjprog in the nRF Connect toolchain
    The PPK2 metadata read fix moves into ppk2_helper and the supply voltage
    can be set per device. Desk setups are bench_only entries in devices.yaml,
    which pytest skips unless selected with --board.
2026-10-20 ble: let ble_comm own the connection interval through reasons
    The interval was set from three places that did not know about each
    other: the SMP manager, the GATT sensor server and MCUmgr's own
    connection parameter control. With SMP enabled, ble_comm ignored the
    sensor server and MCUmgr restored the long interval a few seconds after
    SMP traffic, even while sensors were still streaming. The short interval
    also used CONFIG_BT_PERIPHERAL_PREF_*, which now hold the long idle
    interval, and nothing asked for it on connect, so a central that reuses
    the previous long interval (BlueZ does) made SMP clients time out.
    Keep one bit per reason (discovery after connect, sensor notifications,
    SMP traffic)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
2026-10-20 smp: switch to the short connection interval as soon as SMP is enabled
    Enabling SMP over BLE means a firmware update or file transfer is about
    to start. Waiting for the first SMP command made it begin at the idle
    interval, and the switch from there takes a few seconds. Request the
    short interval on enable and hold it for 15 s, so the phone has time to
    rediscover services and start; SMP commands keep it short after that.
2026-10-20 ci: pin membrowse-action to v1.2.15
    v1.2.16 (released 2026-10-20) puts ${{ github.workspace }} in an input
    description in action.yml. The runner evaluates it while loading the
    action and fails with "Unrecognized named-value: 'github'", so every
    build job using @v1 fails before compiling. Pin all uses to the v1.2.15
    commit.
2026-10-20 pytest: realign PPK2 samples
    ppk2_api never realigns its 4-byte samples, so a capture starting
    mid-sample read a flat ~157 mA from an idle watch. Used by both the power
    tests and bench.ppk.
2026-10-20 ble: close the pairing window from internal flash
    The settings app timer ran from XIP and bus faulted when it expired with
    the display asleep.
2026-10-20 info: update connection details from the LVGL timer
    The BT callbacks called into XIP and LVGL from outside the LVGL thread,
    crashing on an interval change with the display off.
2026-10-20 ancs: only release our own connection reference
    A disconnect without a matching connect released current_conn twice and
    hit the bt_conn ref count assert.
2026-10-20 fix: resolve merge conflict in parse_musicinfo function and clean up artist, album, and track extraction logic
2026-10-21 Add AGENTS.md for coding agents
    Replace .github/copilot-instructions.md with AGENTS.md, which Codex and
    Copilot read directly and Claude Code reads through CLAUDE.md. Bring the
    content up to date: NCS v3.3.0-preview1, the zswatch@1 board and HR
    variant, the current shell commands, test mode, and the bench tools in
    app/pytest/bench.
    Move the website instructions to website/AGENTS.md and update them for
    Watch Tools, the docs workflow and the build checks. The Copilot
    website instructions now only point there.
2026-10-23 Drop review-flagged comments, use a dash in the device name
2026-10-23 Allow five concurrent BLE HTTP requests
    Weather and altimeter both request on a fresh GPS fix. The second got
    -EBUSY and the weather app ignored it, showing neither data nor an error.
    Track five in-flight requests, each with its own callback and timeout,
    and show the weather error on any send failure.
2026-10-23 Shrink MAX32664C buffers so the HR variant fits in RAM
    The debug HR build overflowed RAM by about 1.7 KB in CI. Algorithm mode
    reports once per second and the driver polls twice per report, so 4 queued
    reports and 32 FIFO samples are plenty. Saves 4832 B.
2026-10-26 Correct ZSWatch rev 1 IMU axes for wrist wake
2026-10-26 Add ZSWatch assembly guide and shared quick start
    Add an assembly guide for the ZSWatch with photos and a short video, and merge the WatchDK quick start into one page with ZSWatch/WatchDK tabs. Redirect the old watchdk-quickstart URL, document the USB-C debug pinout, add zswatch@1 to the board table and add the Watch-3D case repository as a submodule.
2026-10-26 Document ZSWatch firmware updates, debugging and heart rate extension
    Cover the ZSWatch next to the WatchDK in firmware updates, debugging, image resources and compiling, and add a short page for the heart rate extension board.
2026-10-27 Add photos of the assembled ZSWatch to the docs
    Replace the placeholder quick start photo and add photos of the finished watch to the assembly guide and the hardware overview.
