jakkra/ZSWatch/(notices)

Notices in the files:
app/src/zsw_battery_manager.c:
This program is free software: you can redistribute it and/or modify
it under the terms of the GNU General Public License as published by
the Free Software Foundation, version 3.
README.md:
License: GPL 3.0
parts and their libraries:
Copyright 2021 Accelerated Designs. All rights reserved.
